louisflakes/IphoneFM/design/rev-b/front-panel-candidates.png

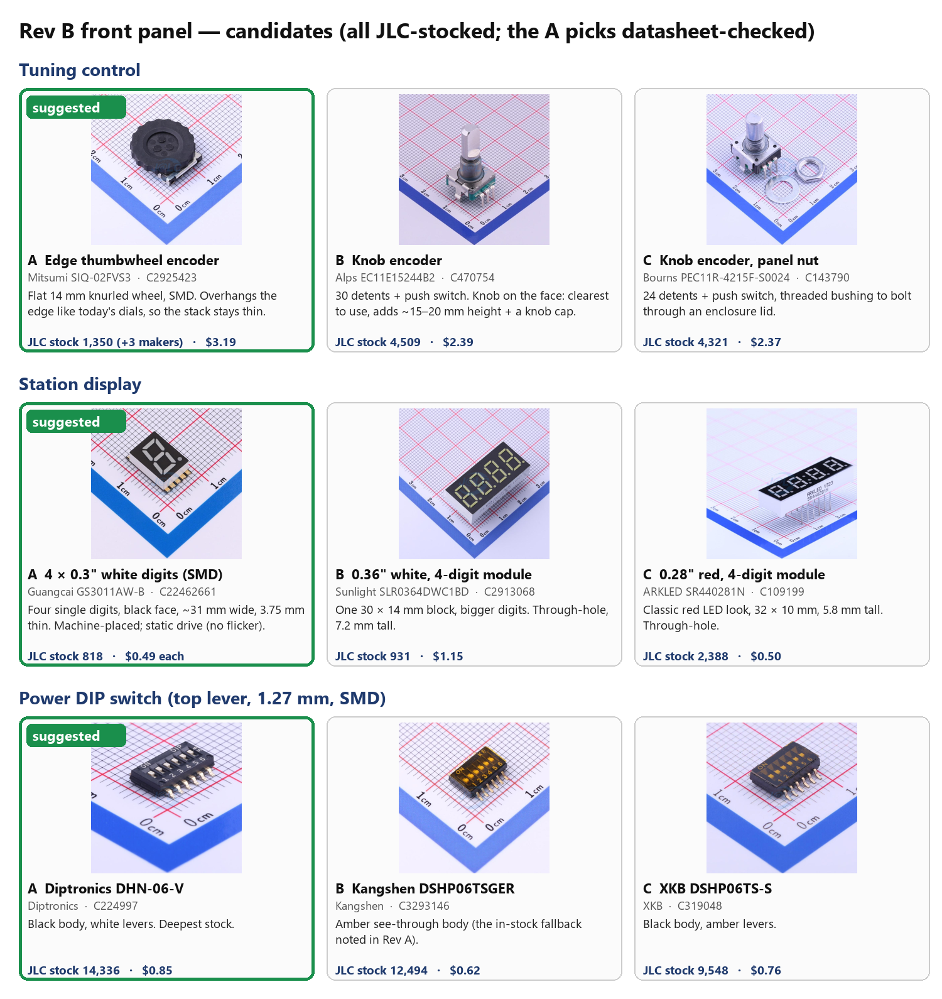
design/rev-b/front-panel-candidates.png
