louisflakes/IphoneFM/kicad/rev-b/README.md

KiCad project for IphoneFM Rev B: Rev A (tag rev-a-reviewed) with the new front panel. Built from ../../design/rev-b/build-procedure.md; checked with ../../tools/kicadcheck.py (IPHONEFM_REV=rev-b).
