louisflakes/IphoneFM/review/rev-a/README.md

# IphoneFM Rev A — design review

Start with **[IphoneFM-RevA-design-review.pdf](IphoneFM-RevA-design-review.pdf)** (4 pages). It cites datasheet pages;
the documents are linked below.

| File | What it is |
|---|---|
| [IphoneFM-RevA-design-review.pdf](IphoneFM-RevA-design-review.pdf) | Overview, key numbers, main parts, each signal chain on the schematic, what to check |
| [IphoneFM-RevA-schematic.pdf](IphoneFM-RevA-schematic.pdf) | The schematic, one A2 sheet |
| [IphoneFM-RevA-gerbers.zip](IphoneFM-RevA-gerbers.zip) | Gerbers and drill files of the JLC panel (one board in rails) |
| [IphoneFM-RevA-BOM.csv](IphoneFM-RevA-BOM.csv), [IphoneFM-RevA-CPL.csv](IphoneFM-RevA-CPL.csv) | Parts list and placement file in JLC's format |
| [IphoneFM-RevA-assembly.pdf](IphoneFM-RevA-assembly.pdf) | Assembly drawing, every reference, both sides |
| [IphoneFM-RevA-board-top.png](IphoneFM-RevA-board-top.png), [IphoneFM-RevA-board-bottom.png](IphoneFM-RevA-board-bottom.png) | The board as built, drawn from the Gerbers |
| [kicad/rev-a/](../../kicad/rev-a/) | KiCad 10 project (schematic, board, rules, footprints) |

## Datasheets cited

- [U6_USBLC6-2_ST_DS4260_Rev7.pdf](../../docs/datasheets/plan-c/U6_USBLC6-2_ST_DS4260_Rev7.pdf)
- [D3-D4_TPD1E05U06_TI.pdf](../../docs/datasheets/plan-c/D3-D4_TPD1E05U06_TI.pdf)
- [U3_AP2112_DS39724_Rev2-2.pdf](../../docs/datasheets/plan-c/U3_AP2112_DS39724_Rev2-2.pdf)
- [U1_STM32U535_DS14217_Rev5.pdf](../../docs/datasheets/plan-c/U1_STM32U535_DS14217_Rev5.pdf)
- [U1_ST_AN2606_bootloader_Rev61.pdf](../../docs/datasheets/plan-c/U1_ST_AN2606_bootloader_Rev61.pdf)
- [XO_YXC_OT322520MJBA4SL.pdf](../../docs/datasheets/analog-fm/XO_YXC_OT322520MJBA4SL.pdf)
- [PLL_TI_LMX2571_SNAS654A.pdf](../../docs/datasheets/analog-fm/PLL_TI_LMX2571_SNAS654A.pdf)
- [AN_TI_SNAA309_LMX2571_FSK.pdf](../../docs/datasheets/analog-fm/AN_TI_SNAA309_LMX2571_FSK.pdf)
- [ATT_pSemi_PE43711.pdf](../../docs/datasheets/analog-fm/ATT_pSemi_PE43711.pdf)
- [U5_PE42421_DOC-33214-1.03.pdf](../../docs/datasheets/plan-c/U5_PE42421_DOC-33214-1.03.pdf)
- [ESD_Semtech_RClamp0521PA_Rev4.pdf](../../docs/datasheets/analog-fm/ESD_Semtech_RClamp0521PA_Rev4.pdf)
- [U4_Si4704-05-D60_Rev1.2.pdf](../../docs/datasheets/plan-c/U4_Si4704-05-D60_Rev1.2.pdf)
- [U4_Skyworks_AN332_programming_guide.pdf](../../docs/datasheets/plan-c/U4_Skyworks_AN332_programming_guide.pdf)
- [U4_Skyworks_AN383_antenna_layout.pdf](../../docs/datasheets/plan-c/U4_Skyworks_AN383_antenna_layout.pdf)
- [D1_XINGLIGHT_XL-1615RGBC-RF.pdf](../../docs/datasheets/analog-fm/D1_XINGLIGHT_XL-1615RGBC-RF.pdf)
- [J1_HRO_TYPE-C-31-M-12.pdf](../../docs/datasheets/analog-fm/J1_HRO_TYPE-C-31-M-12.pdf)
- [J2_BAT_BWSMA-KWE-Z001.pdf](../../docs/datasheets/analog-fm/J2_BAT_BWSMA-KWE-Z001.pdf)
- [POT_Alps_RK10J.pdf](../../docs/datasheets/analog-fm/POT_Alps_RK10J.pdf)
- [SW1_ShouHan_MSK12C02.pdf](../../docs/datasheets/analog-fm/SW1_ShouHan_MSK12C02.pdf)
- [SW2-SW3_Panasonic_EVQP7_ANCTB21E.pdf](../../docs/datasheets/plan-c/SW2-SW3_Panasonic_EVQP7_ANCTB21E.pdf)
- [SW_CK_TDP_series.pdf](../../docs/datasheets/analog-fm/SW_CK_TDP_series.pdf)
- [L_Murata_LQW18AN_JELF243A-0024.pdf](../../docs/datasheets/analog-fm/L_Murata_LQW18AN_JELF243A-0024.pdf)
- [FB_Murata_BLM15AG_ENFA0018.pdf](../../docs/datasheets/analog-fm/FB_Murata_BLM15AG_ENFA0018.pdf)
- [USB_Type-C_R2.5_Mar2026.pdf](../../docs/datasheets/specs/USB_Type-C_R2.5_Mar2026.pdf)
- [Apple_Accessory_Design_Guidelines.pdf](../../docs/datasheets/specs/Apple_Accessory_Design_Guidelines.pdf)
- [C_FH_MLCC_catalog_0402CG101J500NT_0402CG330J500NT_0402B102K500NT_0402B223K500NT.pdf](../../docs/datasheets/analog-fm/basic/C_FH_MLCC_catalog_0402CG101J500NT_0402CG330J500NT_0402B102K500NT_0402B223K500NT.pdf)
- [C_Samsung_MLCC_catalog_CL10A105KB8NNNC_CL21A106KAYNNNE_CL21A475KAQNNNE.pdf](../../docs/datasheets/analog-fm/basic/C_Samsung_MLCC_catalog_CL10A105KB8NNNC_CL21A106KAYNNNE_CL21A475KAQNNNE.pdf)
- [R_UniRoyal_0402WGF_C25744.pdf](../../docs/datasheets/analog-fm/basic/R_UniRoyal_0402WGF_C25744.pdf)

Generated by `tools/review_doc.py --package`.
