louisflakes/IphoneFM/kicad/rev-b/fab-rules.md

# Rev A fab and assembly rules

The board-house numbers the Rev A layout is built against. Fab rules override every book figure in [docs/pcb-design-workflow.md](../../docs/pcb-design-workflow.md) [HHG p15, p63–65; BAC p4, p11]. Filled in by steps 0.3–0.6 of [kicad-build-procedure.md](../../design/rev-a/kicad-build-procedure.md).

## JLCPCB PCB capabilities, 2-layer FR-4 (step 0.3)

Source: [JLCPCB Rigid PCB Manufacturing Capabilities](https://jlcpcb.com/capabilities/pcb-capabilities), read 2026-10-21 (the page shows no revision date). Figures are for 1–2 layer boards, 1.6 mm, 1 oz outer copper, unless marked otherwise. The key rows were read twice and agree.

### Traces and copper

| Item | JLC minimum | Notes |
|---|---|---|
| Track width / spacing | 0.10 / 0.10 mm (4 / 4 mil) | Width tolerance ±20% |
| Pad to track | 0.10 mm | |
| SMD pad to pad (different nets) | 0.15 mm | |
| Smallest SMD pad | 0.25 × 0.25 mm | |

### Vias and plated holes

| Item | JLC minimum | Notes |
|---|---|---|
| Via hole / via pad | 0.15 / 0.25 mm | Preferred hole 0.2 mm or larger; pad 0.15 mm larger than the hole preferred |
| Drill range | 0.15–6.3 mm | |
| PTH annular ring | 0.18 mm absolute, 0.25 mm recommended | General table: ≥ 0.20 mm |
| Recommended PTH hole | ≥ 0.5 mm | Avoids mask or tin in the hole |
| Hole size tolerance | +0.13 / −0.08 mm | Position ±0.075 mm |
| Via hole to via hole | 0.2 mm | |
| Pad hole to pad hole | 0.45 mm | |
| Via hole to track | 0.2 mm | |
| PTH to track | 0.28 mm, 0.35 mm recommended | |
| NPTH to track | 0.2 mm | |

### Non-plated holes and slots

| Item | JLC minimum |
|---|---|
| NPTH | 0.50 mm |
| Plated slot width | 0.5 mm, length at least 2× width; tolerance +0.13 / −0.08 mm |
| Non-plated slot width | 1.0 mm; tolerance ±0.2 mm |

These matter for J1's shell slots (0.6 mm plated) and its two Ø0.6 mm locating holes, and for SW1's two Ø0.85 mm post holes.

### Solder mask

| Item | JLC figure |
|---|---|
| Mask opening | 1:1 with the pad; keep ≥ 0.09 mm from a neighbouring trace |
| Mask bridge, 1 oz | 0.10 mm (green and other colours), 0.13 mm (black, white) |

### Silkscreen

| Item | JLC minimum |
|---|---|
| Line width | 0.15 mm |
| Text height | 1.0 mm (40 mil), width:height about 1:6 |
| Pad to silkscreen | 0.15 mm |

The workflow's own rule is lines at least 0.25 mm [BAC p13; KHA p149], which is stricter.

### Outline and board

| Item | JLC figure |
|---|---|
| Copper to routed edge | ≥ 0.2 mm |
| Routed edge tolerance | ±0.2 mm (±0.1 mm high precision) |
| Thickness tolerance at 1.6 mm | ±10% (1.44–1.76 mm) |

The workflow's own floor is 0.5 mm from copper to edge [HHG p105, p113; conflict C3], which is stricter than JLC's 0.2 mm.

## JLCPCB assembly rules (step 0.4)

Sources, read 2026-10-21:
- [PCB Assembly Capabilities](https://jlcpcb.com/capabilities/pcb-assembly-capabilities) (no revision date on the page).
- [Terms and Conditions of JLCPCB Assembly Service](https://jlcpcb.com/help/article/Terms-and-Conditions-of-JLCPCB-Assembly-Service), updated 2026-09-09.
- [How to Add Edge Rails and Fiducials for PCB Assembly Orders](https://jlcpcb.com/help/article/how-to-add-edge-rails-fiducials-for-pcb-assembly-order), updated 2026-09-09.

### The two assembly services

| | Economic PCBA | Standard PCBA | Rev A |
|---|---|---|---|
| Board size | single 10 × 10 to 470 × 500 mm | single 70 × 70 to 460 × 500 mm | 46.45 × 71.40 mm: Economic as a single board; Standard needs a panel or rails |
| Thickness | 0.8–1.6 mm | any | 1.6 mm |
| Quantity | 2–50 | 2–80,000 | about 6 |
| Smallest package | 0402 | 01005 | 0402 |
| Finest IC pitch | 0.4 mm | 0.35 mm | 0.5 mm |
| Sides | one side only, SMT or through-hole | one or both | top only |
| Edge rails, fiducials | not necessary | necessary | |
| Reflow | 255 ± 5 °C | 240 ± 5 °C | |

Rev A fits Economic on every line. Whether Economic takes our two global-sourcing parts (U1, SW3) and the through-hole J2 is confirmed at the quote, step 8.5.

### Rules that apply to every assembly order

| Rule | JLC wording | Source |
|---|---|---|
| Part body to board edge | "must be equal or greater than 2.5mm" | Terms |
| Part to part | No overlaps or "very small gap"; about 0.3 mm between bodies | Terms; JLC blog |
| Footprints | IPC-7351B "medium density" or "low density"; "High density is not supported" | Terms |
| Through-hole parts | Placement checked in the 3D production file | Terms |
| Rails | At least 5 mm wide; their purpose is "to increase the distance between components and the board edge"; JLC picks a rail method itself for boards under 70 × 70 mm | Rails article; Terms |
| Fiducials | 1 mm bare copper pad, 2 mm mask opening, three or four along the edges, at least 3.35 mm from the edge | Rails article |

### What this means for Rev A

Rev A puts parts at all four edges on purpose:
- **Left:** RV1–RV3 rims 1.9 mm past the edge (2.9 until step 4.5); SW1's handle 0.9 mm past.
- **Right:** J2's barrel 7.45 mm past the edge.
- **Bottom:** J1 flush with the edge; SW2's knob 0.35 mm past.
- **Top:** SW3's levers 1.35 mm inside the edge.

So the 2.5 mm body-to-edge rule can't be met on the board itself; it has to come from rails.

**Decided 2026-10-23 (the user): rails on all four edges, in a panel we draw ourselves in Phase 8.** This replaces the earlier plan of rails on the top and bottom only, which assumed only the edges the machine grips need the 2.5 mm. JLC's pages state no such limit: the rule names no edge, and rails exist "to increase the distance between components and the board edge" (Terms; rails article, re-read 2026-10-23). Every edge has a part inside 2.5 mm: the wheels (1.9 mm past the left edge since step 4.5), D1 (about 2.35 mm from the right), J2's barrel (7.45 mm past the right), SW3 (1.35 mm from the top), J1 and SW2 at the bottom.
- **The gap between board and rail is wider than any overhang,** so no part hangs over a rail: about 2.5 mm on the left for the wheels (1.9 mm past the edge since step 4.5), about 8 mm near J2. The break-off tabs go where nothing overhangs, such as the 3 mm spaces between the wheels.
- **Fiducials on the rails,** to JLC's size and spacing.
- **Why we draw it:** if the order has no rails, JLC adds its own by its own method and "will not take the final responsibility" for special needs (Terms). A standard 1.6–2 mm gap would put the wheels on top of the rail.
- **Details wait for Phase 8** (steps 8.3, 8.5). Nothing changes on the board file or in placement.

Two more rules carry into later phases:
- **Phase 2 (footprints):** use IPC-7351B nominal (medium-density) footprints, which is what KiCad's library uses.
- **Phase 4 (placement):** keep at least 0.3 mm between part bodies; our own rule M11 already asks for 2 mm.

## Our design rules (step 0.5)

A step above JLC's minimums, never at them [HHG p15, p63–64]. These are what get entered in KiCad's Board Setup in phase 3, step 3.2.

| Rule | JLC minimum | Ours | Why |
|---|---|---|---|
| Clearance, copper to copper | 0.10 mm | **0.20 mm** | Twice the minimum; still fits the 0.5 mm-pitch QFN pads |
| Track width, signals | 0.10 mm | **0.20 mm** | Twice the minimum; fans out of 0.25 mm QFN pads |
| Track width, power (VBUS, 3V3, VDDA, RX_VDD) | | **0.40 mm** | Peak about 0.11 A; KHA gives 0.15 mm for 0.5 A at a 10 °C rise in 1 oz copper (p184), so 0.40 mm is ample and keeps the voltage drop small |
| Track width, RF (ANT, TX and RX paths) | | **0.92 mm, 0.20 mm gap (step 0.6)** | Grounded coplanar line [AN4169 p6, p11] |
| Via drill / pad | 0.15 / 0.25 mm (0.2 mm drill preferred) | **0.30 / 0.60 mm** | A 0.15 mm ring; also JLC's standard via, at no extra cost |
| PTH annular ring | 0.18 mm (0.25 recommended) | **0.25 mm** | JLC's recommended figure |
| Hole to hole | 0.20 mm (vias), 0.45 mm (pads) | **0.50 mm** | Above both |
| Hole to copper | 0.20–0.28 mm | **0.30 mm** | Above JLC's PTH-to-track figure |
| Copper to board edge | 0.20 mm | **0.50 mm** | The workflow's floor [HHG p105, p113; conflict C3]; the edge parts in layout.html were placed with 0.5 mm already |
| Solder mask | 1:1, bridge 0.10 mm | **1:1 (0 expansion), 0.10 mm minimum bridge** | JLC opens the mask 1:1; KiCad's mask expansion set to 0 so their figure isn't added twice |
| Silkscreen to pad | 0.15 mm | **0.20 mm** | |
| Silkscreen lines (outlines, marks) | 0.15 mm | **0.25 mm** | The workflow's rule [BAC p13; KHA p149] |
| Silkscreen text | 1.0 mm high, 0.15 mm stroke | **1.0 mm high, 0.15 mm stroke** | The board is small, so text stays at JLC's minimum height; a 0.25 mm stroke on 1 mm text would close up the letters |
| Part body to body | about 0.3 mm | **0.3 mm courtyard gap; 2 mm in our own placement rule M11** | |

### Net classes

| Class | Nets | Track | Clearance | Why |
|---|---|---|---|---|
| Default | everything else | 0.20 mm | 0.20 mm | |
| Power | VBUS, 3V3, VDDA, RX_VDD | 0.40 mm | 0.20 mm | |
| RF | ANT, LMX_RF, ATT_IN, TX_RF_ATT, TX_LPF_MID, TX_RF, RX_RF, FMI_MATCH, FMI | 0.92 mm | 0.20 mm | 50 Ω grounded coplanar (step 0.6) |
| Clock | FSK_CLK(_MCU), REF20(_MCU), RX_RCLK, RX_SCK(_MCU), LMX_CLK | 0.20 mm | **0.40 mm between tracks** (0.20 at pins) | Switching lines kept further from their neighbours [HHG p64; LMX2571 p55]. The 0.40 mm applies from a clock track to other nets' tracks and vias, in IphoneFM.kicad_dru; pins inside a part keep 0.20 mm, since the ICs' clock pins are 0.25 mm apart (step 4.3, the user's choice) |

GND gets no class of its own; it's poured on both layers in phase 6.

### Rev B exception: U8's fan-out (step B5.3, the user's approval 2026-11-06)

The rules above are a margin over JLC's minimums, sized for Rev A's finest part (a 0.5 mm-pitch QFN); none of them is
electrical. U8 (IS31FL3236A, QFN-44) has 0.4 mm pitch and its left side faces the board edge with 1.8 mm to the 0.5 mm
edge rule: at 0.20 mm tracks and gaps and 0.6/0.3 mm vias only about 26 of its 32 outputs can be routed. Inside rule
areas named "U8 fan-out" (around U8 on both layers, the bottom layer under DS1 where the bottom bus widens out, and the
top layer just below U8's bottom pins), in IphoneFM.kicad_dru:

| Rule | JLC minimum | Ours | In the U8 fan-out areas | What is left of the margin |
|---|---|---|---|---|
| Copper to copper | 0.10 mm | 0.20 mm | **0.127 mm** | 27% over JLC; at the worst etch tolerance (±20%) about 0.10 mm |
| Track width | 0.10 mm | 0.20 mm | **0.127 mm** | as above; the segment lines carry at most 7.6 mA (0.10 mm carries about 0.5 A) |
| Via pad / hole | 0.25 / 0.15 mm; a hole under 0.30 mm is priced as high-precision | 0.60 / 0.30 mm | **0.45 / 0.30 mm** (Rev C; Rev B had 0.40 / 0.20) | JLC's standard hole; 0.075 mm ring (JLC 0.05, preferred 0.075); the workflow's sizing method [HHG p65–67] gives about 0.45 mm |
| Hole to copper | 0.20 mm | 0.30 mm | **0.20 mm** | Rev C: no line passes between two vias; the closest holes are 0.20 mm from a line (via centre 0.4155 mm from the line's centre) |

The 0.50 mm copper-to-edge rule is kept (the outer vias are 0.64 mm from the edge), as is the 0.50 mm hole-to-hole rule.
Nothing wider fits: a line between two vias 0.8 mm apart leaves 0.4 mm between their pads, and a 0.127 mm line with
0.127 mm gaps needs 0.38 mm (0.15 mm needs 0.45; a 0.45 mm via pad leaves 0.35).

Rev C (2026-11-11, branch `rev-c`): JLC prices any via hole under 0.30 mm as high-precision (plugged vias and a 4-wire
test, about $51 more for 5 panels). A 0.30 mm hole needs 0.35 mm from its centre to other copper, which a line
threading between two vias 0.8 mm apart can't give (0.34 mm). So U8's left side was re-planned with no line between
two vias: odd pins out to vias at x 14.35, even pins in, past their heels, to vias at x 16.39 between the pin ring and
the exposed pad (0.127 mm from both); each column comes down the bottom in its own lanes. The fan-out vias are
0.45 / 0.30 mm.

## 50 Ω line for the antenna path (step 0.6)

Source: [JLCPCB Impedance Calculator](https://jlcpcb.com/pcb-impedance-calculator), run 2026-10-21. Settings: rigid, 2 layers, 1.6 mm, 1 oz outer copper; 50 Ω, coplanar single-ended (with solder mask), signal on L1 (top), reference L2 (bottom). JLC's stack-up for this is **JLC0216A**: 0.030 mm copper, 1.43 mm FR-4 core, 0.030 mm copper.

| Gap, trace to ground copper | Trace width for 50 Ω |
|---|---|
| **0.20 mm** | **0.918 mm** |
| 0.25 mm | 1.146 mm |
| 0.30 mm | 1.317 mm |
| 0.508 mm (calculator default) | 1.772 mm |

**Chosen: a 0.92 mm trace with a 0.20 mm gap to the top ground pour, over the solid bottom ground.**
- The 0.20 mm gap equals our general clearance rule (step 0.5), so the pour needs no special setting.
- It gives the narrowest line, which suits the small RF pads it joins: U2's 0.25 mm pin, U5's 0.4 mm pads, 0402 parts. The line necks down at each pad. At 100 MHz that costs nothing: a few millimetres against a wavelength of about 1.75 m in this board, by my estimate.

**Cross-check (my own, not JLC's):** a closed-form grounded-coplanar formula, using zero-thickness copper, no solder mask and εr 4.3–4.6, gives 54–56 Ω for 0.92 / 0.20 mm. Solder mask and copper thickness both pull it a few ohms lower, so the formula and JLC agree. The KiCad MCP server's simpler formula, which leaves out the bottom ground, gives 58 Ω; that one is a first-order estimate only.

**How much it matters:** JLC doesn't control impedance on 2-layer boards, and our RF runs are a few centimetres, well under λ/10 at 108 MHz (conflict C9 in the workflow). So 50 Ω is the design target that keeps reflections negligible, not a tolerance we need the fab to hold.

**How the line is built** [AN4169 p6, p11; ADI "Coplanar Waveguide"]:
- Top-layer ground pour on both sides, with a row of stitching vias to the bottom ground along each side.
- The bottom layer under the line is solid ground, with no other routing.

This fills in the RF net class from step 0.5: track 0.92 mm, clearance 0.20 mm.
