louisflakes/IphoneFM/kicad/rev-b/footprints.md

# Rev B footprints

Rev A's footprints (Phase 2), unchanged, except the front panel (Rev B Phase B3, 2026-11-06). The wheels RV1–RV3 and
their footprint are gone. SW3 is now the Diptronics DHN-06-V. U8, DS1–DS4 and SW4 are new. Each new part was looked for
in KiCad's library first; none has a KiCad footprint (KiCad has no 5 × 5 mm 0.4 mm-pitch QFN-44, no GS3011 and no SIQ
encoder), so U8, DS1–DS4 and SW4 are built from the maker's own land pattern by `tools/fp_rev_b.py`. SW3 keeps KiCad's
Omron A6H-6101 pads, which are Diptronics' layout exactly. Each was checked against its maker's drawing on a to-scale
overlay ([../../design/rev-b/footprint-overlays.png](../../design/rev-b/footprint-overlays.png)).

LCSC's own footprints (EasyEDA, read 2026-11-06) were read as a second opinion only; the makers' drawings decide:
- GS3011AW-B: matches Guangcai exactly.
- SIQ-02FVS3: matches Mitsumi except the two angled frame tabs, whose centres LCSC puts 4.0 mm from the knob centre.
  Mitsumi's "2–4" is to the tabs' inner ends: the PDF's own vectors put the centres 4.60 mm out.
- IS31FL3236A: narrower 0.20 × 0.90 mm pads, and no joins to the centre pad.
- DHN-06-V: rows 5.25 / 7.95 mm, not Diptronics' 4.90 / 7.40.

The Rev A text below is kept as it was; its SW3 and RV1–RV3 rows are replaced by the Rev B rows.

# Rev A footprints (Phase 2)

Each part's footprint source, chosen in the order step 2.1 sets: KiCad's own library, then the maker's own land pattern, then LCSC/EasyEDA. A KiCad footprint named for the exact part is preferred over a generic one. Nothing here is final until step 2.2 has compared its pads with the datasheet's land pattern; that column records the result.

**Silkscreen (step 2.4, 2026-10-23):** every footprint the board uses is a copy in `IphoneFM.pretty` whose silkscreen `tools/fp_silk_trim.py` has widened to 0.25 mm and cut back to stay 0.20 mm from copper and holes (fab-rules.md); the Footprint column below names each one's source. The trimming leaves no outline on the 0402 and 0603 parts, the test pads and D5 (all work either way round); every pin-1 mark is a round dot 0.55 mm across (the user's choice over KiCad's triangles), moved outward where needed, and D1 and Y2 get one beside pad 1 in place of their trimmed corner marks. Run fp_silk_trim.py after any of the fp_*.py builders.

**Followed up with the user at their 2.2 steps (asked 2026-10-22):** U4 and SW2; see their rows.

**Rule for checking (agreed 2026-10-22):** a KiCad *package* footprint (generic, computed to IPC-7351B nominal, our Phase 0 convention) is kept when what must match does: pin count, pitch, pin 1 and numbering, body size and any exposed pad's size; pad-shape differences from a maker's "footprint example" don't count against it. A footprint copied from one maker's drawing (like J1), or one we build, must match that maker's drawing exactly.

Sources: **KiCad (part)** is a KiCad library footprint named for this part; **KiCad (generic)** is a KiCad footprint for the package, used only if its pads match the maker's land pattern; **Maker** is drawn from the land pattern in the maker's datasheet. No part needs LCSC/EasyEDA.

| Parts | Part number | Package | Source | Footprint | Datasheet land pattern | 2.2 check |
|---|---|---|---|---|---|---|
| J1 | HRO TYPE-C-31-M-12 | USB-C receptacle | KiCad (part), pads updated to the maker's 2020 layout | IphoneFM:USB_C_Receptacle_HRO_TYPE-C-31-M-12_2020 | J1_HRO_TYPE-C-31-M-12 p1 (2020-12-08) | Done 2026-10-22. KiCad's footprint follows HRO's 2015 drawing (archived copy in J1_HRO_TYPE-C-31-M-12_2015_superseded.pdf); HRO's 2020 drawing shortens the signal pads to 1.14 mm (0.50–1.64 mm behind the peg holes), moves the wide pads to ±2.40/±3.20 mm, makes the peg holes Ø0.60, the rear shell slots 0.6 × 1.4 mm in 0.9 × 1.7 pads and the front slot pads 0.9 × 2.0. The project copy (tools/fp_j1_hro2020.py) takes those values; outline, courtyard and 3D model are KiCad's. Board edge: 5.79 mm in front of the peg holes. Approved by the user. Changed at step 3.2 (2026-10-23, the user's choice): HRO's shell pads leave a 0.15 mm copper ring, under JLC's 0.18 mm minimum, so each is 0.2 mm bigger both ways (1.1 × 2.2 front, 1.1 × 1.9 rear) for a 0.25 mm ring; slots and positions unchanged; 0.275 mm copper and 0.525 mm hole clearance to the nearest signal pad |
| U1 | ST STM32U535CEU6 | UFQFPN-48 7 × 7, EP | KiCad (generic) | Package_DFN_QFN:QFN-48-1EP_7x7mm_P0.5mm_EP5.6x5.6mm | DS14217 p268–269 (Table 140, Figure 74) | Pass 2026-10-22: 48 pads at 0.50 mm, pin 1 top-left, counter-clockwise, 7 × 7 mm body, 5.60 × 5.60 mm exposed pad numbered 49. ST's example uses 0.30 × 0.55 mm pads (KiCad's IPC pads are 0.25 × 0.875); kept KiCad's per the rule above |
| U2 | TI LMX2571NJKR | WQFN-36 6 × 6, DAP (NJK) | Maker (KiCad's 6 × 6 QFN-36s have 3.7, 3.9, 4.1 or 4.4 mm centre pads; TI's is 4.6) | IphoneFM:TI_NJK0036A_WQFN-36-1EP_6x6mm_P0.5mm_EP4.6x4.6mm | SNAS654A p61 (NJK0036A recommended land pattern) | Built 2026-10-22 (tools/fp_u2_ti_njk.py) to TI's drawing: 36 pads 0.25 × 0.6 mm at 0.50 mm, centres on a 5.8 mm span, 4.60 × 4.60 mm centre pad numbered 37 (the symbol's DAP), 0.3 mm gap; pin 1 at a corner, counter-clockwise. TI shows no stencil, so the centre pad's paste is KiCad's 4 × 4 pattern for a 4.6 mm pad. Outline, courtyard and 3D model from KiCad's QFN-36. Approved by the user |
| U3 | Diodes AP2112K-3.3TRG1 | SOT-25 | KiCad (generic) | Package_TO_SOT_SMD:SOT-23-5 | DS39724 p14 (SOT25 suggested pad layout); pins p2 | Pass 2026-10-22: 5 pads at 0.95 mm, pins 1–3 down one side and 4–5 back up the other (pin 4 is the unused one), 1.6 × 2.9 mm body within Diodes' 1.5–1.7 × 2.9–3.1. Diodes suggests 0.55 × 0.80 mm pads, rows 2.40 mm apart (centre to centre); KiCad's IPC pads are 0.60 × 1.33, rows 2.28 mm apart, and fully cover Diodes' pads. Kept KiCad's per the rule above. Approved by the user |
| U4 | Skyworks SI4705-D60-GM | QFN-20 3 × 3, 0.5 mm, EP | KiCad (generic) | Package_DFN_QFN:SiliconLabs_QFN-20-1EP_3x3mm_P0.5mm_EP1.8x1.8mm (drawn from Silicon Labs' EFM8BB1 drawing) | Si4704/05-D60 Rev 1.2 p29 (package), p31–32 (Figure 14, Table 16) | Pass 2026-10-22, the user's decision: 20 pads at 0.50 mm with the same corner pads (1, 6, 11, 16), 3 × 3 mm body, 1.80 mm centre pad numbered 21 (within Skyworks' 1.60–1.80). Skyworks' pattern differs in pad size (sides 0.28 × 0.61 vs KiCad's 0.30 × 0.90, corners 0.34 vs 0.30 square, rows 2.71 vs 3.10 mm apart) and centre-pad paste (one 1.45 mm square, about 73%, vs KiCad's four 0.54 mm squares, about 36%). Reviewed on a to-scale overlay; the user kept KiCad's. Changed at the Phase 2 review (step 2.8, 2026-10-23, the user's choice): `tools/fp_u4_si4705.py` narrows the 16 side pads to Skyworks' 0.28 mm and opens the solder mask 0.06 mm round every pad, as Skyworks asks (p32); the mask strip between neighbouring pins is then 0.10 mm, JLC's minimum, while the narrower strips beside the corner pads (0.09) and next to the centre pad (0.08) are left out by JLC, as they would be on Skyworks' own pattern. Approved by the user |
| U5 | pSemi PE42421SCAA-Z | SC-70-6 | KiCad (generic) | Package_TO_SOT_SMD:SOT-363_SC-70-6 | PE42421 DOC-33214-1.03 p9 (Figure 14, recommended land pattern); pins p8 | Pass 2026-10-22: 6 pads at 0.65 mm, pins 1–3 down one side and 4–6 back up the other, 1.25 × 2.0 mm body within pSemi's 1.25 × 2.0–2.2. pSemi gives minimum pads of 0.40 × 0.50 mm with rows 1.90 mm apart; KiCad's IPC pads are 0.35 × 1.03 with rows 1.68 apart, 0.05 mm narrower than pSemi's minimum but still wider than the leads (0.15–0.30). KiCad's pads also run about 0.30 mm under the body (IPC heel space; pSemi's start just outside it), as U3's do; the user asked about this and accepted it. Kept KiCad's per the rule above. Approved by the user |
| U6 | ST USBLC6-2SC6 | SOT-23-6 | KiCad (generic) | Package_TO_SOT_SMD:SOT-23-6 | USBLC6-2 DS4260 Rev 7 p12–13 (Table 3, Figure 19); pins p1 | Pass 2026-10-22: 6 pads at 0.95 mm, pins 1–3 down one side and 4–6 back up the other, matching ST's pin diagram and our pin names; 1.6 × 2.9 mm body within ST's 1.5–1.75 × 2.8–3.05. ST recommends 0.60 × 1.20 mm pads with rows 2.30 mm apart; KiCad's are 0.60 × 1.33 with rows 2.28 apart, nearly the same. Kept KiCad's per the rule above. (Checked against ST's current datasheet, which replaced a 2005 mirror copy.) Approved by the user |
| U7 | pSemi PE43711B-Z | QFN-24 4 × 4, EP | KiCad (generic) | Package_DFN_QFN:QFN-24-1EP_4x4mm_P0.5mm_EP2.75x2.75mm | PE43711 DOC-84940-8 p29 (Figure 36, recommended land pattern); pins p28 | Pass 2026-10-22: 24 pads at 0.50 mm, pin 1 at the top of the left side, counter-clockwise, 4 × 4 mm body, 2.75 × 2.75 mm centre pad numbered 25, the same as pSemi's land pattern (the chip's own pad is 2.70). pSemi's pads are 0.30 × 0.60 mm, 4.40 mm outer edge to edge; KiCad's IPC pads are 0.25 × 0.80, 4.35 mm. pSemi gives no stencil; KiCad's centre-pad paste is four 1.11 mm squares (about 65%). Kept KiCad's per the rule above. Approved by the user |
| Y2 | YXC OT322520MJBA4SL | 3225 4-pad XO | KiCad (part, another maker's 3.2 × 2.5) | Oscillator:Oscillator_SMD_SiT_PQFN-4Pin_3.2x2.5mm | XO_YXC_OT322520MJBA4SL p2 (pins), p3 (3.2 × 2.5 recommended soldering pattern) | Pass 2026-10-22: no KiCad footprint is drawn to YXC's pattern; of the four 3.2 × 2.5 mm 4-pad ones, SiTime's is closest. Same 4 pads, pin 1 bottom left and counter-clockwise (1 tri-state, 2 GND, 3 output, 4 VDD), same pad height (1.20), same gaps between pads (0.80 × 0.70) and same up/down spacing (1.90); SiTime's pads are 1.40 wide against YXC's 1.30, so they reach 0.10 mm further out on each side and fully cover YXC's. Abracon's pads are 0.1 mm shorter and 1.65 mm apart up/down; Epson's are 2.40 apart across; EuroQuartz's are turned 90°. Approved by the user |
| D1 | XINGLIGHT XL-1615RGBC-RF | 1615 RGB, 4-pad | Maker (KiCad has no 1.6 × 1.5 mm RGB LED) | IphoneFM:LED_RGB_XINGLIGHT_XL-1615RGBC_1.6x1.5mm | XL-1615RGBC-RF p8 (outline, pins, recommended soldering pattern) | Built 2026-10-22 (tools/fp_d1_xl1615.py) to Xinglight's pattern: four 0.45 × 0.65 mm pads, 0.80 mm apart across and 0.30 mm up/down (1.70 × 1.60 mm outer edges), covering the LED's 0.33 × 0.55 mm terminals. Numbered as the top view shows: 1 (red) top left, 2 (common anode) bottom left, 3 (green) top right, 4 (blue) bottom right, matching our pin names. Silkscreen 0.2 mm clear of the pads with a pin-1 corner mark; keep-out 2.4 × 2.3 mm. No 3D model (none in KiCad). Approved by the user |
| D3, D4 | TI TPD1E05U06DPYR | X2SON-2 (DPY) | KiCad (part) | Package_SON:Texas_DPY0002A_0.6x1mm_P0.65mm | TPD1E05U06 SLVSBO7O (Aug 2024) p34–36 (DPY0002A outline, example board layout, stencil) | Pass 2026-10-22: drawn from this TI package. Two 0.30 × 0.50 mm pads with centres 0.70 mm apart and paste the same size as the pads, as TI shows; pin 1 (IO, to CC) on the left at TI's index area, pin 2 GND; 1.0 × 0.6 mm body. Only difference: corner rounding 0.075 mm against TI's 0.05. Approved by the user |
| D5 | Semtech RCLAMP0521PATCT | SLP1006P2 | KiCad (generic) | Diode_SMD:D_SOD-882 (DFN1006-2); project copy with paste 1:1 (tools/fp_d5_sod882.py, step 2.5) | RClamp0521PA Rev 4.0 (8/29/2017) p4 (outline, land pattern) | Pass 2026-10-22: 2 pads, terminals 0.65 mm apart, 1.0 × 0.6 mm body within Semtech's 0.95–1.05 × 0.55–0.65; the diode is symmetrical, so either way round works (pin 1 to ANT, pin 2 to GND as on the schematic). Semtech's pads are 0.55 × 0.60 mm with centres 0.85 apart (1.40 edge to edge); KiCad's are 0.40 × 0.70 with centres 0.70 apart (1.10 edge to edge); both cover the diode's 0.25 × 0.50 mm terminals and leave the same 0.30 mm gap. Kept KiCad's per the rule above. (Checked against Semtech's own Rev 4.0, which replaced a 2010 LCSC copy.) Approved by the user |
| J2 | BAT Wireless BWSMA-KWE-Z001 | SMA, right angle, THT | KiCad (part) | Connector_Coaxial:SMA_BAT_Wireless_BWSMA-KWE-Z001 | J2_BAT_BWSMA-KWE-Z001 (July-2-2025-A01) p6 (mechanical drawing, PCB layout) | Pass 2026-10-22: drawn from this datasheet. Five 1.4 mm holes, the centre pin (pad 1, antenna) and four legs (pad 2, ground) 2.55 mm out on a 5.1 mm square, as BAT's PCB layout shows; the holes clear the 0.9 mm round centre pin and 0.9 mm square legs. BAT gives no copper ring size; KiCad's are a 2.3 mm square (centre) and 2.2 mm round (legs). 6 × 6 mm body, barrel toward the board edge. Approved by the user |
| SW1 | Shou Han MSK12C02 | SMD slide switch, 4 tabs | KiCad (part), tabs renumbered | IphoneFM:SW_SPDT_Shouhan_MSK12C02_Tabs4 (KiCad's Button_Switch_SMD:SW_SPDT_Shouhan_MSK12C02 with the four tab pads numbered 4; tools/fp_sw1_msk12c02.py, step 2.3) | SW1_ShouHan_MSK12C02 p1 (top view with pin numbers, mounting reference drawing) | Pass 2026-10-22: drawn from this drawing (turned 180°). Three 0.60 × 1.30 mm pin pads 3.0 then 1.5 mm apart, four 1.05 × 0.70 mm tab pads 8.4 mm across and 2.2 mm apart (centres), two 0.85 mm peg holes 3.0 mm apart; pin 1 (TX, 3V3) is the pad 3.0 mm from pin 2, as Shou Han numbers it. KiCad names the four tab pads "SH" while the symbol's tab pin is 4, so step 2.3 found them unconnected; at the user's choice the project copy numbers them 4, as Shou Han's drawing does. Approved by the user |
| SW2 | Panasonic EVQ-P7J01P | side-push SMD tactile | KiCad (part, EVQ-P7 series) | Button_Switch_SMD:SW_SPST_EVQP7A | SW2-SW3_Panasonic_EVQP7_ANCTB21E (2025-07) p2 (EVQP7A/EVQP7J drawing, circuit, land pattern), p3 (EVQP7C/P7L, with boss) | Pass 2026-10-22: Panasonic draws the P7J on the same page as the P7A (straight terminals, no locating boss); the P7C is the version with a boss, whose KiCad footprint adds two 0.7 mm peg holes. KiCad's EVQP7A matches Panasonic's land pattern: four 1.40 × 1.05 mm pads, 5.0 mm across with a 2.2 mm gap, 2.49 mm up/down with a 0.39 mm gap (Panasonic 2.5 / 0.4); terminals 1 and 1′ on the side away from the knob, 2 and 2′ on the knob side. KiCad numbers both top pads 1 and both bottom pads 2; the symbol (Switch:SW_Push) has pins 1 and 2, so each pin takes both of its pads, which Panasonic's circuit joins inside the switch (checked in step 2.3). Approved by the user |
| SW3 | Diptronics DHN-06-V | SMD DIP, 6 positions, 1.27 mm, top actuated | KiCad (part, another maker's pads) | IphoneFM:SW_DIP_SPSTx06_Slide_Diptronics_DHN-06_W6.15mm_P1.27mm | DIP_Diptronics_DHN-06-V p41 (DHN outline, P.C.B. layout) | Rev B, 2026-11-06: pass. KiCad's SW_DIP_SPSTx06_Slide_Omron_A6H-6101_W6.15mm_P1.27mm has Diptronics' layout exactly: twelve 1.25 × 0.76 mm pads at 1.27 mm pitch, rows 4.90 mm apart inside and 7.40 outside. The pads are copied unchanged (tools/fp_rev_b.py). The fab layer draws Diptronics' 8.85 × 4.50 mm body (Omron's is 8.89 × 4.50), with "ON" on the side of pins 7–12. Diptronics doesn't number the terminals, so the standard DIP numbering is used, as in Rev A: pins 1–6 down the row under the switch numbers, 7–12 back up the other, switch n joining pins n and 13 − n (netlist.json). Silkscreen: body ends and a pin-1 dot; keep-out 7.9 × 9.52 mm |
| U8 | Lumissil IS31FL3236A-QFLS2-TR | QFN-44 5 × 5 mm, 0.4 mm, EP | Maker (KiCad has no 5 × 5 mm 0.4 mm-pitch QFN-44) | IphoneFM:Lumissil_QFN-44-1EP_5x5mm_P0.4mm_EP2.45x2.45mm | DRV_Lumissil_IS31FL3236A_DS (Rev. I, 10/14/2024) p14 (package), p16 (recommended land pattern) | Rev B, built 2026-11-06 (tools/fp_rev_b.py) to Lumissil's pattern. 44 pads 0.25 × 1.00 mm at 0.40 mm, 2.0 to 3.0 mm out (rows 4.0 mm apart inside, 6.0 outside). The eight corner pads are 0.80 mm long (2.2 to 3.0 mm out). The 2.45 × 2.45 mm centre pad (45) is joined, as Lumissil draws it, to the middle pads of the top and bottom rows (pins 39 and 17, both GND). Pin 1 is top left, counter-clockwise, which matches p2 and the evaluation board. Lumissil rounds the facing corners of the corner pads (R0.125) and the two joins (R0.1). KiCad can't round a single pad corner, so those corners are chamfered 0.125 mm instead, which leaves 0.21 mm between corner pads (Lumissil 0.20), and the joins are square. Paste is 1:1 on the pins. Lumissil gives no stencil, so the centre pad gets KiCad's four 0.99 mm windows for a 2.45 mm pad (65%). Mask 1:1 leaves 0.15 mm webs between pins, over JLC's 0.10. Copper between pins is 0.15 mm, under our 0.20 mm board rule; this needs a U8 rule at board setup (JLC's minimum is 0.10). Silkscreen: pin-1 dot only (the body corners fall within the pads' clearance). Keep-out 6.5 × 6.5 mm |
| DS1–DS4 | Guangcai GS3011AW-B | 0.3 in SMD 7-segment, 7.3 × 12.0 mm, 10 castellated terminals | Maker (KiCad has no GS3011) | IphoneFM:LED_7Segment_Guangcai_GS3011_7.3x12mm_P1.5mm | DISP_Guangcai_GS3011AW-B (GS3011A/CX-X 2020-09-20 Rev. A) p2 (outline), p3 (pin positions), p5 (soldering pad size) | Rev B, built 2026-11-06 (tools/fp_rev_b.py) to Guangcai's soldering pads: ten 1.00 × 3.00 mm pads at 1.50 mm pitch, rows 9.50 mm apart inside, 12.50 centre to centre and 15.50 outside. Numbered as the top view (p3) shows: 1–5 along the bottom (the decimal-point side) left to right, 6–10 along the top right to left. This matches the symbol (KiCad's KCSA02-105 pinout, anodes 3 and 8). The pads reach 1.75 mm past each end of the 12.0 mm body, so each digit takes 15.5 mm, not 12 (for placement). Paste 1:1 (no stencil given). The fab layer draws the leaning 8 and the decimal point. Silkscreen: the body's long sides and a pin-1 dot. Keep-out 8.0 × 16.0 mm. Step B5.1: pads 3 and 8 (the common anode) are one node inside the part (p3, "3,8"), declared as a jumper pad group so KiCad treats them as joined; the board feeds VBUS to pin 8 only |
| SW4 | Mitsumi SIQ-02FVS3 | push-wheel encoder, reflow, 4 terminals and 6 frame tabs | Maker (KiCad has no SIQ encoder) | IphoneFM:RotaryEncoder_Switch_Mitsumi_SIQ-02FVS3 | ENC_Mitsumi_SIQ-02FVS3 (SIQ series) p3 (SIQ-02FVS3 dimensions, land dimensions, circuit) | Rev B, built 2026-11-06 (tools/fp_rev_b.py), origin at the knob centre, terminals toward +y. Terminals 1–4 (A, S, C, B left to right, as Mitsumi's views show them) are 1.3 × 1.2 mm at x −4, −1.475, 1.475, 4 (2.95 and 8 mm apart), y 7.1–8.3. Frame tabs 5–8 are 1.2 × 1.3 mm, 9.6 mm apart inside, at y 1.3 and 5.4. Frame tabs 9 and 10 are 0.85 × 1.2 mm on the 45° lines toward the knob, from 4.0 to 5.2 mm from the centre. Mitsumi dimensions "2–4" to their inner ends; read from the PDF's vectors, their centres are 4.60 mm out. LCSC's footprint puts the centres at 4.0, 0.6 mm in. Two unplated Ø1.6 mm holes (+0.05/0), 6 mm apart and 4.5 mm below the centre, take the frame's Ø1.55 mm bosses. All frame tabs are GND. Paste 1:1, as Mitsumi's stencil (150 µm, 100% apertures). Silkscreen: the wheel's Ø14.7 mm outline, broken at the pads, and a dot by terminal 1. Keep-out 15.0 × 16.25 mm. The knob overhangs everything inside its circle, so parts there must clear its underside (height from Mitsumi's side view, at placement) |
| TP1–TP8 | — | test pad, top side | KiCad (generic) | TestPoint:TestPoint_Pad_D1.5mm | — (our own size) | Pass 2026-10-22: one 1.5 mm round copper pad with a solder-mask opening and no paste, so it stays bare for a probe; silkscreen ring 1.9 mm, keep-out 2.5 mm. KiCad marks it out of the BOM and pick-and-place files, so nothing is placed. Size suits a scope probe tip or a spring pin; no maker drawing applies. Approved by the user |
| R (×27) | Yageo RC0402 / Panasonic ERJ-2R | 0402 | KiCad (generic, IPC) | Resistor_SMD:R_0402_1005Metric | R_Yageo_mounting_V10 Table 1; R_Panasonic_land_pattern p1 | Pass 2026-10-22: KiCad gap 0.48, outer 1.56, width 0.64; Yageo RC0402 gap 0.5, outer 1.5, width 0.6; Panasonic 1005 gap 0.5–0.6, outer 1.4–1.6, width 0.4–0.6. Pads are 2, body the same size; KiCad's IPC pads cover the maker's. Kept KiCad's per the rule above. Approved by the user |
| C (×33 in 0402) | Samsung, Murata, Yageo | 0402 | KiCad (generic, IPC) | Capacitor_SMD:C_0402_1005Metric | MLCC_Murata_C02E Table 2 p278 (GRM15; Samsung's catalog excerpt has no land table) | Pass 2026-10-22: KiCad gap 0.40, outer 1.52, width 0.62; Murata gap 0.3–0.5, land length 0.35–0.45, width 0.4–0.6 (outer about 1.2). Pads are 2, body the same size; KiCad's IPC pads cover the maker's. Kept KiCad's per the rule above. Approved by the user |
| C1, C2, C8, C23, C27 | Samsung CL10 | 0603 | KiCad (generic, IPC) | Capacitor_SMD:C_0603_1608Metric | MLCC_Murata_C02E Table 2 p278 (GRM18, as the MLCC reference) | Pass 2026-10-22: KiCad gap 0.65, outer 2.45, width 0.95; Murata gap 0.6–0.8, land length 0.6–0.7, width 0.6–0.8 (outer about 2.0). Pads are 2, body the same size; KiCad's IPC pads cover the maker's. Kept KiCad's per the rule above. Approved by the user |
| C3, C9, C12 | Samsung CL21, Murata GRM21 | 0805 | KiCad (generic, IPC) | Capacitor_SMD:C_0805_2012Metric | MLCC_Murata_C02E Table 2 p278 (GRM21) | Pass 2026-10-22: KiCad gap 0.90, outer 2.90, width 1.45; Murata gap 1.0–1.4, land length 0.6–0.8, width 1.2–1.4 (outer about 2.4). Pads are 2, body the same size; KiCad's IPC pads cover the maker's. Kept KiCad's per the rule above. Approved by the user |
| L1–L3 | Murata LQW18AN | 0603 | KiCad (generic, IPC) | Inductor_SMD:L_0603_1608Metric | L_Murata_LQW18AN_JELF243A-0024 §12.1 | Pass 2026-10-22: KiCad gap 0.70, outer 2.45, width 0.95; Murata gap 0.6–0.8, outer 1.9–2.0, width 0.7–1.0. Pads are 2, body the same size; KiCad's IPC pads cover the maker's. Kept KiCad's per the rule above. Approved by the user |
| FB1–FB3 | Murata BLM15 | 0402 | KiCad (generic, IPC) | Inductor_SMD:L_0402_1005Metric | FB_Murata_BLM15AG_ENFA0018 §12.1 | Pass 2026-10-22: KiCad gap 0.38, outer 1.56, width 0.64; Murata gap 0.4, outer 1.2, width 0.5. Pads are 2, body the same size; KiCad's IPC pads cover the maker's. Kept KiCad's per the rule above. Approved by the user |
