louisflakes/IphoneFM/design/rev-b/layout.html

# IphoneFM Rev A board sketch

The phone (outline, camera plateau, MagSafe ring), the unchanged board envelope, and a tray of the analog-FM parts at true size (bodies and recommended land patterns, top view). The Rev A placement is the agreed layout (first pitched as layout 1, revised with the user's notes); the antenna placement is kept from Plan C. Looking at the back of the phone with the camera at top left; x runs from the camera-side long edge, y down from the top edge. Dashed green lines in the tray mark where each edge part meets the board edge.

Top side Bottom side (phone side, mirrored) Grid Parts tray Rev A placement No antenna Antenna collapsed Antenna extended x —, y — mm
