louisflakes/IphoneFM/design/archive/plan-c/layout.html

# iPhone FM board sketch — Plan C

The phone (outline, camera plateau, MagSafe ring), the board envelope, and a tray of the major parts at true size (bodies and recommended land patterns, top view). Parts are not placed yet. Looking at the back of the phone with the camera at top left; x runs from the camera-side long edge, y down from the top edge.

Top side Bottom side (phone side, mirrored) Grid Layout A Layout C Envelope only No antenna Antenna collapsed Antenna extended x —, y — mm
