louisflakes/IphoneFM/design/rev-b/footprint-overlays.png

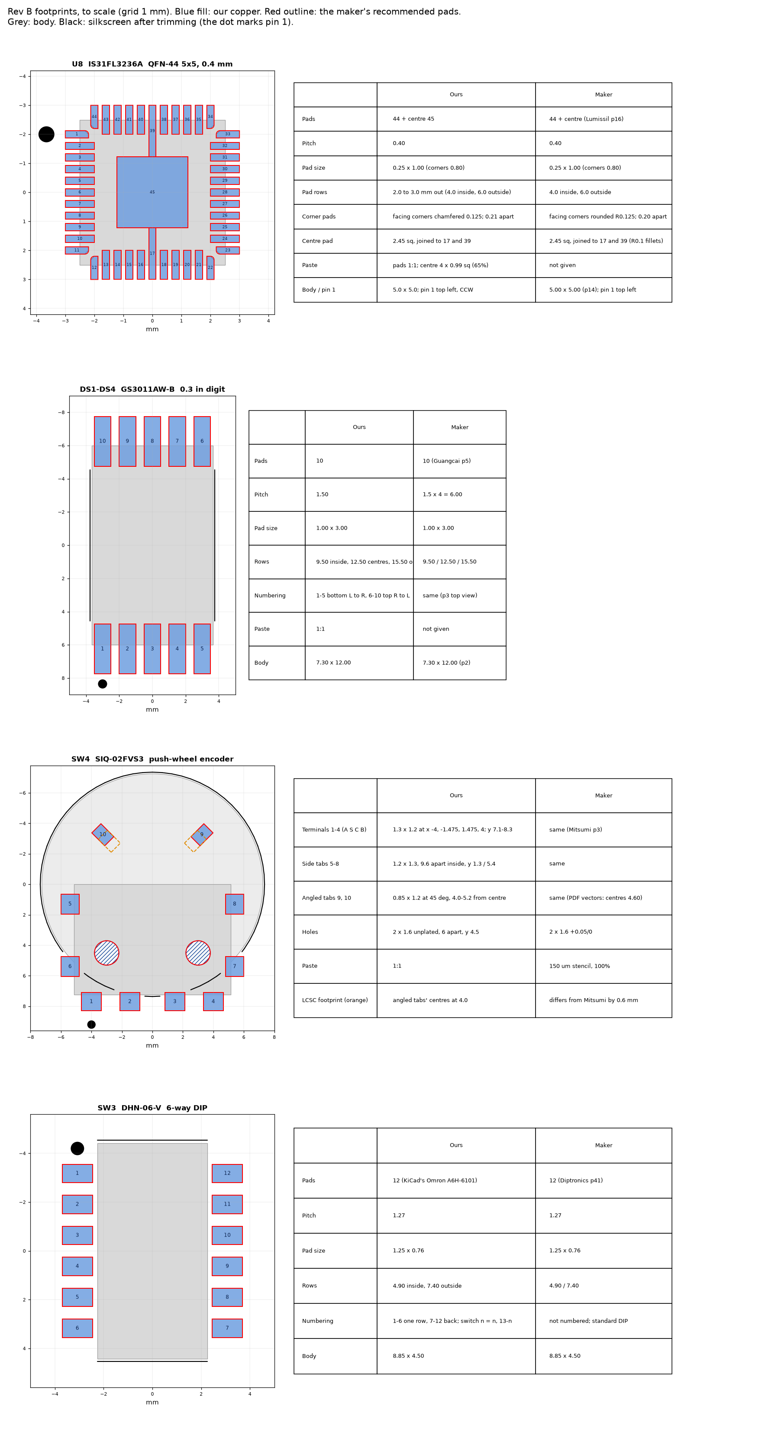
design/rev-b/footprint-overlays.png
