louisflakes/IphoneFM/design/rev-b/front-face-sketch.png

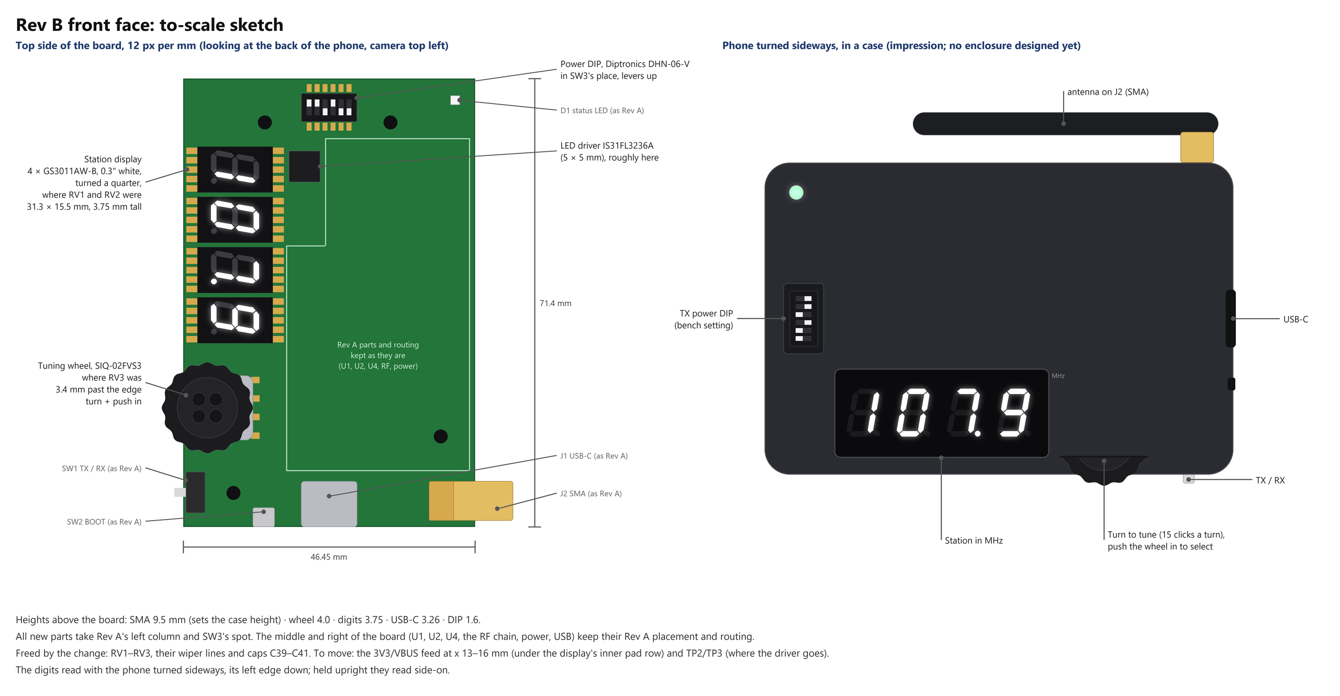
design/rev-b/front-face-sketch.png
