louisflakes/IphoneFM/design/rev-b/gerber-b8-bottom.png

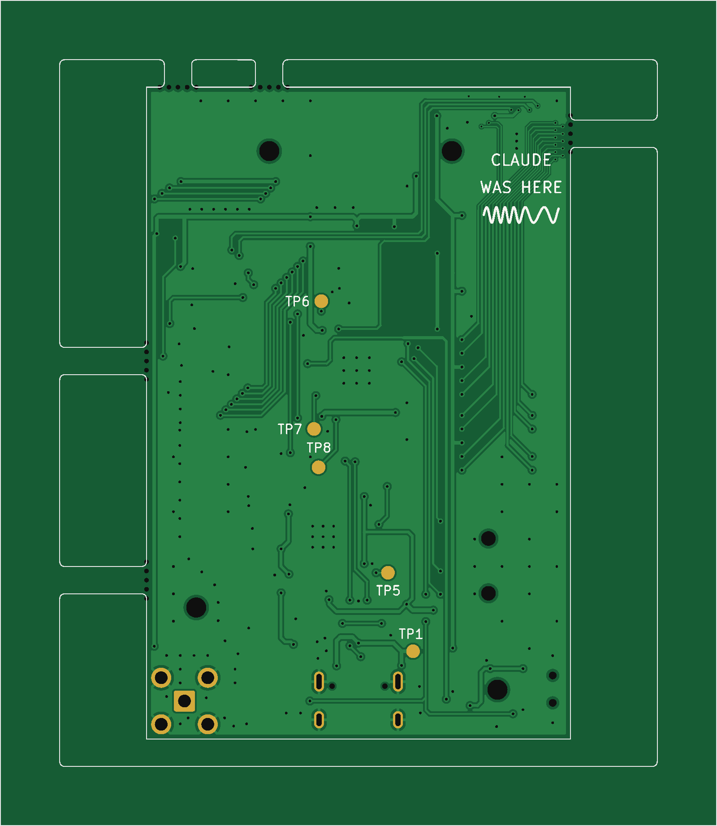
design/rev-b/gerber-b8-bottom.png
