louisflakes/IphoneFM/design/rev-b/gerber-b8-top.png

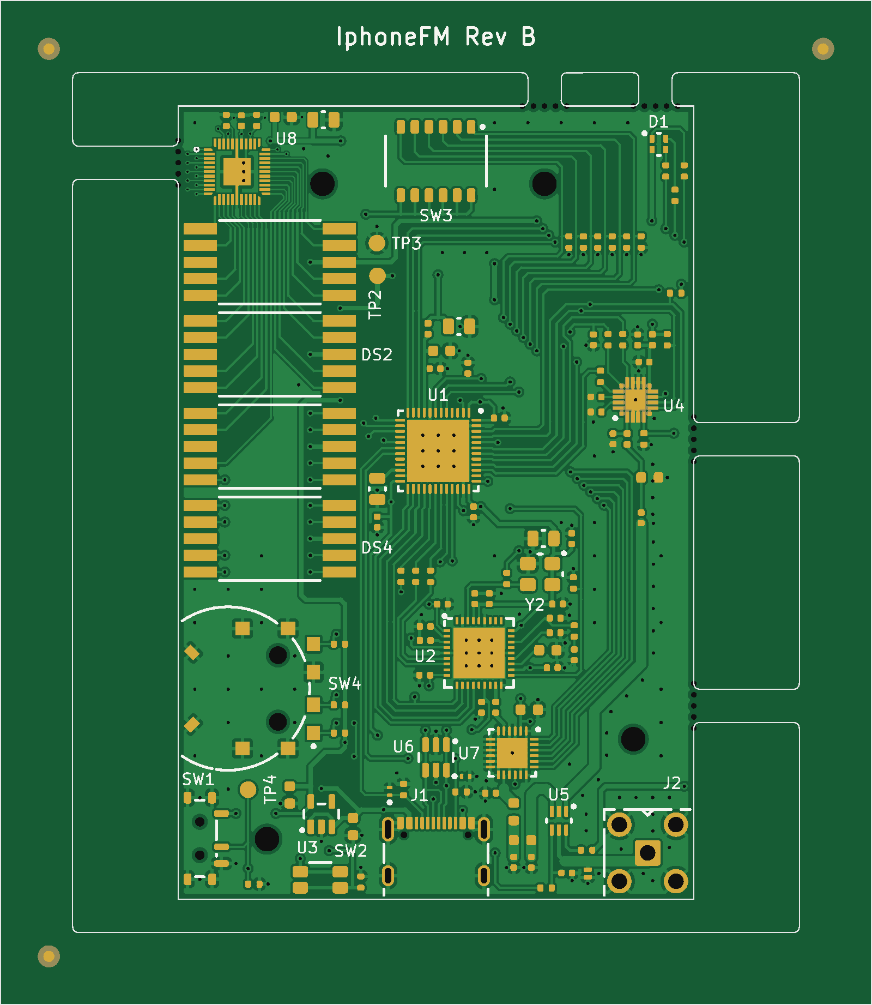
design/rev-b/gerber-b8-top.png
