louisflakes/IphoneFM/design/rev-b/placement-b4.png

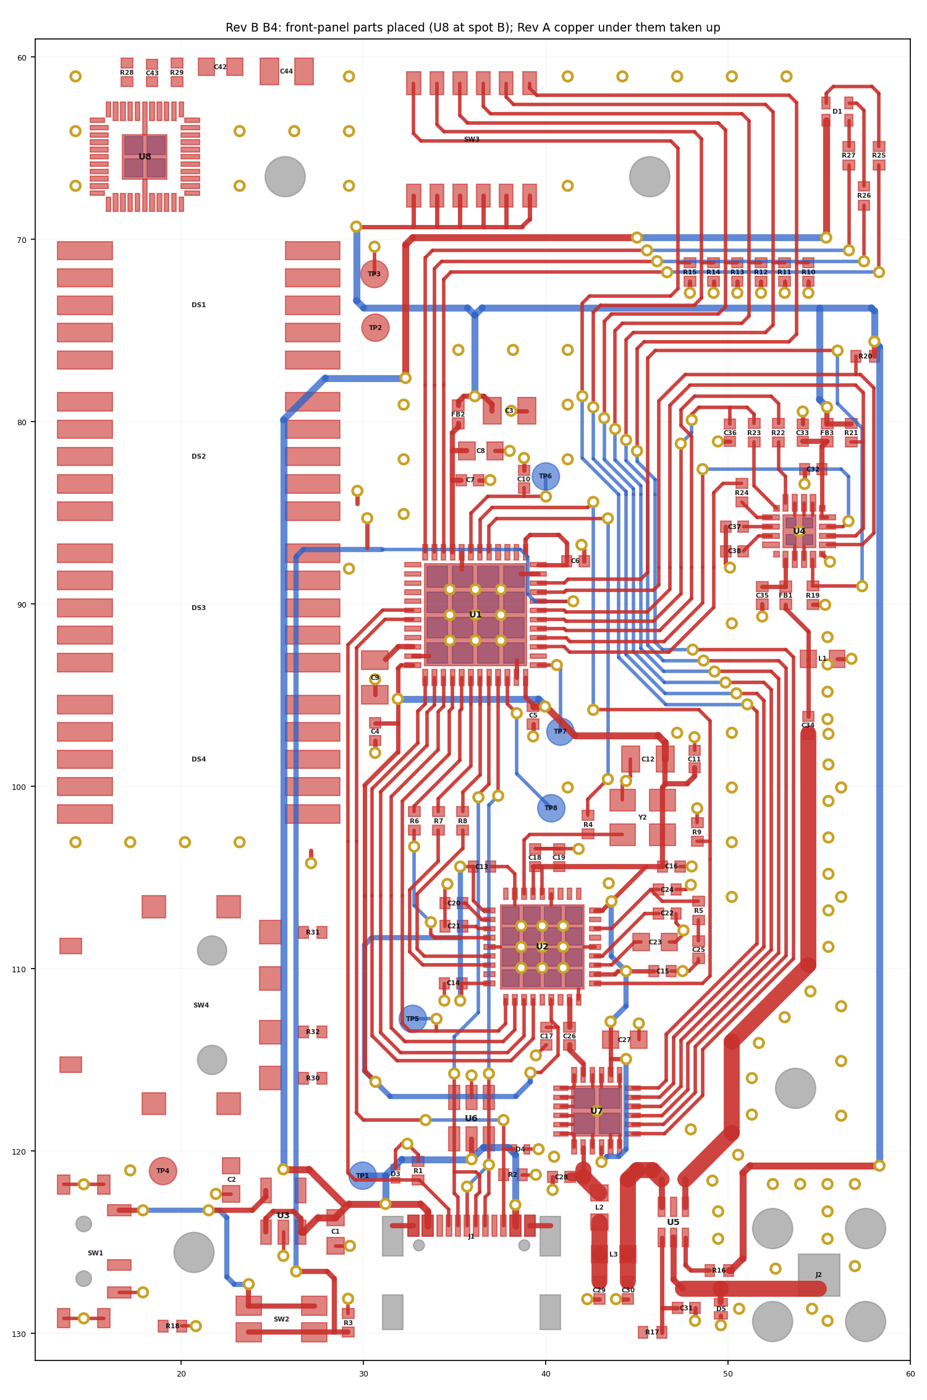
design/rev-b/placement-b4.png
