louisflakes/IphoneFM/design/rev-b/routing-b5-board.png

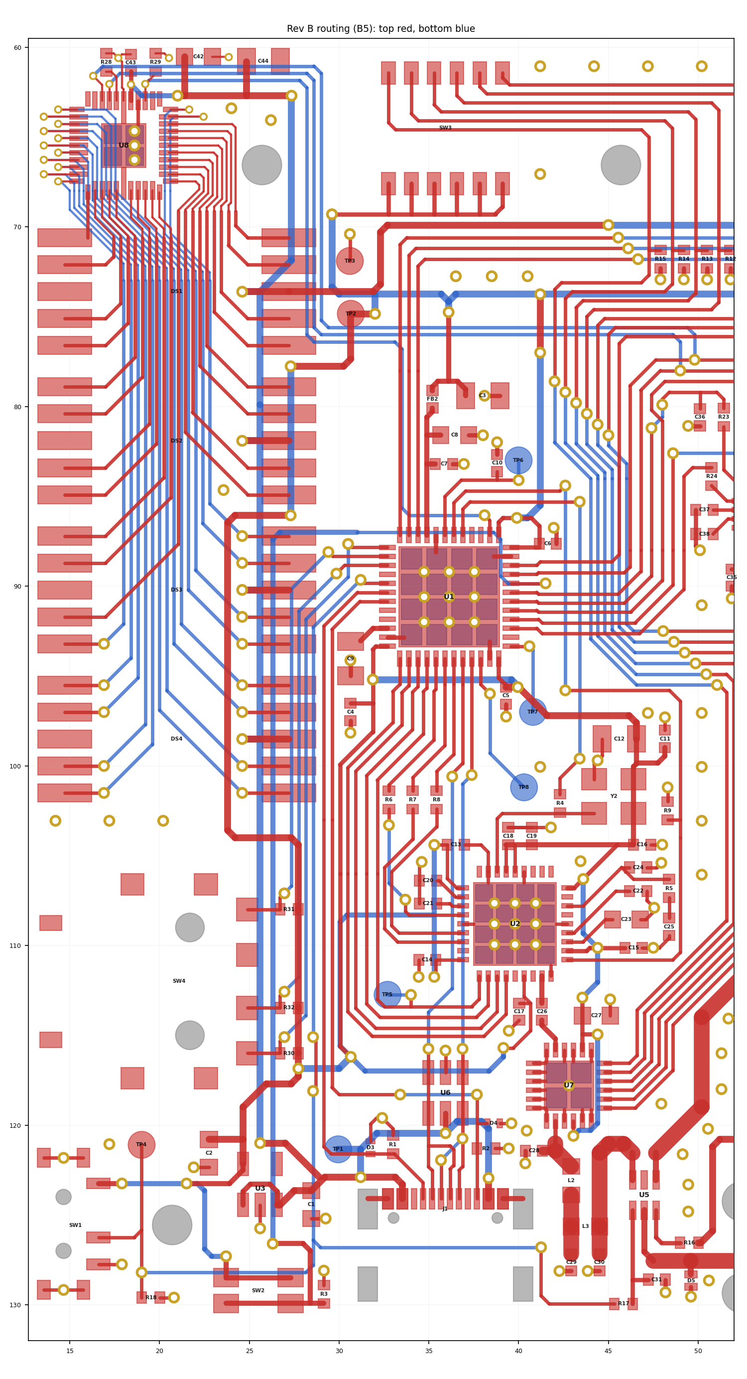
design/rev-b/routing-b5-board.png
