louisflakes/IphoneFM/design/rev-b/routing-b5-u8.png

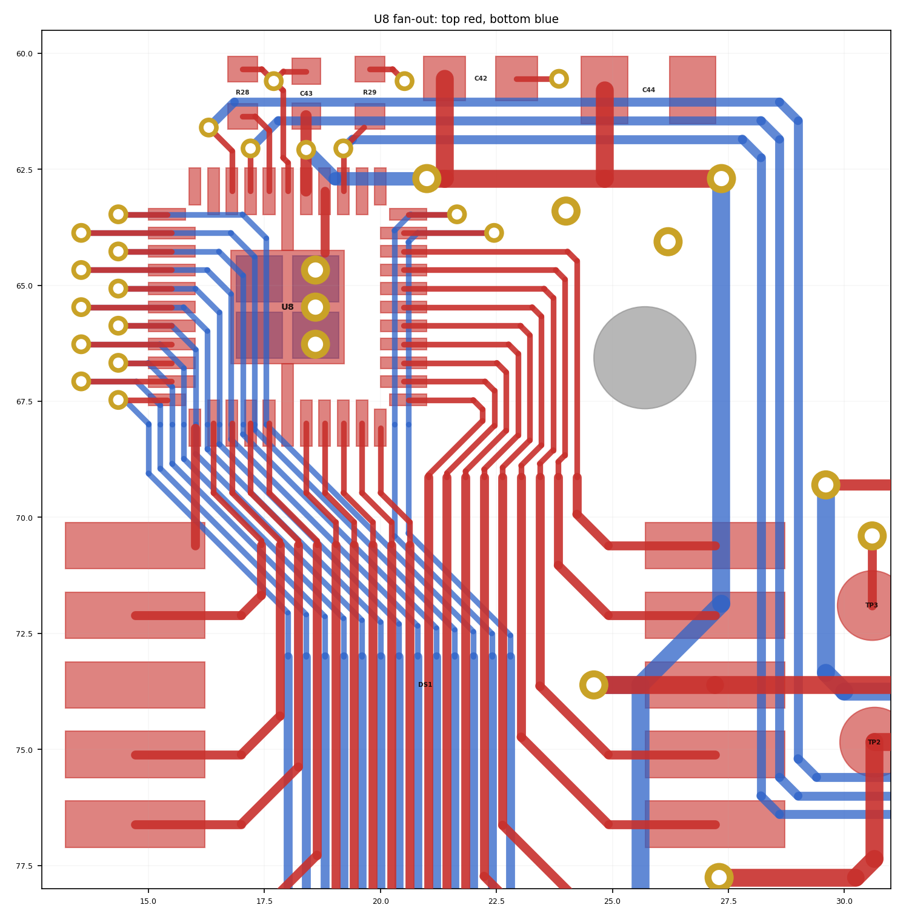
design/rev-b/routing-b5-u8.png
