louisflakes/IphoneFM/design/rev-b/routing-c-u8.png

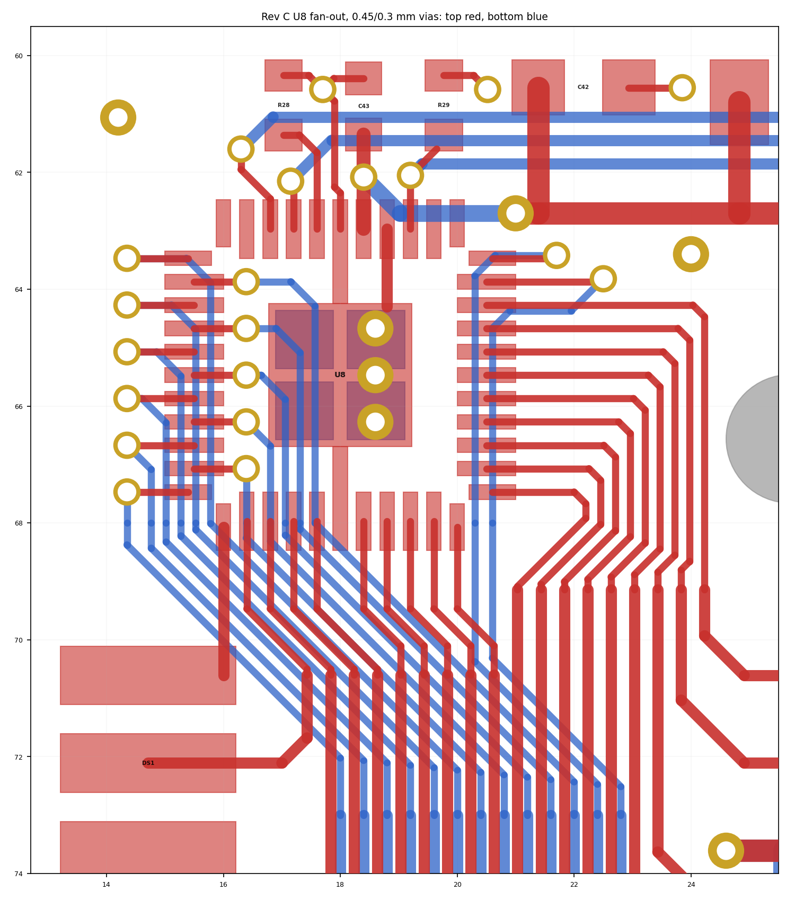
design/rev-b/routing-c-u8.png
