louisflakes/IphoneFM/design/rev-b/schematic-display.png

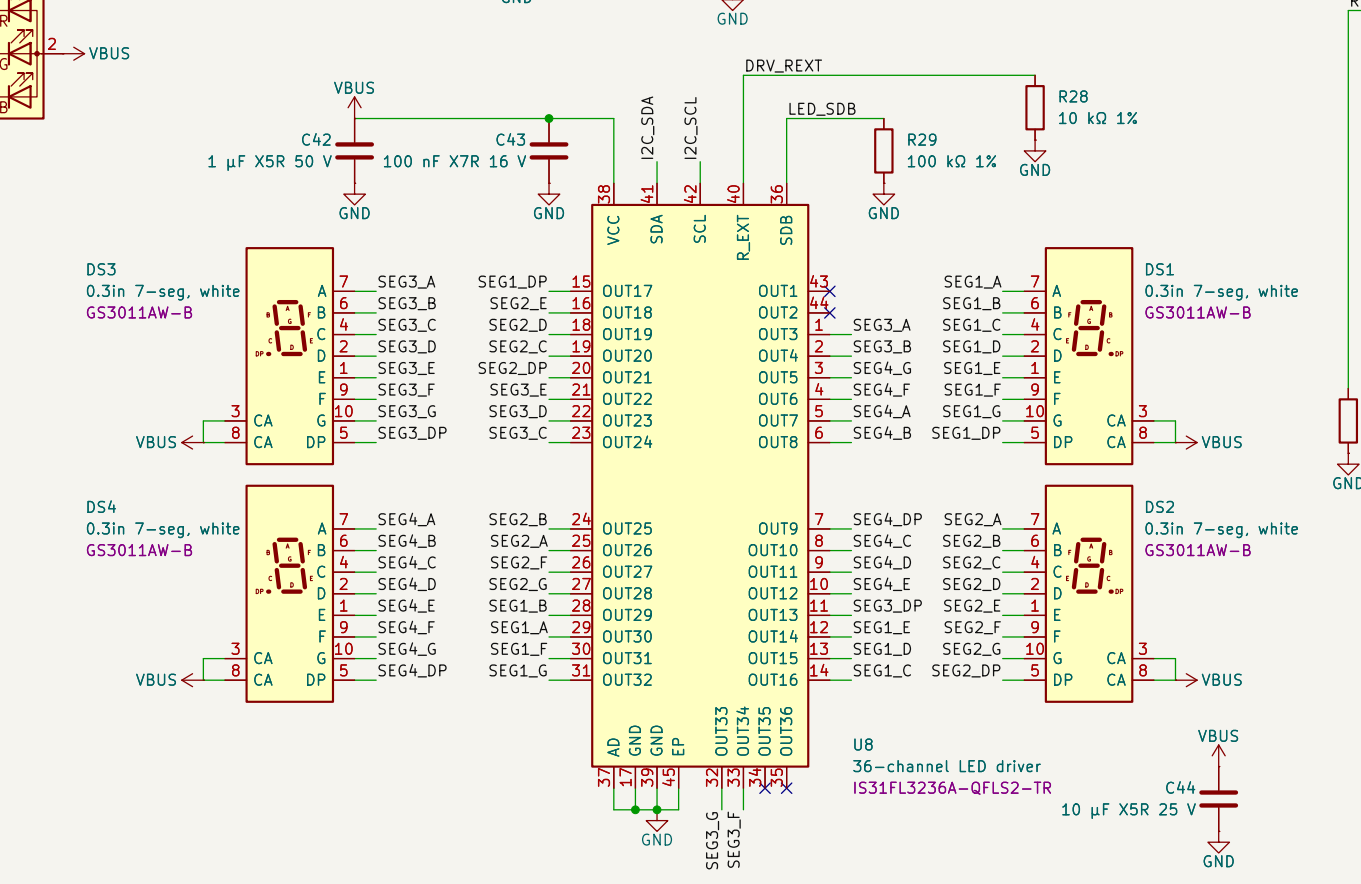
design/rev-b/schematic-display.png
