louisflakes/IphoneFM/design/rev-b/schematic-encoder.png

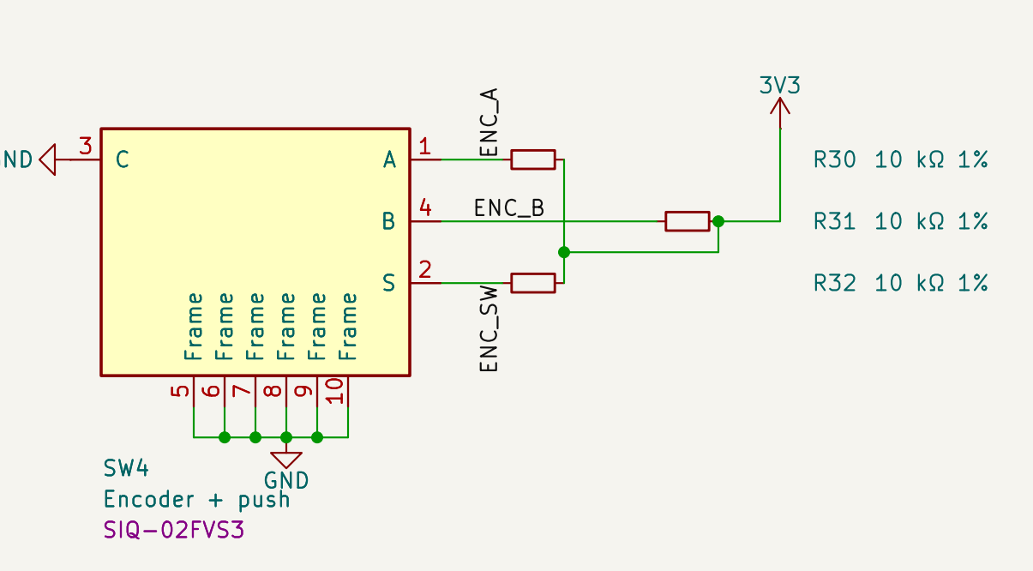
design/rev-b/schematic-encoder.png
