louisflakes/IphoneFM/design/rev-b/silk-b6-top.png

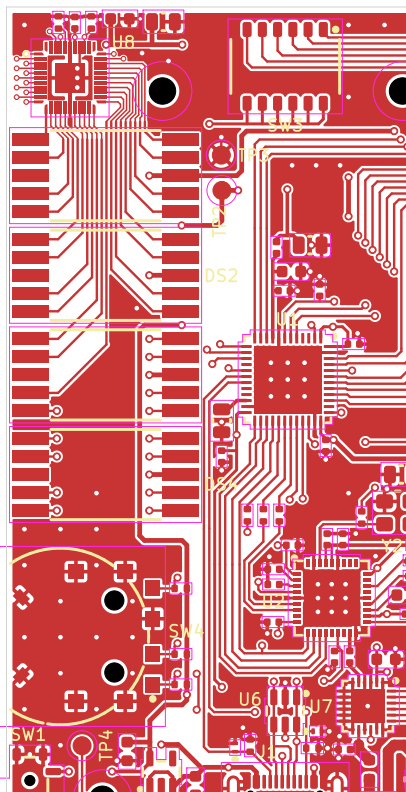
design/rev-b/silk-b6-top.png
