louisflakes/IphoneFM/review/rev-a/IphoneFM-RevA-BOM.csv

Comment | Designator | Footprint | LCSC Part # | Qty
1 uF X5R 50 V | C1,C2,C8,C27 | IphoneFM:C_0603_1608Metric | C15849 | 4
10 uF X5R 25 V | C3,C12 | IphoneFM:C_0805_2012Metric | C15850 | 2
100 nF X7R 16 V | C4,C5,C6,C7,C10,C11,C13,C14,C15,C16,C17,C18,C19,C20,C21,C22,C33,C39,C40,C41 | IphoneFM:C_0402_1005Metric | C1525 | 20
4.7 uF X5R 25 V | C9 | IphoneFM:C_0805_2012Metric | C1779 | 1
2.2 uF X5R 16 V | C23 | IphoneFM:C_0603_1608Metric | C23630 | 1
100 pF C0G | C24,C26 | IphoneFM:C_0402_1005Metric | C1546 | 2
1.5 nF C0G | C25 | IphoneFM:C_0402_1005Metric | C668348 | 1
33 pF C0G | C28,C30,C37,C38 | IphoneFM:C_0402_1005Metric | C1562 | 4
56 pF C0G | C29 | IphoneFM:C_0402_1005Metric | C107007 | 1
1 nF X7R 50 V | C31,C34 | IphoneFM:C_0402_1005Metric | C1523 | 2
22 nF X7R 50 V | C32 | IphoneFM:C_0402_1005Metric | C1532 | 1
6 pF C0G | C35 | IphoneFM:C_0402_1005Metric | C161330 | 1
3.3 pF C0G | C36 | IphoneFM:C_0402_1005Metric | C76968 | 1
RGB LED, common anode | D1 | IphoneFM:LED_RGB_XINGLIGHT_XL-1615RGBC_1.6x1.5mm | C965840 | 1
ESD 5.5 V | D3,D4 | IphoneFM:Texas_DPY0002A_0.6x1mm_P0.65mm | C436349 | 2
ESD 5 V, 0.5 pF | D5 | IphoneFM:D_SOD-882 | C117554 | 1
75 Ohm at 100 MHz | FB1 | IphoneFM:L_0402_1005Metric | C113009 | 1
600 Ohm at 100 MHz | FB2,FB3 | IphoneFM:L_0402_1005Metric | C76884 | 2
USB 2.0 Type-C | J1 | IphoneFM:USB_C_Receptacle_HRO_TYPE-C-31-M-12_2020 | C165948 | 1
SMA jack | J2 | IphoneFM:SMA_BAT_Wireless_BWSMA-KWE-Z001 | C496551 | 1
150 nH 2% | L1 | IphoneFM:L_0603_1608Metric | C113131 | 1
100 nH 2% | L2,L3 | IphoneFM:L_0603_1608Metric | C98088 | 2
5.1 kOhm 1% | R1,R2 | IphoneFM:R_0402_1005Metric | C25905 | 2
10 kOhm 1% | R3,R9,R10,R11,R12,R13,R14,R15,R19 | IphoneFM:R_0402_1005Metric | C25744 | 9
33 Ohm 1% | R4,R6,R7,R8 | IphoneFM:R_0402_1005Metric | C25105 | 4
1.1 kOhm 1% | R5 | IphoneFM:R_0402_1005Metric | C409028 | 1
1 kOhm 1% | R16,R17 | IphoneFM:R_0402_1005Metric | C11702 | 2
100 kOhm 1% | R18 | IphoneFM:R_0402_1005Metric | C25741 | 1
6.8 kOhm 1% | R20,R21 | IphoneFM:R_0402_1005Metric | C93940 | 2
604 Ohm 1% | R22 | IphoneFM:R_0402_1005Metric | C273693 | 1
2 kOhm 1% | R23,R24 | IphoneFM:R_0402_1005Metric | C4109 | 2
510 Ohm 1% | R25 | IphoneFM:R_0402_1005Metric | C25123 | 1
390 Ohm 1% | R26,R27 | IphoneFM:R_0402_1005Metric | C137997 | 2
10 kOhm 3B | RV1,RV2,RV3 | IphoneFM:Potentiometer_Alps_RK10J_Reflow_Thumbwheel_14mm | C470766 | 3
SPDT | SW1 | IphoneFM:SW_SPDT_Shouhan_MSK12C02_Tabs4 | C431540 | 1
SPST | SW2 | IphoneFM:SW_SPST_EVQP7A | C2828254 | 1
6 x SPST | SW3 | IphoneFM:SW_DIP_SPSTx06_Side_CK_TDP06H1SBD1_W7.62mm_P1.27mm | C221994 | 1
MCU | U1 | IphoneFM:QFN-48-1EP_7x7mm_P0.5mm_EP5.6x5.6mm | C22454224 | 1
Synthesizer | U2 | IphoneFM:TI_NJK0036A_WQFN-36-1EP_6x6mm_P0.5mm_EP4.6x4.6mm | C440388 | 1
3.3 V 600 mA LDO | U3 | IphoneFM:SOT-23-5 | C51118 | 1
FM receiver | U4 | IphoneFM:SiliconLabs_QFN-20-1EP_3x3mm_P0.5mm_EP1.8x1.8mm | C1526114 | 1
SPDT RF switch | U5 | IphoneFM:SOT-363_SC-70-6 | C470893 | 1
USB ESD array | U6 | IphoneFM:SOT-23-6 | C7519 | 1
Digital step attenuator | U7 | IphoneFM:QFN-24-1EP_4x4mm_P0.5mm_EP2.75x2.75mm | C470929 | 1
20 MHz CMOS XO | Y2 | IphoneFM:Oscillator_SMD_SiT_PQFN-4Pin_3.2x2.5mm | C725987 | 1
