louisflakes/IphoneFM/design/archive/plan-c/bom.md

# Plan C bill of materials

Built one chain at a time, each checked against its datasheet. Stock is DigiKey, checked 2026-10-19.
Chains not listed yet still show values only on the [wiring diagram](wiring.html).
Passive body sizes and land patterns are in [packages.md](packages.md).

## Chain 1: U1 low-speed crystal (also clocks U4 RCLK)

| Ref | Part | Value / spec | Stock | Source |
|---|---|---|---|---|
| Y1 | Abracon ABS07-32.768KHZ-7-T | 32.768 kHz, CL 7 pF, ESR ≤ 70 kΩ, C0 ≤ 2.0 pF, ±20 ppm | 398,912 | ABS07 p1 |
| C (×2) | Murata GRM1555C1H5R6CA01D | 5.6 pF ±0.25 pF C0G 0402, PC14 and PC15 to GND | 98,873 | DS14217 p188–189 |

- Load caps: C = 2 × (CL − 3 pF pin parasitics − ~1.5 pF board) ≈ 5 pF → 5.6 pF. The board figure is an estimate.
- Start-up: crystal gmcrit ≈ 4 · 70 kΩ · (2π · 32.768 kHz)² · (2.0 + 7 pF)² ≈ 0.96 µA/V. Set LSEDRV to medium-high (limit 1.7 µA/V) or higher.
- Accuracy for U4 (needs ±100 ppm): ±20 initial, −0.040 ppm/°C² from a 20–30 °C turnover, ±3 aging → about −92 ppm worst case at 60 °C.

## Chain 2: U2 LV2285VB transmitter

Values from the 88–108 MHz, 75 µs application circuit (ENA1494 p4) unless noted.

| Ref / pin | Part | Value | Stock | Note |
|---|---|---|---|---|
| U2 | LV2285VB-TLM-E-SA | FM transmitter | 2,000 | Legacy part; onsemi-branded LV2285VB-TLM-E is obsolete with 18,000 left |
| Pins 1, 24 series | TDK C1608X7R1C105K080AC | 1 µF X7R 16 V 0603 | 1,062,271 | AC coupling |
| Pins 1, 24 pre-emphasis | Yageo RC0402FR-0751KL ∥ Murata GRM1555C1H152JA01D | 51 kΩ ∥ 1.5 nF C0G | 393,412 / 80,420 | 75 µs |
| Pin 4 | KEMET T491A106K010AT | 10 µF tantalum 10 V | 518,295 | Drawn polarized on p4 |
| Pin 6 | Murata GRM155R71C104KA88J | 100 nF X7R 0402 | 7,438,959 | From the AC test circuit, p11 |
| Pin 7 | Murata GRM1555C1H221JA01D | 220 pF C0G | 736,993 | Also drives D2 anode (modulation) |
| Pin 8 loop filter | Yageo RC0402FR-07510RL + KEMET T491A156K006AT | 510 Ω + 15 µF tantalum 6.3 V to GND | 367,619 / 5,919 | |
| Pin 8 loop filter | Murata GRM155R71C104KA88J | 100 nF to GND | 7,438,959 | |
| Pin 8 → D2 | Yageo RC0402FR-0710KL | 10 kΩ | 10,493,057 | |
| #3 (pin 10) | Murata GRM1555C1H271JA01D | 270 pF C0G | 480,738 | |
| #4 | Murata GRM1555C1H820JA01D | 82 pF C0G | 142,871 | |
| #5 | Coilcraft 0805CS-101XJRC | 100 nH ±5%, SRF 1.25 GHz | 9,836 | Replaces TOKO LL2012-FHL |
| #6 (pins 11–12) | Coilcraft 0805CS-331XJRC | 330 nH ±5%, SRF 650 MHz | 8,882 | Replaces TOKO LL2012-FHL |
| Pin 11 | Murata GRM155R71C104KA88J | 100 nF | 7,438,959 | |
| Pin 12 → U5 | Murata GRM1555C1H102JA01D | 1 nF C0G DC block | 4,655,333 | U5 RF pins must be at 0 V DC |
| Pin 14 | Murata GRM155R71C104KA88J | 100 nF | 7,438,959 | |
| D2 | onsemi SVC710-TL-E | Varactor, 18.5–21.5 pF @ 1 V, 3.5–4.8 pF @ 4 V | 80,615 | Obsolete; same part as p4 |
| Y2 (pin 16) | Epson TSX-3225 16.0000MF09Z-AC0 | 16 MHz, CL 9 pF, ±10 ppm | 98,801 | Datasheet gives no CL; same family as p4 |
| Pin 16 series | Murata GRM1555C1H120JA01J | 12 pF C0G | 43,887 | |
| Pin 20 | Murata GRM188R71A225KE15D | 2.2 µF X7R 10 V 0603 | 416,961 | Auto-sleep ≈ 70 s (45–300 s, p2) |
| Pin 22 drive | Yageo RC0402FR-072K2L, RC0402FR-071KL, Murata GRM155R71H103KA88D | 2.2 kΩ series, 1 kΩ to GND, 10 nF series | 123,395 / 3,538,473 / 4,003,430 | From U1 PB8 TIM16, replaces the obsolete 76 kHz crystal |
| Pins 2, 21, 23 | — | Not connected | | 2/23 unused in I²C mode (p7); 21 is the oscillator output |

## Chain 3: U4 Si4704 receiver

Values from the SSOP application schematic and BOM (Si4704/05-D60 Rev 1.2 p17–18) unless noted.

| Ref / pin | Part | Value | Stock | Note |
|---|---|---|---|---|
| U4 | Skyworks SI4704-D60-GUR | FM receiver, SSOP-24 | 2,500 | |
| C1 (pin 22 ↔ 21) | Murata GRM155R71H223KA12D | 22 nF X7R 0402 | 244,384 | Between DBYP and VA, close to VA (not to GND) |
| C4 (pin 20) | Murata GRM155R71C104KA88J | 100 nF X7R 0402 | 7,438,959 | VD to GND |
| C2 (pin 8) | Murata GRM1555C1H102JA01D | 1 nF C0G | 4,655,333 | FMI coupling; also keeps U5 RF1 free of DC (PE42421 p8) |
| L1 (C2–FB1 node to GND) | Coilcraft 0805CS-151XJRC | 150 nH ±5%, 0805 (Doc100 p1) | 29,684 | FMI matching inductor (AN383 p37 Figure 23; Appendix A p50–53): resonates the total FMI capacitance (antenna, trace, C14, LNA 4–6 pF) at mid-band. Best guess, centred for the ANT500 collapsed (its usual state): about 15–21 pF total (antenna ≈ 3–4 pF by the short-monopole estimate, C14 6, LNA 4–6, trace ≈ 2.5, ESD and switch ≈ 1) resonates at 98 MHz with 124–170 nH. The bench RSSI sweep (AN383 p52–53) may move it; 0805CS-121 and -181 are stocked. The Si4704's auto-tuning varactor is only on LPI (AN383 p34–35), so FMI needs this fixed L. No DC reaches it (C2 blocks); FMI sits at 0 V DC through FB1 and L1, as in AN383's circuit |
| FB1 (C2 → FMI) | Murata BLM15GA750SN1D | Ferrite bead, 75 Ω ±25% at 100 MHz, 200 mA, ≤ 1.3 Ω DC, 0402 | 340,990 | VCO emissions filter (AN383 p7, p9). No DC through it (C2 blocks). BLM15G spec p1 (ratings), p2 (body 1.0 × 0.5 × 0.5), p6 (land a 0.4, b 1.2, c 0.5) |
| C14 (pin 8 to GND) | Murata GJM1555C1H6R0CB01D | 6 pF ±0.25 pF C0G 0402 | 91,801 | VCO emissions filter (AN383 p7). GRM1555C1H6R0 is "Not For New Designs"; GJM is active, same 1.0 × 0.5 × 0.5 body |
| C15 (pin 5 GPO1), C18 (pin 4 GPO2) | Murata GRM1555C1H330JA01D | 33 pF C0G 0402 to GND | 882,503 | VCO emissions filter at the GPO pins (AN383 p8, Table 4 option 1). R19/R20 not needed: the pins have no other connection |
| R1 (pin 1 DOUT) | Yageo RC0402FR-07604RL | 604 Ω 1% | 58,904 | Datasheet 600 Ω, not a standard value |
| R2 (pin 2 DFS) | Panasonic ERJ-2RKF2001X | 2 kΩ 1% | 3,482,510 | |
| R3 (pin 3 DCLK) | Panasonic ERJ-2RKF2001X | 2 kΩ 1% | 3,482,510 | DCLK ≥ 26 ns period (p10); ours ≈ 325 ns |
| C9 (DFS, U1 side of R2) | Murata GRM1555C1H3R3CA01D | 3.3 pF C0G | 279,629 | Datasheet 2–5 pF, noise mitigation |
| RX_RST pull-down | Yageo RC0402FR-0710KL | 10 kΩ | 10,493,057 | Holds U4 in reset until firmware runs |
| I²C pull-ups (×2) | Yageo RC0402FR-076K8L | 6.8 kΩ | 228,152 | Was 3.3 kΩ. U4 VOL is specified at ≤ 500 µA (p5); 6.8 kΩ = 0.49 mA. Rise ≈ 288 ns at 50 pF, inside U4's 300 ns (p7) and U2's 1000 ns (ENA1494 p9) |
| Pins 9, 10, 11 (LPI), 12 | — | GND | | p17, p27; LPI unused, so routed to GND/RFGND (AN383 p8, p17) |
| Pins 4 (GPO2), 5 (GPO1) | — | Floating except C18/C15 | | On-chip pulls select 2-wire mode at RST rise (p24, Table 13). Firmware holds RST low ≥ 1 ms: 100 µs minimum when floating (p6 note 4), and 33 pF on 1 MΩ gives τ ≈ 33 µs |
| Pins 6, 7, 23, 24 | — | Not connected | | 6/7 per p27; analog outputs unused |

- TX leakage with L1 (estimate): U5 isolates RF2 to RF1 by about 85 dB typ at 100 MHz (PE42421 p3). Up to about 1.4 Vpk at RF2 (≈ 120 dBµV) gives about 80 µV at RF1; even with a 10× resonant voltage gain at FMI that is under 1 mV against the 0.4 Vpk limit. The datasheet gives no isolation minimum at 100 MHz, so check FMI in TX mode on the bench.
- FMI filter loss (estimate): FB1 and C14 cost about 2 dB of signal at FMI from a 50 Ω antenna. Populated as listed.
- AN383's option 1 leaves its C5 pad empty (p7); this board has no C5 pad, since every passive is populated (user, 2026-10-20).

## Chain 4: U1 STM32U535 support parts

From DS14217 Rev 5: Figure 23 power scheme (p127), Figure 37 NRST (p212), I/O characteristics (p203).

| Ref / pin | Part | Value | Stock | Note |
|---|---|---|---|---|
| U1 | ST STM32U535CEU6 | MCU, UFQFPN48 | 1,394 | |
| VDD 24, 36, 48 (×3) | Murata GRM155R71C104KA88J | 100 nF X7R 0402 | 7,438,959 | One per pin |
| VDD bulk | Yageo CC0805KRX5R7BB106 | 10 µF X5R 16 V 0805 | 512,367 | One for all VDD pins |
| VDDA 9 | Murata GRM155R71C104KA88J + TDK C1608X7R1C105K080AC | 100 nF + 1 µF X7R | 7,438,959 / 1,062,271 | VREF+ bonded to VDDA on this package |
| VCAP 22 | Murata GRM21BR71C475KE51L | 4.7 µF ±10% X7R 16 V 0805 | 166,059 | Meets ≥ 10 V and ±20% (p127; Murata product sheet). ESR < 20 mΩ at 3 MHz accepted for an X7R MLCC without the curve: the limit rules out tantalum/electrolytic |
| NRST 7 | Murata GRM155R71C104KA88J | 100 nF | 7,438,959 | Close to the pin; internal 40 kΩ pull-up (p211) |
| BOOT0 44 pull-down | Yageo RC0402FR-0710KL | 10 kΩ | 10,493,057 | No internal pull-down at reset; ≤ 500 nA leakage → ~5 mV (p203) |
| VBAT 1 | — | Tied to 3V3 | | Figure 23 shows no VBAT cap; UM3062 p24 ties VBAT to VDD |
| SWD pads | — | SWCLK, SWDIO, NRST, 3V3, GND | | Backup programming only |
| PC13 (tune down) | — | Internal pull-down, 30–50 kΩ | | p203 |

## Chain 5: U3 AP2112K-3.3 regulator

From AP2112 DS39724 Rev 2-2: typical application circuit and pin table (p2), features (p1), 3.3 V electrical characteristics.

| Ref / pin | Part | Value | Stock | Note |
|---|---|---|---|---|
| U3 | Diodes AP2112K-3.3TRG1 | 3.3 V 600 mA LDO, SOT-25 | 428,301 | VIN 1, GND 2, EN 3, NC 4, VOUT 5 |
| CIN (VIN 1) | TDK C1608X7R1C105K080AC | 1 µF X7R 16 V 0603 | 1,062,271 | p2; X7R/X5R recommended (Note 4). Only capacitance on VBUS |
| COUT (VOUT 5) | TDK C1608X7R1C105K080AC | 1 µF X7R 16 V 0603 | 1,062,271 | p2; stable with ≥ 1 µF, no maximum given (p1) |
| EN 3 | — | Tied to VIN | | Internal 3 MΩ pull-down (p2 block diagram) |

- 3V3 rail total ≈ 12.6 µF (COUT + U1 11.4 µF + U2/U4 bypass).
- Start-up: foldback short-circuit limit 50 mA at VOUT = 0 V (p1, p4) charges 12.6 µF to 3.3 V in ≈ 0.9 ms. All loads are in reset or standby then (U2 standby 40–60 µA, ENA1494 p2; U4 held in reset).
- Apple ADG has no VBUS capacitance or inrush rule; the bus sees only CIN.

## Chain 6: J1 USB-C receptacle

From the GCT USB4105 drawing (pin table) and USB Type-C R2.5 (March 2026).

| Ref / pin | Part | Value | Stock | Note |
|---|---|---|---|---|
| J1 | GCT USB4105-GF-A | USB 2.0 Type-C receptacle | 96,715 | VBUS pins 5 A total; 0.25 A per signal pin |
| Rd on CC1 (A5) | Yageo RC0402FR-075K1L | 5.1 kΩ 1% to GND | 711,656 | Spec: 5.1 kΩ ±10% total incl. pin (Table 4-28 p246, Note 2) |
| Rd on CC2 (B5) | Yageo RC0402FR-075K1L | 5.1 kΩ 1% to GND | 711,656 | Fitted (standard practice) |
| A6–B6, A7–B7 | — | Shorted, stub ≤ 3.5 mm | | p76 |
| A8, B8 (SBU) | — | Not connected | | No USB4/Alt Mode → open (p150) |
| Shell | — | GND | | GCT pin table |

- **Phone cable:** a very short, flexible standard USB-C cable (chosen 2026-10-20 in place of the Adafruit 6367 bridge, for slack in the fit). A standard USB 2.0 C-to-C cable carries one CC wire, A5↔A5; B5 is VCONN for e-marked cables only and is not wired through (Table 3-11, p84). So the source sees exactly one Rd, which it needs to attach (p186). Only a straight-through adapter wiring B5↔B5 would need CC2's Rd removed.
- **CC sensing (firmware):** ADC1 8-bit with ≥ 546 ns sampling suits a ~5 kΩ source (DS14217 Table 104, p215). Bands: default 0.277–0.612 V, 1.5 A 0.746–1.164 V, 3.0 A 1.369–2.042 V; thresholds 0.613/0.745 V and 1.165/1.368 V (Table 4-36, p255).

## Chain 7: U5 PE42421 RF switch and mode line

From the PE42421 datasheet (DOC-33214-1.03): recommended operating conditions (p2), truth table (p4), evaluation board schematic (p7, Figure 12), pin descriptions (p8).

| Ref / pin | Part | Value | Stock | Note |
|---|---|---|---|---|
| U5 | pSemi PE42421SCAA-Z | SPDT RF switch, SC-70-6 | 134,343 | |
| VDD 6 series | Yageo RC0402FR-071KL | 1 kΩ from 3V3 | 3,538,297 | As on the eval board; no bypass cap there. IDD 9–20 µA → 9–20 mV drop |
| CTRL 4 series | Yageo RC0402FR-071KL | 1 kΩ from the RF_MODE node | 3,538,297 | As on the eval board |
| RF_MODE pull-down | Yageo RC0402FR-07100KL | 100 kΩ to GND | 6,066,869 | Holds RX (CTRL low) while the slider is between contacts |
| RFC 5 | — | Direct to J2 centre pin | | Must be 0 V DC (p8); a passive antenna is |
| RF1 1, RF2 3 | — | Through the 1 nF caps already listed (chains 2 and 3) | | DC blocks |
| GND 2 | — | Short trace to the ground plane | | p8 |

- Supply: our 3V3 is 3.3 V ±1.5% (AP2112 p1), so VDD at the pin is 3.23–3.34 V. That can be up to 40 mV over the 3.3 V recommended maximum, but far below the 4.0 V absolute maximum (p2). Accepted.
- CTRL levels: high ≥ 0.7 × VDD, low ≤ 0.3 × VDD (p2). The slider gives 3.3 V or 0 V; U1 PB0 leakage ≤ 500 nA adds ≤ 50 mV across 100 kΩ (DS14217 p202).
- J2: TE Linx CONSMA002-G, SMA jack (female socket), right angle, through hole, 50 Ω, gold, 12.4 GHz ($5.34, 641 in stock). Replaces the RP-SMA CONREVSMA002-G (2026-10-20) so the antenna fits without an adapter. Its drawing (C-CONSMA002-G rev A) gives the same footprint and body as the CONREVSMA002-G: 4 × Ø1.5 legs on a 5.1 square, Ø1.4 centre, 7.0 square base, 15.20 long, 13.90 tall incl. 3.90 legs. Max torque 0.57 N·m (5 in·lb), −40 to +85 °C.
- Antenna (off board, prototype): Great Scott Gadgets ANT500 (Adafruit 3584, $34.95), SMA male, 75 MHz–1 GHz, 20–88 cm, rotating shaft and elbow. Screws straight onto J2.
- Not on this board: the eval board's 0.25 pF shunt on RFC. It tunes 1–2 GHz loss (p3 note 2); at 100 MHz it is ≈ 6.4 kΩ and does nothing.

## Chain 8: SW1 TX/RX slider

From the Same Sky SLW-158562-5A-RA-N-D datasheet (09/12/2024): specifications (p1), drawing and schematic (p2).

| Ref / pin | Part | Value | Stock | Note |
|---|---|---|---|---|
| SW1 | Same Sky SLW-158562-5A-RA-N-D | DPDT, non-shorting, right angle | 3,009 | Pins unnumbered on the drawing; middle row = COM |
| Pole A COM | — | RF_MODE node | | 100 kΩ pull-down + 1 kΩ to U5 CTRL + U1 PB0 (chain 7) |
| Pole A throws | — | 3V3 (TX), GND (RX) | | Which slide direction is TX: check on a real part |
| Pole B | — | Not connected | | Spare |
| Frame tabs (×2) | — | GND | | ESD path for the exposed steel frame (engineering choice) |

- Electrical: 33 µA at 3.3 V vs a 300 mA / 50 V DC rating; contact resistance ≤ 100 mΩ, specified at ≤ 100 mA (p1).
- Non-shorting (p2), so 3V3 and GND never connect during travel.
- Operating −20 to 70 °C, the narrowest range on the board. Life 10,000 cycles.
- Mechanical: the drawing assumes a 1.6 mm PCB (p2); actuator centre 3.7 mm above the board, 5 mm past the edge, 4 mm travel.

## Chain 9: SW2, SW3 buttons

Side-push (right-angle) SMD buttons, chosen 2026-10-20 so SW1, SW2 and SW3 can all exit the same board edge. From the Panasonic catalog ANCTB21E (2025-07): specifications (p1), EVQP7J dimensions, circuit and land pattern (p2).

| Ref / pin | Part | Value | Stock | Note |
|---|---|---|---|---|
| SW2 (tune up / bootloader) | Panasonic EVQ-P7J01P | Side-operated tactile, 1.6 N (163 gf), 3.5 × 2.9 × 1.35 mm, SMD | 67,315 | Pins 1·1′ to 3V3, pins 2·2′ to U1 PH3-BOOT0 (10 kΩ pull-down, chain 4) |
| SW3 (tune down) | Panasonic EVQ-P7J01P | Same | 67,315 | Pins 1·1′ to 3V3, pins 2·2′ to U1 PC13 (internal pull-down) |

- Rated 10 µA at 2 V DC to 50 mA at 12 V DC, resistive (p1). SW2 carries 0.33 mA at 3.3 V; SW3 66–110 µA (PC13 pull-down 30–50 kΩ, DS14217 p203). Both inside the rating, including its 10 µA minimum.
- Circuit (p2): 1–1′ and 2–2′ are joined pairs; the switch closes 1 to 2.
- Land pattern (p2): 4 pads 1.4 × 1.05 mm, 5.0 outer by 2.5 overall, 2.2 and 0.4 gaps. The knob is 1.7 mm wide and stands 0.65 mm proud of the body.
- Push strength 30 N for 1 minute, 100,000-cycle life, operating −20 to +70 °C, the same range as SW1 (p1).
- Replaces the Same Sky TS02-66-110-BK-160-LCR-D (top-actuated, through hole). Its leads would have met the MagSafe ring (placement rule M7).

## Chain 10: D1 RGB LED

From the Broadcom ASCB-WTF0 datasheet (ASCB-WTF0-DS101): pinout (p2), ratings (p3), derating (p7, Figure 10).

| Ref / pin | Part | Value | Stock | Note |
|---|---|---|---|---|
| D1 | Broadcom ASCB-WTF0-0A30A | RGB, PLCC-6, independent chips | 25,847 | Anodes 1/3/5 to VBUS; cathodes 2/4/6 via resistors to U1 |
| Red series | Yageo RC0402FR-07510RL | 510 Ω | 367,569 | To PB4; ≤ 7.0 mA, ≤ 25 mW in the resistor |
| Green series | Panasonic ERJ-2RKF3900X | 390 Ω, 0.1 W | 191,245 | To PB5; ≤ 7.3 mA, ≤ 21 mW |
| Blue series | Panasonic ERJ-2RKF3900X | 390 Ω, 0.1 W | 191,245 | To PB1; ≤ 7.3 mA, ≤ 21 mW |

- Currents ≤ 7.3 mA vs abs max 25/25/20 mA (R/G/B, p3). With all three on, Figure 10 derates to ≈ 17/13/11 mA at 70 °C ambient, the board's upper limit (SW1). Above that, blue would need less current.
- LED power ≤ 23 mW per chip vs 60/80/64 mW abs max (p3).
- U1 pins must be open-drain with pulls off. A pin driving high could reverse-bias the LED as VBUS collapses at unplug; the datasheet does not allow reverse bias (p3).
- U1 side: ≤ 7.3 mA per pin keeps VOL ≤ 0.4 V (spec'd to 8 mA, DS14217 p205); all pins are 5 V tolerant (FT); total sink ≪ 120 mA (p130).

## Chain 11: ESD protection

| Ref | Part | Protects | Stock | Checked against |
|---|---|---|---|---|
| U6 | ST USBLC6-2SC6 (SOT-23-6) | D+ (I/O1, pins 1/6), D− (I/O2, pins 3/4), VBUS (pin 5); GND pin 2 | 100,644 | ST datasheet (REV 2 mirror) p1–2: 2.5–3.5 pF per line, fine for 12 Mbit/s full-speed USB. VBUS: 5 V stand-off, ≥ 6 V breakdown; VBUS is ≤ 5.5 V so it never conducts (leakage may exceed the 1 µA spec near 5.5 V, harmless). IEC 61000-4-2 level 4 |
| D3, D4 | TI TPD1E05U06DPYR | CC1, CC2 at J1 | 588,786 | TI datasheet: unidirectional (CC is never negative), 5.5 V stand-off vs ≤ 2.04 V on CC, 0.42–0.5 pF, ≤ 10 nA leakage (adds µV across Rd, so the ±10% Rd budget is untouched), ±12 kV contact |
| D5 | TI TPD1E0B04DPLR (0201) | ANT, at J2 | 172,096 | TI datasheet: bidirectional (RF swings both ways; a one-way diode would clip it), ±3.6 V stand-off vs ≤ 1.5 V peak TX (LV2285 max ≈ 120 dBµV), 0.13–0.15 pF (≈ 10 kΩ at 100 MHz), ≤ 10 nA, ±8 kV contact. U5 behind it is only 2 kV HBM (PE42421 p2) |

## Chain 12: FL1 transmit low-pass filter

Between the 1 nF DC block after U2 pin 12 and U5 RF2. 5th-order Chebyshev, 0.1 dB ripple, 115 MHz cutoff, designed for 50 Ω.

| Position | Part | Value | Stock |
|---|---|---|---|
| C (shunt, input) | Murata GRM1555C1H330JA01D | 33 pF C0G | 879,573 |
| L (series) | Coilcraft 0805CS-101XJRC | 100 nH, SRF 1.25 GHz | 9,836 |
| C (shunt, middle) | Murata GRM1555C1H560JA01D | 56 pF C0G | 755,897 |
| L (series) | Coilcraft 0805CS-101XJRC | 100 nH | 9,836 |
| C (shunt, output) | Murata GRM1555C1H330JA01D | 33 pF C0G | 879,573 |

- Computed with these standard values: ≤ 0.1 dB loss at 88–108 MHz with ideal parts, ≈ 0.7 dB assuming inductor Q = 40 (Coilcraft specifies Q only at 500 MHz); 23–34 dB down at 176–216 MHz (2nd harmonic); ≥ 43 dB from 264 MHz.
- Why: FCC §15.239(c) requires emissions outside the 200 kHz channel to meet §15.209, and the LV2285 datasheet gives no harmonic spec.
- Both sides: DC is already blocked upstream, and U5 RF2 must be at 0 V DC (PE42421 p8), so the shunt caps see no DC. Power ≤ ~23 mW → ~21 mA rms in the inductors vs 400 mA rating.
- The LV2285 output is not 50 Ω, so the real response will shift. Populated as listed; the bench may tune the values.

## Chain 13: Test pads

Planned before layout (HHG p48; [PCB design workflow](../../../docs/pcb-design-workflow.md) §4). None on RF nets.

| Ref | Net | Use |
|---|---|---|
| TP1 | VBUS | Supply from the phone |
| TP2 | 3V3 | Regulator output |
| TP3 | GND | Probe ground |
| TP4 | OSC76, at U2 pin 22 | Check that the LV2285 runs from U1's 76 kHz drive |
| TP5 | RF_MODE | Check which slide direction is TX |
