louisflakes/IphoneFM/design/rev-b/build-procedure.md

# Rev B build procedure

Rev B changes only the front panel ([front-panel.md](front-panel.md), [front-face-sketch.png](front-face-sketch.png)):
the three tuning wheels become one push-wheel encoder, a four-digit station display and its driver are added, and the
side-lever DIP becomes a top-lever one. Everything else is Rev A as built and reviewed (tag `rev-a-reviewed`).

The order and the rules are Rev A's ([../rev-a/kicad-build-procedure.md](../rev-a/kicad-build-procedure.md)): a design
change goes into netlist.json first, then the pages that explain it, then the schematic, then footprints, placement and
routing. Each new symbol and footprint is checked against its datasheet as in Rev A. Only the steps Rev B touches are
listed; the rest of Rev A carries over unchanged.

Work is done in batches from a rollback point (a commit before each batch), with a report and a picture at the end of
each batch; a choice that is the user's stops the batch at once.

## Phase B0: Set up

- [x] B0.1 Copy the Rev A design files and KiCad project to `design/rev-b/` and `kicad/rev-b/`, so Rev A stays as
  ordered. Title blocks to Rev B.
  - Done 2026-11-06 (tag `rev-b-b0`): design files and the KiCad sources (no outputs or panel) copied; title blocks Rev B, 2026-11-06. `tools/netcheck.py` and `tools/kicadcheck.py` take `IPHONEFM_REV=rev-b`; Rev A still passes all 19 netcheck checks.

## Phase B1: Design changes (netlist.json and the pages, before KiCad)

- [x] B1.1 Remove RV1–RV3, their reservoir caps C39–C41 and the nets WHEEL1–WHEEL3; free U1 pins 13–15.
  - Done 2026-11-06: RV1–RV3, C39–C41 and WHEEL1–3 removed; U1 pins 13–15 now carry the encoder.
- [x] B1.2 SW3 becomes Diptronics DHN-06-V (C224997); check its pin numbering against p1. Same nets as Rev A.
  - Done 2026-11-06: same pin map as Rev A (switch n between pins n and 13−n); the numbering is confirmed on the footprint in Phase B3.
- [x] B1.3 Add the encoder (Mitsumi SIQ-02FVS3, C2925423): A, B and the push switch to U1 pins, common to GND, with
  pull-ups. Check the chosen U1 pins against DS14217 (a timer's encoder inputs if one is free) and AN2606 (bootloader).
  - Done 2026-11-06: SW4 A → PA3, B → PA4, S → PA5, C and 6 frame tabs → GND, R30–R32 10 kΩ pull-ups (0.33 mA, under the contacts' 0.5 mA). No timer has both encoder inputs on free pins, so firmware decodes it (EXTI3–5). PA4/PA5 are the bootloader's SPI1 NSS/SCK inputs; both contacts are open at every detent, so they idle high (SIQ p3, AN2606 p387).
- [x] B1.4 Add the display: 4 × GS3011AW-B (C22462661), anodes 3 and 8 to VBUS, 32 segments to the driver.
  - Done 2026-11-06: DS1–DS4 pins from GS3011A/CX-X p3; nets SEG1_A … SEG4_DP; C44 10 µF at the anodes.
- [x] B1.5 Add the driver IS31FL3236A (C246443): every pin from its datasheet, VCC from VBUS with decoupling, REXT for
  the segment current, SDB held low until firmware runs, an I²C address clear of U4, on U1's I²C bus. Re-check the bus
  pull-ups for two devices.
  - Done 2026-11-06: U8 pins from p2 (45 with the pad); OUT1–32 to the digits in reading order, OUT33–36 open; AD → GND (0x3C; U4 is 0x11); R28 10 kΩ (7.6 mA per segment maximum, p10); C42 1 µF + C43 100 nF (p1); SDB from U1 PC13 with R29 100 kΩ pull-down (PC13 is analog at reset; DS14217 Table 26 note 2 allows this light load). R20/R21 6.8 kΩ stay right for two devices.
- [x] B1.6 Update the current budget (display from VBUS, off before USB set-up).
  - Done 2026-11-06 (bom.md chain 10): display ≤ 252 mA from VBUS, about 169 mA showing a station at full brightness; board total ≤ 363 mA after USB set-up, unchanged before it (U8 shut down).
- [x] B1.7 Update bom.md (chain 9), sourcing.md, part-provenance.md and the wiring page.
  - Done 2026-11-06: bom.md chain 9, chain 6 SW3 row, U1 pin map; sourcing.md Rev B section; part-provenance.md; wiring.html (hosted: https://claude.ai/artifact/DUR85HqCDaUoV6nrXSEaHV).
- [x] B1.8 Run `tools/netcheck.py`.
  - Done 2026-11-06: 19 of 19 pass (102 placed parts, 47 part numbers).
- [x] B1.9 **Review checkpoint:** the user reviews the netlist changes.
  - Approved by the user 2026-11-06 ("looks ok"), with the instruction to work the schematic rigorously from the makers' own documents.

## Phase B2: Schematic (Rev A Phase 1, for the changed parts)

- [x] B2.1 Delete RV1–RV3 and C39–C41 from the sheet.
  - Done 2026-11-06 (`tools/sch_rev_b.py`): RV1–RV3, C39–C41 and their library symbol removed, with chain 3's wires from U1 PA3–PA5 to those caps and their ground bar (by uuid; chain 3 itself isn't rerouted, since every later chain's wires now cross its area).
- [x] B2.2 Place the encoder, the four digits, the driver and the new SW3, each checked pin by pin against its datasheet
  (Rev A steps 1.4–1.16), with their passives at the pins they serve (1.17) and their fields from netlist.json (1.18).
  - Done 2026-11-06. Makers' documents first: U8 from Lumissil's own Rev. I datasheet (10/14/2024, lumissil.com) and its evaluation-board guide (Rev. G, 02/14/2025), both saved in docs/datasheets/rev-b; the board's schematic confirms OUT1→43, OUT2→44, OUT3–18→1–16, OUT19–36→18–35, AD to GND, 100 kΩ on SDB, 1 µF on VCC. Guangcai's site only offers its PDF as a download; the saved copy is Guangcai's own spec (Rev A, 2020). Mitsumi's and Diptronics' saved copies are their own catalogue pages.
  - Symbols, pin by pin: U8 `IphoneFM:IS31FL3236A` built from the QFN-44 table (45 pins with the pad; OUTx open collector, VCC/GND/EP power in); DS1–DS4 `IphoneFM:GS3011AW-B`, KiCad's KCSA02-105 drawing, whose ten pins match GS3011A/CX-X p3 one for one, with the LED pins made passive; SW4 `IphoneFM:SIQ-02FVS3`, terminals 1 A, 2 S, 3 C, 4 B and frame tabs 5–10 (not M1–M6: the tools read Mn as pad 4–7); SW3 keeps `Switch:SW_DIP_x06`.
  - Placed per kicad/rev-b/sheet-plan.md (new Display zone under U1); passives at their pins; fields from netlist.json (`sch_fields`).
- [x] B2.3 Wire the new chain, label the nets, flags and no-connects (1.19–1.32), net classes and layout notes
  (1.33–1.34).
  - Done 2026-11-06 with the Rev A tools in their order (`sch_layout`, `sch_fields`, `sch_power`, `sch_wire 9`, `sch_flags`, `sch_labels`, `sch_noconnect`, `sch_notes`, `sch_pinids`): 48 chain-9 nets wired, every signal net labelled (the two labels Rev A placed by hand are now in `sch_labels.HAND`), NC flags on U8 OUT33–36 and none left on U1 PC13. New nets stay in the Default class (7.6 mA segments, far from the RF and the loop filter). Layout note 4 added for U8.
- [x] B2.4 ERC to zero errors; `kicadcheck.py --net` and `--bom` pass (1.35–1.37).
  - Done 2026-11-06: ERC 0 errors, 0 open warnings (Rev A's two reviewed U4 LOUT/ROUT exclusions remain); `kicadcheck.py --net --bom` 17 of 17; Rev A's sheet unchanged and still 11 of 11.
- [x] B2.5 **Review checkpoint:** the user reviews the sheet and the check results.
  - Approved by the user 2026-11-06 ("lets continue to footprints"). Found at B3.4: B2.1 had left the wheels' unused library symbol in the sheet (the removal looked for entries two tabs in; the sheet keeps them one tab in). Fixed in `sch_rev_b.drop_lib_symbol` and removed; nothing placed used it.

## Phase B3: Footprints (Rev A Phase 2, for the new parts)

- [x] B3.1 Choose each new part's footprint source in Rev A's order (KiCad's library, then the maker's, then LCSC) and record it in kicad/rev-b/footprints.md.
  - Done 2026-11-06. KiCad has no 5 × 5 mm 0.4 mm-pitch QFN-44, no GS3011 and no SIQ encoder, so U8, DS1–DS4 and SW4 are built from the makers' drawings. SW3 keeps KiCad's Omron A6H-6101 pads, which are Diptronics' layout exactly. The RV1–RV3 and C&K TDP06 footprints leave the Rev B library.
- [x] B3.2 Compare each footprint's pads with its maker's land pattern on a to-scale overlay, one table per part (Rev A 2.2).
  - Done 2026-11-06 (`tools/fp_rev_b.py`, overlay [footprint-overlays.png](footprint-overlays.png) by `tools/fp_overlay_rev_b.py`). Every pad matches the maker's drawing. The departures:
    - U8: KiCad can't round a single pad corner, so the corner pads' R0.125 corners are chamfered 0.125 instead (0.21 mm apart against Lumissil's 0.20), and the joins from pins 17 and 39 to the centre pad are square, not R0.1.
    - SW4: the angled frame tabs follow Mitsumi, which LCSC's footprint does not. Mitsumi's "2–4" is to the tabs' inner ends; the PDF's vectors put their centres 4.60 mm from the knob centre, where LCSC has 4.0.
  - LCSC's footprints were read as a second opinion only (footprints.md).
- [x] B3.3 Pin-to-pad, silkscreen and paste checks (Rev A 2.3–2.5).
  - Done 2026-11-06: `pinpad_check` 114 of 114, 0 mismatches. `fp_silk_trim` then `silk_check` pass (0.25 mm lines, ink at least 0.20 mm from copper); a second trim changes nothing. The encoder's wheel is drawn as chords, because the trim drops a circle whole. `paste_check`: 0 problems; pads 1:1, U8's centre pad four windows (65%).
- [x] B3.4 Assign the footprints, re-run ERC, re-export the netlist and run `kicadcheck.py --net --bom` (Rev A 2.6–2.7).
  - Done 2026-11-06 (`sch_footprints`). 15 symbols changed. KiCad's netlist has 114 parts, all on IphoneFM footprints that exist. ERC: 0 errors, 0 warnings (the two U4 items still excluded). kicadcheck 17 of 17. Rev A untouched (pin-to-pad still 106 of 106).
  - Carried to the board (Phase B4):
    - U8's pins are 0.15 mm apart in copper, under our 0.20 mm rule, so U8 needs its own clearance rule (JLC's minimum is 0.10).
    - Each digit's pads span 15.5 mm, not the body's 12.
    - SW4's knob (Ø14.5) overhangs everything inside its circle.
    - SW4's origin is the knob centre (placement-file offsets at Rev A step 8.3).
- [x] B3.5 **Review checkpoint:** the user reviews the footprints and their sources.
  - Approved by the user 2026-11-06 ("so we're good to continue?", after the overlay and the B3 report). Found at B4.2: `sch_power` had numbered one of its ground symbols #PWR103, which a ground symbol placed by hand in Rev A already uses (Rev B has more power symbols, so its count reached it); KiCad reported an annotation error on netlist export, ERC did not. `sch_power` now skips numbers held by symbols it didn't draw; rerun with `sch_pinids`, nothing else changed (every wire, symbol and position identical); ERC 0.

## Phase B4: Placement (Rev A Phase 4, for the new parts)

The board starts as Rev A's, placed and routed. The new parts go into the left column per the sketch
(`front-face-sketch.png`); the middle and right keep their Rev A placement and routing. Board edits are file edits with
KiCad's own Python (`tools/pcb_rev_b.py`), since the Rev B board is not open in KiCad. Copper the new parts land on is
taken up here and listed for Phase B5 (routing).

- [x] B4.1 Board setup for the new parts: U8's own clearance rule (its pins are 0.15 mm apart; JLC's minimum is 0.10).
  - Done 2026-11-06 (`pcb_rev_b.py rules`): inside U8's courtyard, copper keeps 0.15 mm (pads and the tracks leaving them); 0.20 mm everywhere else. Checked once U8 is on the board (B4.9).
- [x] B4.2 Bring the schematic across (Rev A 4.1): remove RV1–RV3 and C39–C41 and the copper only they used; swap SW3's
  footprint; add SW4, DS1–DS4, U8, R28–R32 and C42–C44 beside the board; every pad's net from KiCad's netlist.
  - Done 2026-11-06 (`pcb_rev_b.py update`), from KiCad's own netlist of the sheet: RV1–RV3 and C39–C41 removed with the 19 tracks on WHEEL1–3; SW3 swapped in place; 14 parts added beside the board; 127 pad nets set (the new parts', U1 PA3–PA5 and PC13); H1–H4 given the sheet's empty MPN/LCSC/Manufacturer fields. KiCad's DRC with schematic parity: 0 differences, so the board matches the sheet as Update PCB from Schematic would leave it.
- [x] B4.3 Place and lock SW3 at Rev A's SW3 position, levers up (Rev A 4.6), and join its tracks to the new pads.
  - Done 2026-11-06 (`pcb_rev_b.py fixed`): SW3 at Rev A's (35.925, 64.51), −90°, locked: pins 1–6 (ATT_C16 … C0_5) along the top row with pin 1 at the right, 7–12 (3V3) along the bottom, so "ON" (the 7–12 side) faces into the board. The pitch is Rev A's 1.27 mm, so the 12 Rev A track ends were moved straight onto the new rows (4.90/7.40 mm apart, Rev A 7.62).
- [x] B4.4 Place and lock SW4 where RV3 was, wheel out of the left edge, copper 0.5 mm from the edge (Rev A 4.5).
  - Done 2026-11-06: knob centre (17.19, 112.0), 90° (terminals into the board), locked. The sketch had the frame's end on the edge (centre 16.55), but the two 45° frame tabs then reach 0.13 mm past the edge; the knob moved 0.64 mm in so their copper is 0.51 mm from it (our 0.50 rule). The wheel stands 2.76 mm past the edge (sketch 3.4, Rev A's wheels 1.9), so the panel's left rail gap must clear 2.76 mm (Phase 8). TP4 moved 0.1 mm down, clear of SW4's courtyard.
- [x] B4.5 Place and lock DS1–DS4 where RV1 and RV2 were, turned to read with the phone's left edge down, DS1 at the top.
  - Done 2026-11-06: DS1–DS4 at x 20.96, y 73.61 / 81.91 / 90.21 / 98.51, −90° (each digit's top toward the board's right edge, so they read 1-0-7-9 left to right with the phone's left edge down), locked; outer pads 0.51 mm from the left edge. Pitch 8.3 mm, not the sketch's 8.0: at 8.0 the B3 courtyards (body + 0.35 mm) touch, against our 0.3 mm courtyard gap; the display keeps the sketch's centre. Digits 1.0 mm apart instead of 0.7.
- [x] B4.6 Place U8 by the display with R28, R29, C42 and C43 at its pins (Rev A 4.11, 4.13).
  - Stopped for the user's choice (2026-11-06): the sketch's spot right of DS1 ("roughly here") is not free: U8's 6.5 mm courtyard there overlaps DS1's courtyard, TP2, TP3, the 3V3 feed from TP2 and three of U1's LED lines to D1, all Rev A routing. The space above the display (left of H1, x 13–23, y 60–69) holds only ground stitching vias. Picture: placement-b4.png (A, B).
  - The user chose B, above the display (2026-11-06). Done (`pcb_rev_b.py u8`): U8 at (18.0, 65.47), 0°, locked: control pins (SDB, VCC, R_EXT, SDA, SCL) toward the top edge, OUT1–OUT32 on the other three sides toward the digits. R28, C43 and R29 straight out from pins 40, 38 and 36, spread as Rev A 4.13 (pcb_local.py), 1.6–1.7 mm from their pins; U8 as high as that row's copper allows (0.51 mm from the top edge), leaving 0.80 mm between U8's and DS1's courtyards. C42 (0603) is too deep for the row and lies along the top edge right of it, 3.9 mm from pin 38. U8 pin 37 (AD, ground) is a starved thermal in the top pour (0.4 mm pitch): B5 joins it to the exposed pad.
- [x] B4.7 Place R30–R32 at SW4's terminals and C44 at the anodes (Rev A 4.13).
  - R30–R32 done 2026-11-06 (`pcb_rev_b.py pullups`): each straight out from its terminal (A, B, S), its signal pad toward it, 0.3 mm courtyard gap to SW4. C44 waits for B4.6: DS2 pin 3 (its local_to) is in the outer pad row by the edge, with no room beside it, so it goes on the display's VBUS feed by U8. C44 done 2026-11-06 (`pcb_rev_b.py u8`): along the top edge right of C42, above H1, VBUS pad toward U8.
- [x] B4.8 Move TP2 and TP3 and clear the left column: Rev A copper under the new parts is taken up and listed for B5.
  - Copper taken up 2026-11-06 (`pcb_rev_b.py clear`): every Rev A track and via a new part's pad, hole or courtyard lands on, then what that left dangling, then Rev A copper that had taken a new pad's net (a ground stub under R31). Against the B4 start: 149 items: 19 wheel tracks, 69 ground stitching vias and 14 ground stubs in the left column, 27 on 3V3 (the top-layer feed up the column) and 20 on RF_MODE (U1 to SW1, TP4, R18 and R17). Bottom-layer tracks under the digits stay (VBUS at x 25.6). For B5: 3V3 and RF_MODE to re-route, plus the new nets. TP2 and TP3 wait for B4.6.
  - TP2 done 2026-11-06 (`pcb_rev_b.py tp2`, then `clear` again): TP2 (3V3) from under DS1 to (30.65, 74.84), right of DS1 and below TP3, 0.3 mm courtyard gaps; the Rev A 3V3 run to SW3 started at TP2's pad and crossed the via down to the feed, so its end was pulled back to that via (29.6, 69.3) and the run stays whole. B5 joins TP2 to 3V3. TP3 stays: with U8 at B it is in nobody's way. The second clear took up 8 ground stitching vias under U8's group. Ground stitching vias left beside U8 (x 14.2 and 23.2) are B5's to move if the outputs need the room.
- [x] B4.9 Check courtyards, mechanical fit and DRC; `kicadcheck.py --pcb`; schematic parity (Rev A 4.16–4.17).
  - Done 2026-11-06: DRC with schematic parity: 0 differences; no clearance, courtyard, edge or mask errors; one error, U8 pin 37's starved thermal (B4.6, for B5); silkscreen warnings left for the silkscreen step, as Rev A. `IPHONEFM_REV=rev-b kicadcheck.py --pcb --layout none`: all pass. Local parts to their pins: R28, R29, C43 1.6–1.7 mm, C42 3.9 mm, R30–R32 1.8 mm; C44 by U8 (B4.7). U8's own clearance rule (B4.1) applies only inside its courtyard. Unconnected, for B5: the new nets, 3V3 (TP2 and the islands B4.8 left), RF_MODE and VBUS.
- [x] B4.10 **Review checkpoint:** the user reviews the placement.
  - Approved 2026-11-06.

## Phase B5: Routing (Rev A Phase 5, for the new parts and the copper B4 took up)

Rollback point: tag `rev-b-b5-start`. One plan, `tools/pcb_route_rev_b.py lay`, laid as a file edit with KiCad's own
Python; Rev A copper in its way is taken up by exact position. Lines leave pins straight, bend only by 45° and keep one
pitch per bus (routing-quality standard), checked by `tools/pcb_quality.py --pcb` alongside DRC.

- [x] B5.1 The digits' two anode pins (3 and 8) are one node inside the part (GS3011A/CX-X p3, "3,8"): declare them a
  jumper pad group in the footprint, so VBUS reaches each digit at pin 8 only.
  - Done 2026-11-06: `jumper_pad_groups ("3" "8")` in `tools/fp_rev_b.py`, the library footprint and the four board
    footprints. Each digit's anode then carries up to 61 mA (8 × 7.6 mA) through one pin.
- [x] B5.2 Map U8's outputs to the segments in the order their lines leave U8 on the board (netlist.json's note allows
  it; firmware maps it), so no two lines cross.
  - Done 2026-11-06. Top-layer bus: pins 12–16, 18–22 (bottom side) to DS1 E, D, C, DP, DS2 E, D, C, DP, DS3 E, D;
    pins 23–31 (right side) to DS3 C, DS2 B, A, F, G, DS1 B, A, F, G. Bottom-layer bus: pins 11–1 (left side) to DS3 DP,
    DS4 E, D, C, DP, B, A, F, G, DS3 B, A; pins 33, 32 to DS3 F, G. OUT1, OUT2 (pins 43, 44) and OUT35, OUT36 are open.
  - The sheet: the 32 segment lines became net labels at both ends (the board order crosses on the sheet;
    `sch_wire.py` skips them for Rev B), with DS1/DS2 7.6 mm further right and DS3/DS4 10.2 mm further left so the
    labels face each other (`sch_layout.py`); sheet tools rerun in their order. ERC 0 errors (the two reviewed U4
    exclusions), `kicadcheck.py --net --bom` 17 of 17; board pad nets updated (`pcb_rev_b.py update`, 34 pads).
- [x] B5.3 Fan out U8's 32 outputs to DS1–DS4 under the finer rules near U8 (the user's approval 2026-11-06,
  fab-rules.md "Rev B exception").
  - Done 2026-11-06. Rule areas "U8 fan-out" and four rules in IphoneFM.kicad_dru: 0.127 mm tracks and gaps, 0.4/0.2 mm
    vias, 0.2 mm holes to copper.
    - Top: the bottom side's ten lines leave 1 mm straight and step right together (0.127 mm until on their lanes, so
      pin 13 clears DS1's E pad); pin 12 runs straight into DS1 E. The right side's nine turn down at 0.254 mm pitch
      past H1, then step onto the bus. 19 lanes at 0.4 mm between the pad columns; each line peels off in pad order.
    - Bottom: the left side's 11 pins to two via columns (odd x 14.35, even x 13.55, the even lines between the odd
      vias), east under U8 and turned down at 0.254 mm; pins 32–33 to vias right of U8 and back under it. The 13 step
      onto a 0.4 mm bus (x 18.0–22.8) and come up through vias beside DS3's and DS4's pads (x 16.9 and 24.6).
- [x] B5.4 VBUS to the digits, U8, C42–C44.
  - Done 2026-11-06. The bottom spine (x 25.6) up to DS1, a via and stub to each digit's pin 8. DS1's pin 8 carries
    the north band's VBUS east to the x 32.3 riser (Rev A's bottom link at y 77.6 taken up). U8's feed: a bottom riser at
    x 27.35, clear of H1, the top line under C44 and C42, a via down and a 0.4 mm via between C43 and U8's VCC pin.
- [x] B5.5 U8's control lines.
  - Done 2026-11-06. SCL and SDA straight up to 0.4 mm vias (R28 sits over them), SDB to a via and R29, R_EXT into R28,
    AD into the exposed pad. On the bottom the three run east under the top-edge parts, down x 28.2–29.0 beside DS1,
    then east between the 3V3 feed and DS2: SDB down to a via at U1 PC13, SCL and SDA to vias on U1–U4's I2C lines at
    (49.8, 77.4) and (49.0, 78.0).
- [x] B5.6 3V3 re-joined (B4.8 took up its feed up the left column).
  - Done 2026-11-06. TP2 to the bottom feed; from TP2 under DS1/DS2's inner pads on the bottom, across between DS2 and
    DS3 on the top and down the middle of the digits to R31, R32, R30 and on to U3 (and C2); U3 to U2's island through
    Rev A's link; FB2/C3 up over the I2C lines to the feed; U1's north pins (U1.1, U1.48, C6) by x 41.2.
- [x] B5.7 The encoder lines and RF_MODE.
  - Done 2026-11-06. Vias off U1's west pins, a bottom bus at x 27.35–28.55 (more than 1 mm from BOOT0), up beside R31,
    R32 and R30 to their pull-ups and SW4's terminals. RF_MODE hops the 3V3 link on the top (at CC1/CC2's 0.45 mm
    pitch) and goes Rev A's way to R17, TP4, SW1 and R18.
- [x] B5.8 Ground.
  - Done 2026-11-06. Three vias in U8's exposed pad. The bottom lines close in the pour under U8, so U8's ground leaves
    by pin 39 (joined to the pad) to a via at the top edge, into the bottom pour between the edge and the SCL line, with
    R28, C43, R29 and C42's ground pads. The north band's ground (SW3's resistors, TP3, U8) reached the rest through
    Rev A's stitching in the left column, which the digits now fill: 6 vias where one layer's pour is the north band's
    and the other's the rest's (by H1, under the LED lines at y 72.75, beside DS2's B pad). 19 Rev A stitching vias and
    3 dangling ground stubs in the new lines' way taken up.
- [x] B5.9 Checks.
  - Done 2026-11-06 (pours refilled): DRC with schematic parity: 0 differences, 0 unconnected, no clearance, track,
    via or hole errors (silkscreen warnings left for the silkscreen step, as Rev A). `pcb_quality.py --pcb`: 1154
    segments, 0 findings. One ground network (no isolated pour). `IPHONEFM_REV=rev-b kicadcheck.py --pcb --layout
    none`: 13 of 13. 410 tracks and 70 vias laid; 31 Rev A items taken up.
  - Lengths against each net's pad span: no accidental detours. Highest: SEG1_D 1.57× (its step clear of DS1's E pad),
    I2C SDA/SCL 1.5× (round the north band, whole net), LED_SDB 1.38×.
  - Pictures: `routing-b5-u8.png`, `routing-b5-board.png`.
- [x] B5.10 **Review checkpoint:** the user reviews the routing.
  - Approved 2026-11-06, including VBUS to pin 8 only, the segment remap with labels on the sheet, and the fan-out
    areas reaching below U8.

## Phase B6: Ground pours (Rev A Phase 6)

Rollback point: tag `rev-b-b6-start`. Rev A's tools for Phases 6–8 work through KiCad's live API; the Rev B board is
not open in KiCad, so their Rev B steps are file edits with KiCad's own Python: `tools/pcb_finish_rev_b.py` (pours) and
`tools/pcb_silk_rev_b.py` (silkscreen), same rules and numbers as Rev A's.

- [x] B6.1 Pours on both layers, 0.5 mm back from the edge (Rev A 6.1).
  - Rev A's "GND top" and "GND bottom" carry over unchanged and are refilled after every board edit.
- [x] B6.2 Stitch the pours (Rev A 6.2).
  - Done 2026-11-06 (`pcb_finish_rev_b.py stitch`): Rev A's grid (3 mm, 1.5 mm in the RF zones, the same origin and
    rules), plus one rule for Rev B: no via in a ground SMD pad. 14 vias, where the left column has room again: one by
    U8's top-left corner, the rest round and under SW4 (Mitsumi's land drawing, p3, marks no keep-out under the body;
    the frame is ground). With B5.8's six joining vias, 280 vias in all.
- [x] B6.3 Solid connections (Rev A 6.3).
  - Rev A's solid pads carry over; DRC finds no pad starved of spokes (B5 joined U8 pin 37 to the exposed pad).
- [x] B6.4 No dead copper (Rev A 6.4).
  - One ground network (every fill, pad, track and via joined, by geometry); DRC: no isolated fill, no dangling items.
- [x] B6.5 Copper balance (Rev A 6.5).
  - 63% of the top and 79% of the bottom (Rev A 71% and 87%): the display's fine lines take pour on both sides.
    Roughly balanced for a two-layer 1.6 mm board.
- [ ] B6.6 **Review checkpoint:** the user reviews the pours, with Phase B7.

## Phase B7: DRC, the netlist comparison and the silkscreen (Rev A Phase 7)

- [x] B7.1 Silkscreen (Rev A 7.1 and its review).
  - Done 2026-11-07 (`pcb_silk_rev_b.py`):
    - `edge`: every silkscreen line cut back 0.2 mm inside the edge. SW4's wheel outline is cut where it overhangs (2
      lines cut back, 22 removed). The digits' pin-1 dots sat past the edge (x 12.61, edge 12.70) and are removed, as
      Rev A's SW3 dot was; each digit's decimal point shows its turn.
    - `refs`: Rev A's labelling (major parts only, 1.0 mm text, clear of copper, courtyards and ink). U8, SW3, SW4, DS2
      and DS4 placed beside their parts; DS1 (TP2/TP3 beside it) and DS3 (U1's corner) have no clear spot and stay on the
      fab layer only, as Rev A's eight. R28–R32 and C42–C44 off the silkscreen (passives). B4.2 had left the new parts'
      MPN/LCSC/maker fields visible on the silkscreen: hidden on the fab layer, as Rev A's (and `pcb_rev_b.set_fields`
      fixed). SW1 keeps its Rev A label: two strokes of SW4's wheel outline shortened 0.15 and 0.21 mm to clear it.
    - `tag`: Rev A's tag ("CLAUDE / WAS HERE" over an FM wave) sat where U8 now is. No clear spot on the top fits it
      (the one open stretch, under SW3, carries B5.8's joining vias), so it moved to the bottom, mirrored to read from
      underneath, the nearest clear spot to its old place (x 13.7–22.6, y 66.8–74.5).
    - `dot`: SW4's terminal-1 dot sat between terminal A and R30, clipped by R30's mask opening; moved to the outer end
      of the terminal row, 1.2 mm past terminal A.
  - Pictures: `silk-b6-top.png`, `gerber-b8-top.png`, `gerber-b8-bottom.png`.
- [x] B7.2 DRC against the JLC rules, with schematic parity (Rev A 7.1–7.2).
  - 2026-11-07 (all severities): 0 errors, 0 unconnected, 0 parity differences; no silkscreen findings. The only
    warnings are footprints that differ from the library: the trimmed edge parts, as Rev A. `pcb_quality.py --pcb`:
    1154 segments, 0 findings.
- [x] B7.3 `netcheck.py` and `kicadcheck.py --net --bom --pcb` (Rev A 7.3).
  - 2026-11-07: netcheck 19 of 19; ERC 0; kicadcheck `--net --bom` 17 of 17, `--pcb --layout none` 13 of 13.
- [x] B7.4 Holes, rings and widths (Rev A 7.4).
  - Vias 260 × 0.6/0.3 mm and 20 × 0.4/0.2 mm (U8's fan-out areas only, fab-rules.md "Rev B exception"); tracks 0.127 mm
    only in those areas, 0.2 mm and up elsewhere. Unplated holes: SW4's two Ø1.6 bosses join Rev A's 0.6, 0.85 and 2.2;
    the wheels' 1.1 mm slots are gone. No courtyard overlaps.
- [x] B7.5 Part heights (placement rule M9).
  - J2 9.5 mm stays tallest; SW4 4.0 (Mitsumi p3 side view), DS1–DS4 3.75, J1 3.26, SW3 now 1.6. M9 updated.
- [ ] B7.6 **Review checkpoint:** the user reviews the pours, the silkscreen and every check result.

## Phase B8: Outputs (Rev A Phase 8)

`tools/pcb_panel.sh`, `tools/pcb_export.sh`, `tools/jlc_outputs.py` and `tools/kikit_tabs.py` take `IPHONEFM_REV=rev-b`
(Rev A's outputs unchanged). `tools/pcb_assembly.py --pcb` reads the board file through KiCad's Python.

- [x] B8.1 Gerbers and drill files with JLC's settings (Rev A 8.1).
  - 2026-11-07 from the panel: `kicad/rev-b/output/jlc/IphoneFM-RevB-gerbers.zip`.
- [x] B8.1a Assembly drawing.
  - `kicad/rev-b/output/assembly/IphoneFM-RevB-assembly.pdf`, two A3 pages as Rev A's.
- [x] B8.2 BOM in JLC's format.
  - `IphoneFM-RevB-BOM.csv`: 47 lines. Stock 2026-11-07: every line covers 6 boards (pre-order-checks.md); U1 global
    sourcing as Rev A.
- [ ] B8.3 Panel and pick-and-place; every part's rotation checked in JLC's preview.
  - Panel 2026-11-07 (`IPHONEFM_REV=rev-b sh tools/pcb_panel.sh`): Rev A's frame, rails and gaps (SW4's wheel, 2.76 mm
    past the left edge, is inside the 9.5 mm gap). Tabs where no courtyard is within 2 mm of the edge: C42, C44 and R28
    now sit by the top edge, so both top tabs move into the top's one clear stretch (33.0 and 43.0 mm from the left);
    the left tab stays at 5.1 mm (signal vias of U8's fan-out 0.65 mm in from the edge, 0.4 mm from the mouse-bite
    holes against the 0.25 mm rule; no other clear stretch on that edge); the right tabs as Rev A. Panel DRC: 0
    errors, 0 unconnected.
  - `IphoneFM-RevB-CPL.csv`: 102 parts, matching the BOM. The new parts' EasyEDA footprints (what JLC's viewer draws)
    fitted to ours pin by pin, 2026-11-07: U8 and SW3 a 270° turn, SW4 a 2.44 mm origin shift, the digits and
    passives none (pre-order-checks.md); added to JLC_FIX and the CPL rebuilt. JLC's 3D preview at the upload is the
    last look.
- [x] B8.4 Read the Gerbers back (Rev A 8.4, `tools/gerber_view.py`).
  - 2026-11-07: all nine layers and both drill files found. Drill: 260 × 0.3 and 20 × 0.2 mm vias, five 1.4 mm (J2),
    four 0.6 mm plated slots (J1); unplated 25 × 0.5 mouse bites, 2 × 0.6 (J1), 2 × 0.85 (SW1), 2 × 1.6 (SW4),
    4 × 2.2 (mounting). Bottom paste empty. Top and bottom drawn as built: `gerber-b8-top.png`, `gerber-b8-bottom.png`.
- [x] B8.5 Upload to JLC for a quote, DFM and the rotation check only; the user places the order.
  - Done for Rev C 2026-11-11 (pre-order-checks.md, "JLC upload"): preview matches the pin fits; $175.33 for 2
    assembled without U1 and U7 (both global sourcing) and shipping. Nothing put in the cart.
- [ ] B8.6 **Final review:** commit the project and tag it `rev-b`.

## Rev C: U8's fan-out on JLC's standard vias (branch `rev-c`, 2026-11-11)

The user's request: try a re-route so the board avoids JLC's high-precision via pricing. At the B8.5 quote, Rev B's
0.4/0.2 mm fan-out vias brought plugged vias and a 4-wire test, about $51 more for 5 panels; 0.25 mm holes cost the
same, so only 0.30 mm saves. Everything else is Rev B as reviewed.

- [x] C.1 Re-plan U8's left side for 0.45/0.30 mm vias (`tools/pcb_route_rev_b.py`, laid from the B5 start).
  - A 0.30 mm hole needs 0.35 mm from its centre to other copper; a line threading between two vias 0.8 mm apart gets
    0.34. Now no line passes between two vias: odd pins go out to vias at x 14.35, even pins in, past their heels, to
    vias at x 16.39 between the pin ring and the exposed pad (0.127 mm from both). On the bottom, each column comes
    down in its own lanes (the higher the via, the further east), then the 13 lines join the bus as before.
  - The lanes now run 11 9 7 5 3 1 10 8 6 4 2 west to east, so pins 1–10 drive different segments (the digits' pads
    keep their lanes): netlist.json's U8 pinmap and net notes updated, the sheet's labels moved by the schematic tools,
    the firmware table in pre-order-checks.md regenerated.
  - SCL bends left at its toe over the unused pins 43–44, so SDA's via sits up-left of its pin; the pins 32/33 vias and
    two ground vias by R28/R29 move 0.02–0.05 mm. All 20 fan-out vias are 0.45/0.30 mm; the fan-out rule in
    IphoneFM.kicad_dru follows.
  - Quality rule: the even pins leave inwards. `pcb_quality.py` now allows an inward exit only straight along the
    pad's axis, in one segment of at most 1.0 mm, onto the pin's own via inside the part's courtyard (to review).
- [x] C.2 Checks, with B6–B7 redone on the new copper (stitching, silkscreen, tag, SW4 dot).
  - DRC with schematic parity: 0 errors, 0 unconnected, 0 parity; `pcb_quality.py --pcb`: 1144 segments, 0 findings;
    ERC 0; netcheck 19 of 19; kicadcheck `--net --bom` 17 of 17, `--pcb` 13 of 13; one ground network; copper 63% /
    79% as before. Drill file: every plated via 0.30 mm (280).
  - JLC quote with the new Gerbers (2026-11-11): read as a standard board, $7.50 for 5 bare panels (Rev B's vias:
    $58.53), surface finish aside.
  - Picture: `routing-c-u8.png`.
- [x] C.3 **Review checkpoint:** the user reviews the new fan-out, the inward-exit allowance and the segment remap.
  - Approved 2026-11-11, with the inward escapes. The user's choices: HASL (with lead, as Rev A; ENIG not needed for a
    prototype, Economic assembly available), and the board renamed Rev C (title blocks Rev C, 2026-11-11; panel rail
    text and output files IphoneFM-RevC-*; the files stay in the rev-b folders).
