louisflakes/IphoneFM/design/rev-b/wiring.html

# IphoneFM Rev B wiring

Rev B: Rev A (analog FM, option D2) with a new front panel. A push-wheel encoder (SW4) tunes, four white digits (DS1–DS4) on an IS31FL3236A driver (U8) show the station, and SW3 is a top-lever DIP. Plan C is archived (design/archive/plan-c/ in the repo). The LMX2571’s internal VCO makes the carrier and U1 streams the FM deviation to it over I²S, so there is no analog modulator. The power level comes from a DIP switch on a step attenuator, and receive is the Si4705 as before. U1’s pins were checked against DS14217 Tables 26–28 and the ROM bootloader’s pins (AN2606 Table 165). Lines are nets; short stubs are parts local to one chip; “▲ 3V3” means wired to U3’s 3.3 V output. Tap a pin for its datasheet source.

Tap a pin.

## Netlist

Net | From | To | In between | Source

Sources: STM32U535 DS14217 Rev 5 (https://mm.digikey.com/Volume0/opasdata/d220001/medias/docus/8915/STM32U535CEU6QTR.pdf) · ST AN2606 Rev 61 (bootloader) · TI LMX2571 SNAS654A (https://www.ti.com/lit/ds/symlink/lmx2571.pdf) · TI SNAA309 (FSK I²S) · pSemi PE43711 (https://www.psemi.com/pdf/datasheets/pe43711ds.pdf) · pSemi PE42421 (https://www.psemi.com/pdf/datasheets/pe42421ds.pdf) · Si4704/05-D60 Rev 1.2 (https://www.skyworksinc.com/-/media/Skyworks/SL/documents/public/data-sheets/Si4704-05-D60.pdf) · AN332 · AN383 · YXC OT322520MJBA4SL (YSO110TR) · AP2112 (https://www.diodes.com/assets/Datasheets/AP2112.pdf) · HRO TYPE-C-31-M-12 · Diptronics DHN series · Mitsumi SIQ series · Guangcai GS3011A/CX-X · ISSI IS31FL3236A · Shou Han MSK12C02 · XINGLIGHT XL-1615RGBC-RF · Panasonic EVQ-P7 · Semtech RClamp0521P · BAT Wireless BWSMA-KWE-Z001 · USB Type-C R2.5. Every part and value is in design/rev-b/bom.md (chains 1–10); designators come from design/rev-b/netlist.json, checked by tools/netcheck.py; local copies of the datasheets in docs/datasheets/. Net routes are drawn by hand; the netlist table is the source of truth.
