louisflakes/IphoneFM/design/archive/plan-b/wiring.html

# iPhone FM wiring — Plan B

Alternative to Plan A, not a replacement. Swaps the STM32F072 for a Microchip ATSAMD51G18A (U1) and adds a Si4704 FM receiver (U4) for scanning and listening. J1, U3 and U2 are unchanged. Lines are nets; short stubs are parts local to one chip; “▲ 3V3 rail” means wired to U3’s 3.3 V output. Tap a pin for its datasheet source.

Tap a pin.

## Netlist

Net | From | To | In between | Source

Sources: SAMD5x DS60001507 (https://ww1.microchip.com/downloads/aemDocuments/documents/MCU32/ProductDocuments/DataSheets/SAM-D5x-E5x-Family-Data-Sheet-DS60001507.pdf) · Si4704/05-D60 Rev 1.2 (https://www.skyworksinc.com/-/media/Skyworks/SL/documents/public/data-sheets/Si4704-05-D60.pdf) · AN332 (https://www.skyworksinc.com/-/media/Skyworks/SL/documents/public/application-notes/AN332.pdf) · LV2285VB ENA1494 (https://datasheet.lcsc.com/datasheet/pdf/aaf9ba5a5acc70222fbd7624956da41a.pdf) · AP2112 (https://www.diodes.com/assets/Datasheets/AP2112.pdf) · GCT USB4105 (https://gct.co/files/drawings/usb4105.pdf) · USB Type-C R2.5. Net routes are drawn by hand; the netlist table is the source of truth.
