louisflakes/IphoneFM/kicad/rev-b/IphoneFM.kicad_pcb

## KiCad design kicad/rev-b/IphoneFM.kicad_pcb (2026-11-11)

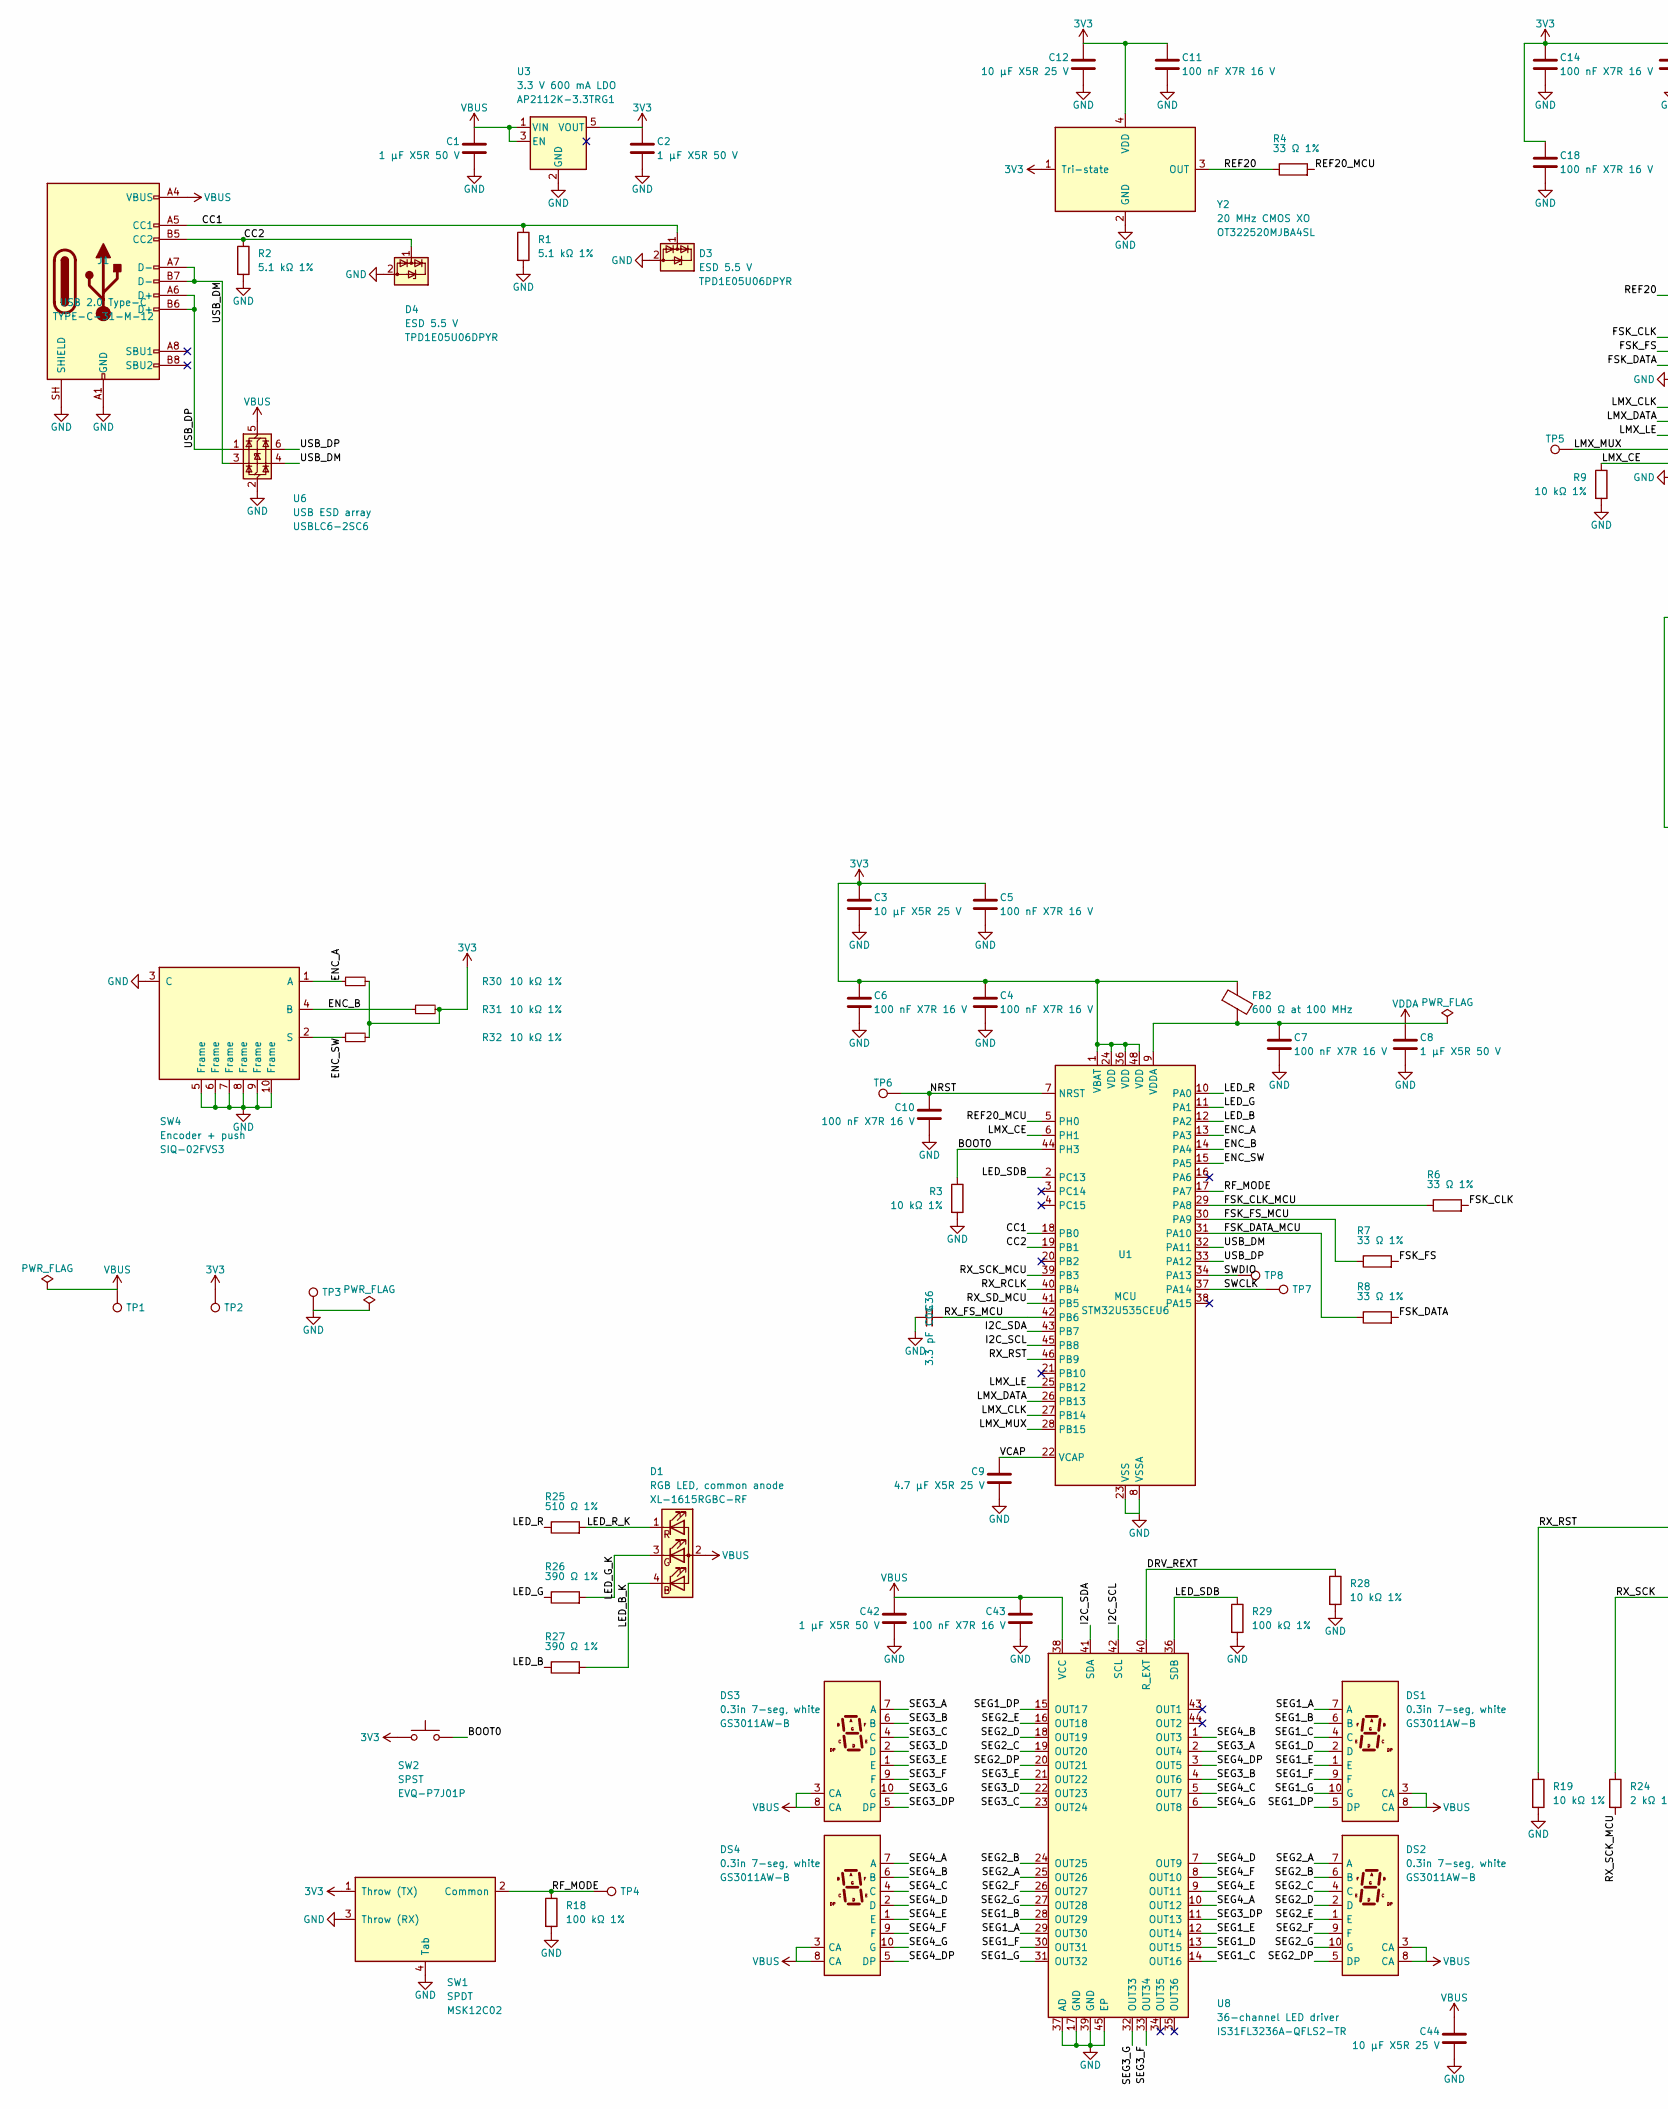
[picture p13: schematic IphoneFM.kicad_sch, part in row 1, column 1]

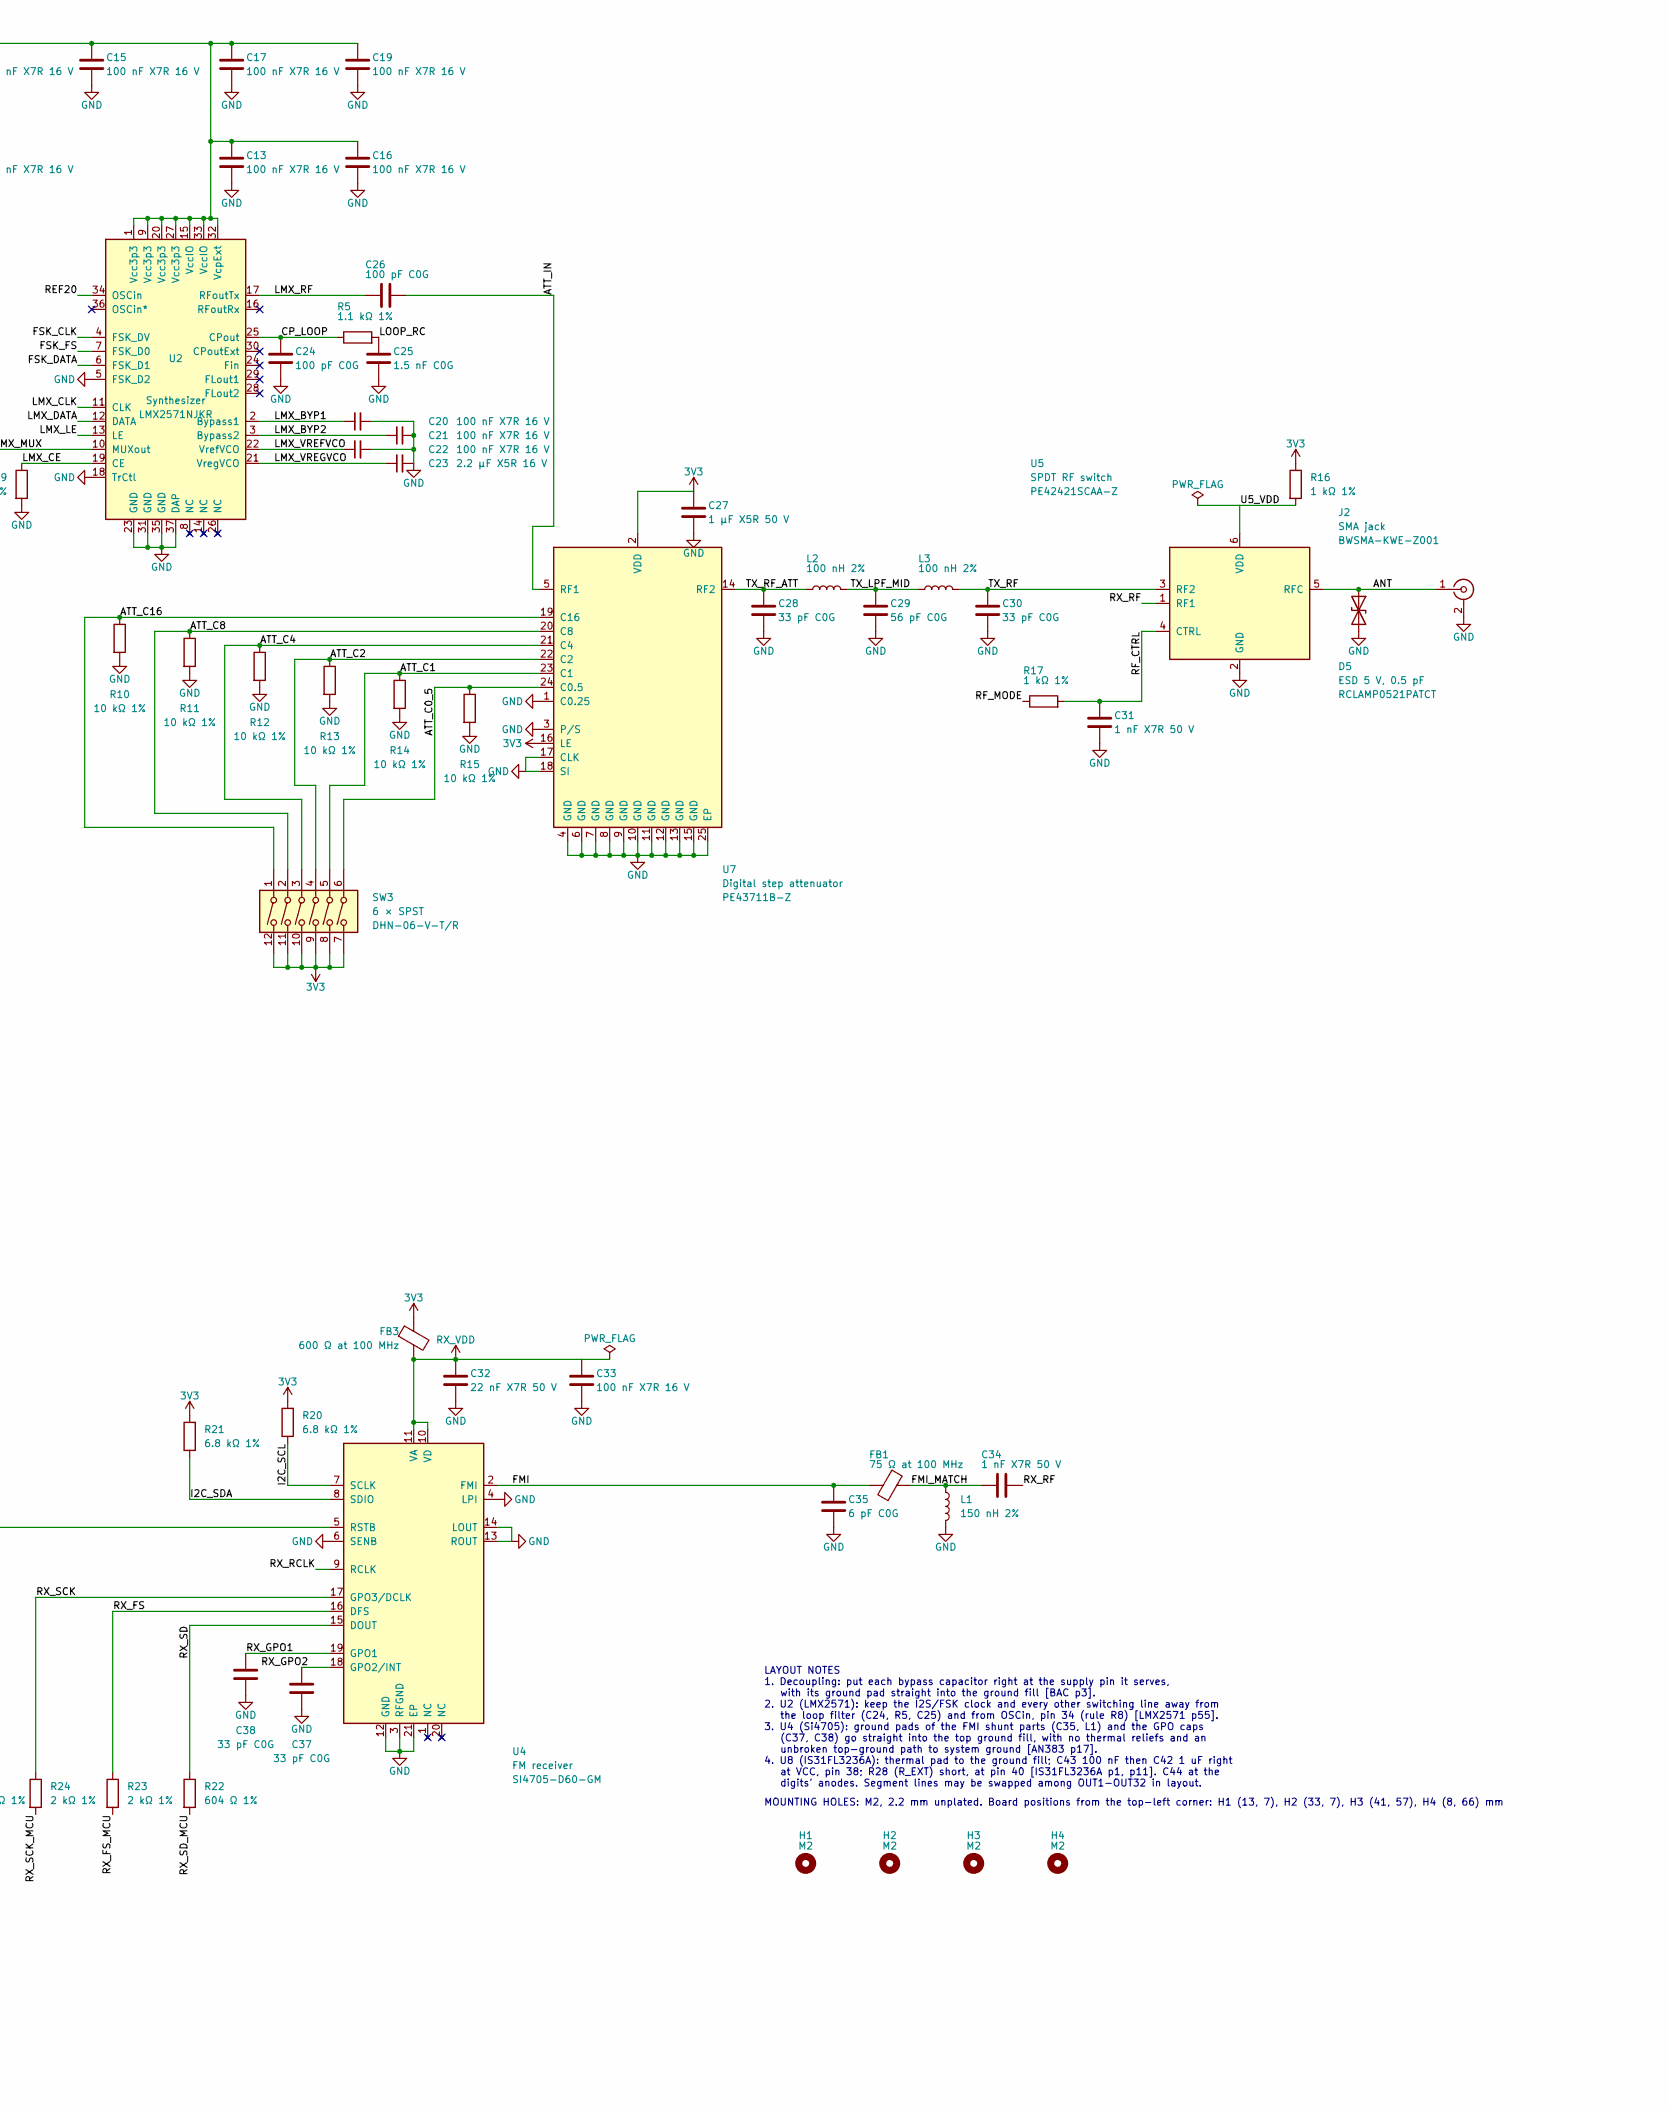
[picture p14: schematic IphoneFM.kicad_sch, part in row 1, column 2]

Parts:
C1, C2, C8, C27, C42: 1 µF X5R 50 V; C_0603_1608Metric; MPN CL10A105KB8NNNC; LCSC C15849
C3, C12, C44: 10 µF X5R 25 V; C_0805_2012Metric; MPN CL21A106KAYNNNE; LCSC C15850
C4, C5, C6, C7, C10, C11, C13, C14, C15, C16, C17, C18, C19, C20, C21, C22, C33, C43: 100 nF X7R 16 V; C_0402_1005Metric; MPN CL05B104KO5NNNC; LCSC C1525
C9: 4.7 µF X5R 25 V; C_0805_2012Metric; MPN CL21A475KAQNNNE; LCSC C1779
C23: 2.2 µF X5R 16 V; C_0603_1608Metric; MPN CL10A225KO8NNNC; LCSC C23630
C24, C26: 100 pF C0G; C_0402_1005Metric; MPN 0402CG101J500NT; LCSC C1546
C25: 1.5 nF C0G; C_0402_1005Metric; MPN GRM1555C1H152JA01D; LCSC C668348
C28, C30, C37, C38: 33 pF C0G; C_0402_1005Metric; MPN 0402CG330J500NT; LCSC C1562
C29: 56 pF C0G; C_0402_1005Metric; MPN CC0402JRNPO9BN560; LCSC C107007
C31, C34: 1 nF X7R 50 V; C_0402_1005Metric; MPN 0402B102K500NT; LCSC C1523
C32: 22 nF X7R 50 V; C_0402_1005Metric; MPN 0402B223K500NT; LCSC C1532
C35: 6 pF C0G; C_0402_1005Metric; MPN GJM1555C1H6R0CB01D; LCSC C161330
C36: 3.3 pF C0G; C_0402_1005Metric; MPN GRM1555C1H3R3CA01D; LCSC C76968
D1: RGB LED, common anode; LED_RGB_XINGLIGHT_XL-1615RGBC_1.6x1.5mm; MPN XL-1615RGBC-RF; LCSC C965840
D3, D4: ESD 5.5 V; Texas_DPY0002A_0.6x1mm_P0.65mm; MPN TPD1E05U06DPYR; LCSC C436349
D5: ESD 5 V, 0.5 pF; D_SOD-882; MPN RCLAMP0521PATCT; LCSC C117554
DS1, DS2, DS3, DS4: 0.3in 7-seg, white; LED_7Segment_Guangcai_GS3011_7.3x12mm_P1.5mm; MPN GS3011AW-B; LCSC C22462661
FB1: 75 Ω at 100 MHz; L_0402_1005Metric; MPN BLM15GA750SN1D; LCSC C113009
FB2, FB3: 600 Ω at 100 MHz; L_0402_1005Metric; MPN BLM15AG601SN1D; LCSC C76884
H1, H2, H3, H4: M2; MountingHole_2.2mm_M2
J1: USB 2.0 Type-C; USB_C_Receptacle_HRO_TYPE-C-31-M-12_2020; MPN TYPE-C-31-M-12; LCSC C165948
J2: SMA jack; SMA_BAT_Wireless_BWSMA-KWE-Z001; MPN BWSMA-KWE-Z001; LCSC C496551
L1: 150 nH 2%; L_0603_1608Metric; MPN LQW18ANR15G00D; LCSC C113131
L2, L3: 100 nH 2%; L_0603_1608Metric; MPN LQW18ANR10G00D; LCSC C98088
R1, R2: 5.1 kΩ 1%; R_0402_1005Metric; MPN 0402WGF5101TCE; LCSC C25905
R3, R9, R10, R11, R12, R13, R14, R15, R19, R28, R30, R31, R32: 10 kΩ 1%; R_0402_1005Metric; MPN 0402WGF1002TCE; LCSC C25744
R4, R6, R7, R8: 33 Ω 1%; R_0402_1005Metric; MPN 0402WGF330JTCE; LCSC C25105
R5: 1.1 kΩ 1%; R_0402_1005Metric; MPN ERJ-2RKF1101X; LCSC C409028
R16, R17: 1 kΩ 1%; R_0402_1005Metric; MPN 0402WGF1001TCE; LCSC C11702
R18, R29: 100 kΩ 1%; R_0402_1005Metric; MPN 0402WGF1003TCE; LCSC C25741
R20, R21: 6.8 kΩ 1%; R_0402_1005Metric; MPN RC0402FR-076K8L; LCSC C93940
R22: 604 Ω 1%; R_0402_1005Metric; MPN RC0402FR-07604RL; LCSC C273693
R23, R24: 2 kΩ 1%; R_0402_1005Metric; MPN 0402WGF2001TCE; LCSC C4109
R25: 510 Ω 1%; R_0402_1005Metric; MPN 0402WGF5100TCE; LCSC C25123
R26, R27: 390 Ω 1%; R_0402_1005Metric; MPN RC0402FR-07390RL; LCSC C137997
SW1: SPDT; SW_SPDT_Shouhan_MSK12C02_Tabs4; MPN MSK12C02; LCSC C431540
SW2: SPST; SW_SPST_EVQP7A; MPN EVQ-P7J01P; LCSC C2828254
SW3: 6 × SPST; SW_DIP_SPSTx06_Slide_Diptronics_DHN-06_W6.15mm_P1.27mm; MPN DHN-06-V-T/R; LCSC C224997
SW4: Encoder + push; RotaryEncoder_Switch_Mitsumi_SIQ-02FVS3; MPN SIQ-02FVS3; LCSC C2925423
TP1: VBUS; TestPoint_Pad_D1.5mm
TP2: 3V3; TestPoint_Pad_D1.5mm
TP3: GND; TestPoint_Pad_D1.5mm
TP4: RF_MODE; TestPoint_Pad_D1.5mm
TP5: LMX_MUX; TestPoint_Pad_D1.5mm
TP6: NRST; TestPoint_Pad_D1.5mm
TP7: SWCLK; TestPoint_Pad_D1.5mm
TP8: SWDIO; TestPoint_Pad_D1.5mm
U1: MCU; QFN-48-1EP_7x7mm_P0.5mm_EP5.6x5.6mm; MPN STM32U535CEU6; LCSC C22454224
U2: Synthesizer; TI_NJK0036A_WQFN-36-1EP_6x6mm_P0.5mm_EP4.6x4.6mm; MPN LMX2571NJKR; LCSC C440388
U3: 3.3 V 600 mA LDO; SOT-23-5; MPN AP2112K-3.3TRG1; LCSC C51118
U4: FM receiver; SiliconLabs_QFN-20-1EP_3x3mm_P0.5mm_EP1.8x1.8mm; MPN SI4705-D60-GM; LCSC C1526114
U5: SPDT RF switch; SOT-363_SC-70-6; MPN PE42421SCAA-Z; LCSC C470893
U6: USB ESD array; SOT-23-6; MPN USBLC6-2SC6; LCSC C7519
U7: Digital step attenuator; QFN-24-1EP_4x4mm_P0.5mm_EP2.75x2.75mm; MPN PE43711B-Z; LCSC C470929
U8: 36-channel LED driver; Lumissil_QFN-44-1EP_5x5mm_P0.4mm_EP2.45x2.45mm; MPN IS31FL3236A-QFLS2-TR; LCSC C246443
Y2: 20 MHz CMOS XO; Oscillator_SMD_SiT_PQFN-4Pin_3.2x2.5mm; MPN OT322520MJBA4SL; LCSC C725987

Connections:
3V3: C2.1, C3.1, C4.1, C5.1, C6.1, C11.1, C12.1, C13.1, C14.1, C15.1, C16.1, C17.1, C18.1, C19.1, C27.1, FB2.1, FB3.1, R16.1, R20.2, R21.2, R30.2, R31.2, R32.2, SW1.1 (Throw_(TX)), SW2.1, SW3.7, SW3.8, SW3.9, SW3.10, SW3.11, SW3.12, TP2.1 (1_1), U1.1 (VBAT), U1.24 (VDD), U1.36 (VDD), U1.48 (VDD), U2.1 (Vcc3p3), U2.9 (Vcc3p3), U2.15 (VccIO), U2.20 (Vcc3p3), U2.27 (Vcc3p3), U2.32 (VcpExt), U2.33 (VccIO), U3.5 (VOUT), U7.2 (VDD), U7.16 (LE), Y2.1 (Tri-state), Y2.4 (VDD)
/ANT: D5.1 (A1), J2.1 (In), U5.5 (RFC)
/ATT_C0_5: R15.1, SW3.6, U7.24 (C0.5)
/ATT_C1: R14.1, SW3.5, U7.23 (C1)
/ATT_C2: R13.1, SW3.4, U7.22 (C2)
/ATT_C4: R12.1, SW3.3, U7.21 (C4)
/ATT_C8: R11.1, SW3.2, U7.20 (C8)
/ATT_C16: R10.1, SW3.1, U7.19 (C16)
/ATT_IN: C26.2, U7.5 (RF1)
/BOOT0: R3.1, SW2.2, U1.44 (PH3)
/CC1: D3.1 (I/O), J1.A5 (CC1), R1.1, U1.18 (PB0)
/CC2: D4.1 (I/O), J1.B5 (CC2), R2.1, U1.19 (PB1)
/CP_LOOP: C24.1, R5.1, U2.25 (CPout)
/DRV_REXT: R28.1, U8.40 (R_EXT)
/ENC_A: R30.1, SW4.1 (A), U1.13 (PA3)
/ENC_B: R31.1, SW4.4 (B), U1.14 (PA4)
/ENC_SW: R32.1, SW4.2 (S), U1.15 (PA5)
/FMI: C35.1, FB1.2, U4.2 (FMI)
/FMI_MATCH: C34.2, FB1.1, L1.1
/FSK_CLK: R6.2, U2.4 (FSK_DV)
/FSK_CLK_MCU: R6.1, U1.29 (PA8)
/FSK_DATA: R8.2, U2.6 (FSK_D1)
/FSK_DATA_MCU: R8.1, U1.31 (PA10)
/FSK_FS: R7.2, U2.7 (FSK_D0)
/FSK_FS_MCU: R7.1, U1.30 (PA9)
/I2C_SCL: R20.1, U1.45 (PB8), U4.7 (SCLK), U8.42 (SCL)
/I2C_SDA: R21.1, U1.43 (PB7), U4.8 (SDIO), U8.41 (SDA)
/LED_B: R27.1, U1.12 (PA2)
/LED_B_K: D1.4 (BK), R27.2
/LED_G: R26.1, U1.11 (PA1)
/LED_G_K: D1.3 (GK), R26.2
/LED_R: R25.1, U1.10 (PA0)
/LED_R_K: D1.1 (RK), R25.2
/LED_SDB: R29.1, U1.2 (PC13), U8.36 (SDB)
/LMX_BYP1: C20.1, U2.2 (Bypass1)
/LMX_BYP2: C21.1, U2.3 (Bypass2)
/LMX_CE: R9.1, U1.6 (PH1), U2.19 (CE)
/LMX_CLK: U1.27 (PB14), U2.11 (CLK)
/LMX_DATA: U1.26 (PB13), U2.12 (DATA)
/LMX_LE: U1.25 (PB12), U2.13 (LE)
/LMX_MUX: TP5.1 (1_1), U1.28 (PB15), U2.10 (MUXout)
/LMX_RF: C26.1, U2.17 (RFoutTx)
/LMX_VREFVCO: C22.1, U2.22 (VrefVCO)
/LMX_VREGVCO: C23.1, U2.21 (VregVCO)
/LOOP_RC: C25.1, R5.2
/NRST: C10.1, TP6.1 (1_1), U1.7 (NRST)
/REF20: R4.1, U2.34 (OSCin), Y2.3 (OUT)
/REF20_MCU: R4.2, U1.5 (PH0)
/RF_CTRL: C31.1, R17.2, U5.4 (CTRL)
/RF_MODE: R17.1, R18.1, SW1.2 (Common), TP4.1 (1_1), U1.17 (PA7)
/RX_FS: R23.1, U4.16 (DFS)
/RX_FS_MCU: C36.1, R23.2, U1.42 (PB6)
/RX_GPO1: C38.1, U4.19 (GPO1)
/RX_GPO2: C37.1, U4.18 (GPO2/INT)
/RX_RCLK: U1.40 (PB4), U4.9 (RCLK)
/RX_RF: C34.1, U5.1 (RF1)
/RX_RST: R19.1, U1.46 (PB9), U4.5 (RSTB)
/RX_SCK: R24.1, U4.17 (GPO3/DCLK)
/RX_SCK_MCU: R24.2, U1.39 (PB3)
/RX_SD: R22.1, U4.15 (DOUT)
/RX_SD_MCU: R22.2, U1.41 (PB5)
/SEG1_A: DS1.7 (A), U8.29 (OUT30)
/SEG1_B: DS1.6 (B), U8.28 (OUT29)
/SEG1_C: DS1.4 (C), U8.14 (OUT16)
/SEG1_D: DS1.2 (D), U8.13 (OUT15)
/SEG1_DP: DS1.5 (DP), U8.15 (OUT17)
/SEG1_E: DS1.1 (E), U8.12 (OUT14)
/SEG1_F: DS1.9 (F), U8.30 (OUT31)
/SEG1_G: DS1.10 (G), U8.31 (OUT32)
/SEG2_A: DS2.7 (A), U8.25 (OUT26)
/SEG2_B: DS2.6 (B), U8.24 (OUT25)
/SEG2_C: DS2.4 (C), U8.19 (OUT20)
/SEG2_D: DS2.2 (D), U8.18 (OUT19)
/SEG2_DP: DS2.5 (DP), U8.20 (OUT21)
/SEG2_E: DS2.1 (E), U8.16 (OUT18)
/SEG2_F: DS2.9 (F), U8.26 (OUT27)
/SEG2_G: DS2.10 (G), U8.27 (OUT28)
/SEG3_A: DS3.7 (A), U8.2 (OUT4)
/SEG3_B: DS3.6 (B), U8.4 (OUT6)
/SEG3_C: DS3.4 (C), U8.23 (OUT24)
/SEG3_D: DS3.2 (D), U8.22 (OUT23)
/SEG3_DP: DS3.5 (DP), U8.11 (OUT13)
/SEG3_E: DS3.1 (E), U8.21 (OUT22)
/SEG3_F: DS3.9 (F), U8.33 (OUT34)
/SEG3_G: DS3.10 (G), U8.32 (OUT33)
/SEG4_A: DS4.7 (A), U8.10 (OUT12)
/SEG4_B: DS4.6 (B), U8.1 (OUT3)
/SEG4_C: DS4.4 (C), U8.5 (OUT7)
/SEG4_D: DS4.2 (D), U8.7 (OUT9)
/SEG4_DP: DS4.5 (DP), U8.3 (OUT5)
/SEG4_E: DS4.1 (E), U8.9 (OUT11)
/SEG4_F: DS4.9 (F), U8.8 (OUT10)
/SEG4_G: DS4.10 (G), U8.6 (OUT8)
/SWCLK: TP7.1 (1_1), U1.37 (PA14)
/SWDIO: TP8.1 (1_1), U1.34 (PA13)
/TX_LPF_MID: C29.1, L2.2, L3.1
/TX_RF: C30.1, L3.2, U5.3 (RF2)
/TX_RF_ATT: C28.1, L2.1, U7.14 (RF2)
/U5_VDD: R16.2, U5.6 (VDD)
/USB_DM: J1.A7 (D-), J1.B7 (D-), U1.32 (PA11), U6.3 (I/O2), U6.4 (I/O2)
/USB_DP: J1.A6 (D+), J1.B6 (D+), U1.33 (PA12), U6.1 (I/O1), U6.6 (I/O1)
/VCAP: C9.1, U1.22 (VCAP)
GND: C1.2, C2.2, C3.2, C4.2, C5.2, C6.2, C7.2, C8.2, C9.2, C10.2, C11.2, C12.2, C13.2, C14.2, C15.2, C16.2, C17.2, C18.2, C19.2, C20.2, C21.2, C22.2, C23.2, C24.2, C25.2, C27.2, C28.2, C29.2, C30.2, C31.2, C32.2, C33.2, C35.2, C36.2, C37.2, C38.2, C42.2, C43.2, C44.2, D3.2 (GND), D4.2 (GND), D5.2 (A2), J1.A1 (GND), J1.A12 (GND), J1.B1 (GND), J1.B12 (GND), J1.SH (SHIELD), J2.2 (Ext), L1.2, R1.2, R2.2, R3.2, R9.2, R10.2, R11.2, R12.2, R13.2, R14.2, R15.2, R18.2, R19.2, R28.2, R29.2, SW1.3 (Throw_(RX)), SW1.4 (Tab), SW4.3 (C), SW4.5 (Frame), SW4.6 (Frame), SW4.7 (Frame), SW4.8 (Frame), SW4.9 (Frame), SW4.10 (Frame), TP3.1 (1_1), U1.8 (VSSA), U1.23 (VSS), U1.35 (VSS), U1.47 (VSS), U1.49 (VSS), U2.5 (FSK_D2), U2.18 (TrCtl), U2.23 (GND), U2.31 (GND), U2.35 (GND), U2.37 (DAP), U3.2 (GND), U4.3 (RFGND), U4.4 (LPI), U4.6 (SENB), U4.12 (GND), U4.13 (ROUT), U4.14 (LOUT), U4.21 (EP), U5.2 (GND), U6.2 (GND), U7.1 (C0.25), U7.3 (P/S), U7.4 (GND), U7.6 (GND), U7.7 (GND), U7.8 (GND), U7.9 (GND), U7.10 (GND), U7.11 (GND), U7.12 (GND), U7.13 (GND), U7.15 (GND), U7.17 (CLK), U7.18 (SI), U7.25 (EP), U8.17 (GND), U8.37 (AD), U8.39 (GND), U8.45 (EP), Y2.2 (GND)
RX_VDD: C32.1, C33.1, FB3.2, U4.10 (VD), U4.11 (VA)
VBUS: C1.1, C42.1, C43.1, C44.1, D1.2 (A), DS1.3 (CA), DS1.8 (CA), DS2.3 (CA), DS2.8 (CA), DS3.3 (CA), DS3.8 (CA), DS4.3 (CA), DS4.8 (CA), J1.A4 (VBUS), J1.A9 (VBUS), J1.B4 (VBUS), J1.B9 (VBUS), TP1.1 (1_1), U3.1 (VIN), U3.3 (EN), U6.5 (VBUS), U8.38 (VCC)
VDDA: C7.1, C8.1, FB2.2, U1.9 (VDDA)

Notes on the sheet:
MOUNTING HOLES: M2, 2.2 mm unplated. Board positions from the top-left corner: H1 (13, 7), H2 (33, 7), H3 (41, 57), H4 (8, 66) mm
LAYOUT NOTES 1. Decoupling: put each bypass capacitor right at the supply pin it serves, with its ground pad straight into the ground fill [BAC p3]. 2. U2 (LMX2571): keep the I2S/FSK clock and every other switching line away from the loop filter (C24, R5, C25) and from OSCin, pin 34 (rule R8) [LMX2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

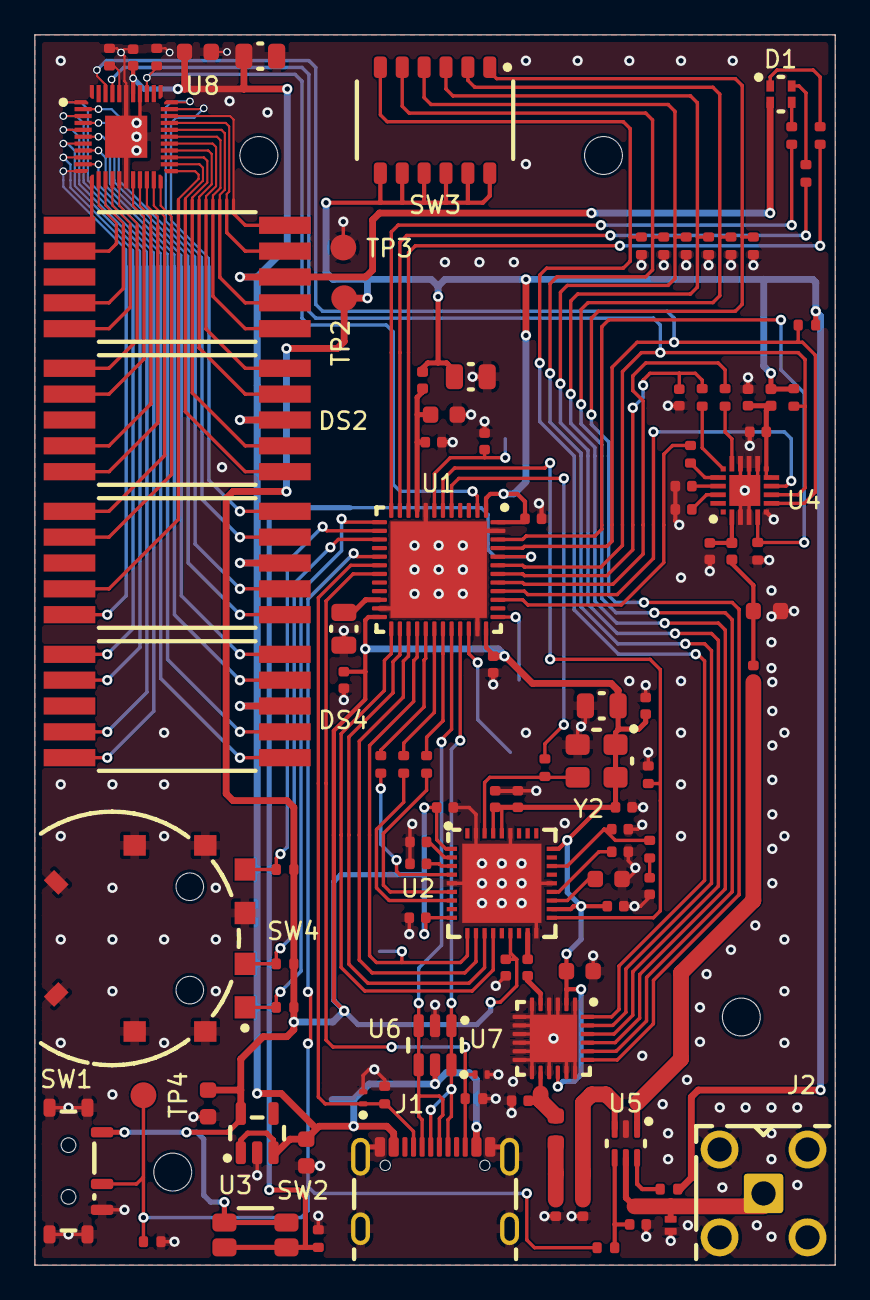
[picture p15: board IphoneFM.kicad_pcb from above]

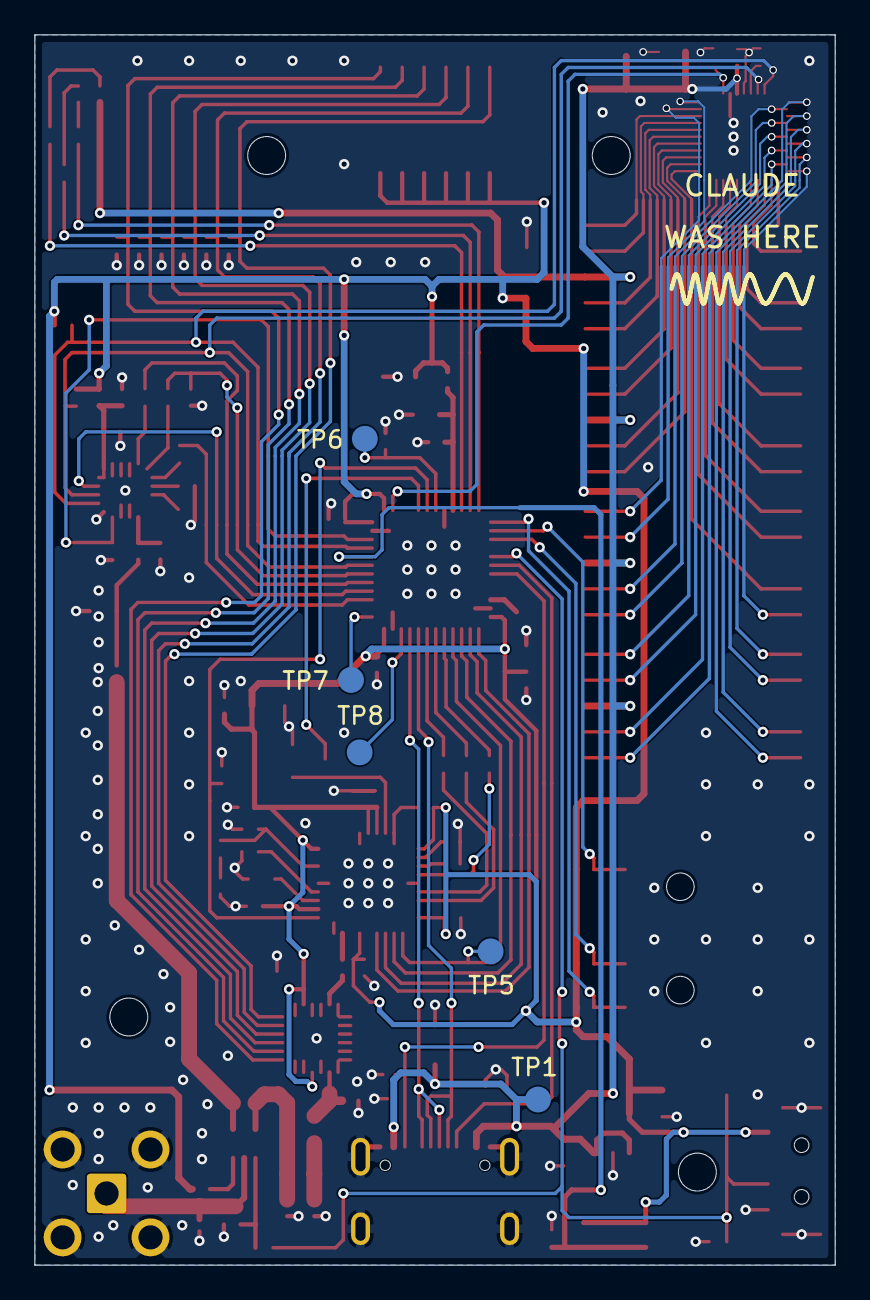
[picture p16: board IphoneFM.kicad_pcb from below]

Board: 2 copper layers, 46.5 x 71.4 mm, 114 parts (5 on the bottom side), 106 nets.
