louisflakes/IphoneFM/tools/pcb_setup.py

"""Phase 3 board setup on kicad/rev-a/IphoneFM.kicad_pcb, from kicad/rev-a/fab-rules.md. Rewrites its own sections on
every run, so it can be re-run after any change to the rules.
- Step 3.1: the layer stack-up, JLC's JLC0216A from their impedance calculator (fab-rules.md, 50 ohm section): 0.030 mm
  copper, 1.43 mm FR-4 core, 0.030 mm copper; core Dk 4.6 and solder mask Dk 3.8, 0.6 mil (0.015 mm) over copper, from
  JLC's impedance stack-up page (jlcpcb.com/impedance, read 2026-10-23). The sum, about 1.52 mm, is inside JLC's
  +-10% on the 1.6 mm board we order. The mask is named "Liquid Ink" (JLC's liquid photoimageable mask): KiCad drops a
  mask's Dk on save unless a material is named, and writes a 0 loss tangent beside it. No surface finish: that is chosen with the order. And the title block, the same
  as the schematic's.
- Step 3.2: the design rules from fab-rules.md's "Our design rules": Board Setup's constraints and defaults in
  IphoneFM.kicad_pro, the 0.10 mm solder-mask web in the board's setup, and the two rules Board Setup has no field
  for (0.25 mm ring on plated holes, 0.3 mm courtyard gap) in IphoneFM.kicad_dru.
- Step 3.4: the 46.45 x 71.40 mm outline on Edge.Cuts at layout.html's envelope coordinates, with the grid and drill
  origins on its top-left corner.
- Step 3.6: keep-outs. Copper 0.5 mm from the edge is the step 3.2 rule (min_copper_edge_clearance). For the magnet ring
  (placement-rules.md M8), two named rule areas, the ring's outer circle and its open centre, and a rule in
  IphoneFM.kicad_dru that flags any plated through-hole pad (a lead that comes out of the bottom) touching the band
  between them. Unplated holes and SMD parts over the ring are allowed.
Close KiCad (or don't save from it) while this runs; reopen the project to see the result.
Usage (from the repository root): python tools/pcb_setup.py"""
import re

PCB = "kicad/rev-a/IphoneFM.kicad_pcb"
SCH = "kicad/rev-a/IphoneFM.kicad_sch"

STACKUP = """\t\t(stackup
\t\t\t(layer "F.SilkS"
\t\t\t\t(type "Top Silk Screen")
\t\t\t)
\t\t\t(layer "F.Paste"
\t\t\t\t(type "Top Solder Paste")
\t\t\t)
\t\t\t(layer "F.Mask"
\t\t\t\t(type "Top Solder Mask")
\t\t\t\t(thickness 0.015)
\t\t\t\t(material "Liquid Ink")
\t\t\t\t(epsilon_r 3.8)
\t\t\t\t(loss_tangent 0)
\t\t\t)
\t\t\t(layer "F.Cu"
\t\t\t\t(type "copper")
\t\t\t\t(thickness 0.03)
\t\t\t)
\t\t\t(layer "dielectric 1"
\t\t\t\t(type "core")
\t\t\t\t(thickness 1.43)
\t\t\t\t(material "FR4")
\t\t\t\t(epsilon_r 4.6)
\t\t\t\t(loss_tangent 0.02)
\t\t\t)
\t\t\t(layer "B.Cu"
\t\t\t\t(type "copper")
\t\t\t\t(thickness 0.03)
\t\t\t)
\t\t\t(layer "B.Mask"
\t\t\t\t(type "Bottom Solder Mask")
\t\t\t\t(thickness 0.015)
\t\t\t\t(material "Liquid Ink")
\t\t\t\t(epsilon_r 3.8)
\t\t\t\t(loss_tangent 0)
\t\t\t)
\t\t\t(layer "B.Paste"
\t\t\t\t(type "Bottom Solder Paste")
\t\t\t)
\t\t\t(layer "B.SilkS"
\t\t\t\t(type "Bottom Silk Screen")
\t\t\t)
\t\t\t(copper_finish "None")
\t\t\t(dielectric_constraints no)
\t\t)
"""


PRO = "kicad/rev-a/IphoneFM.kicad_pro"
DRU = "kicad/rev-a/IphoneFM.kicad_dru"

# Step 3.2: fab-rules.md, "Our design rules (step 0.5)"
RULES = {
    "min_clearance": 0.20,             # copper to copper
    "min_track_width": 0.20,           # signals
    "min_via_diameter": 0.60,          # via pad
    "min_through_hole_diameter": 0.30, # smallest drill (vias)
    "min_via_annular_width": 0.15,     # 0.60 pad on a 0.30 drill; plated pads get 0.25 in IphoneFM.kicad_dru
    "min_hole_to_hole": 0.50,
    "min_hole_clearance": 0.30,        # hole to copper
    "min_copper_edge_clearance": 0.50,
    "min_silk_clearance": 0.20,        # silkscreen to pad
    "min_text_height": 1.0,
    "min_text_thickness": 0.15,
    "solder_mask_to_copper_clearance": 0.0,
}
DEFAULTS = {"silk_line_width": 0.25, "silk_text_size_h": 1.0, "silk_text_size_v": 1.0, "silk_text_thickness": 0.15}
CUSTOM = """(version 1)
# Step 3.2 rules KiCad's Board Setup has no field for (kicad/rev-a/fab-rules.md)
(rule "Plated hole annular ring 0.25 mm"
\t(condition "A.Type == 'Pad' && A.Pad_Type == 'Through-hole'")
\t(constraint annular_width (min 0.25mm)))
(rule "Courtyard gap 0.3 mm"
\t(constraint courtyard_clearance (min 0.3mm)))
# Step 4.3 (the user's choice): the Clock class's wider gap is for its tracks. Pins inside a part keep the normal 0.2 mm
# (U1, U2 and U4's clock pins are 0.25 mm apart); a clock track keeps 0.4 mm from other nets' tracks and vias.
(rule "Clock nets: 0.2 mm, as Default"
\t(condition "A.NetClass == 'Clock'")
\t(constraint clearance (min 0.2mm)))
# Phase 5: not within the courtyards of the parts the clock lines start and end at, where escapes from 0.5 mm-pitch pins
# run 0.3 mm apart for their first millimetre
(rule "Clock tracks 0.4 mm from other tracks and vias"
\t(condition "A.NetClass == 'Clock' && A.Type == 'Track' && (B.Type == 'Track' || B.Type == 'Via') && A.Net != B.Net && !A.intersectsCourtyard('U1') && !A.intersectsCourtyard('U2') && !A.intersectsCourtyard('U4') && !A.intersectsCourtyard('Y2') && !A.intersectsCourtyard('R4') && !A.intersectsCourtyard('R6') && !A.intersectsCourtyard('R24')")
\t(constraint clearance (min 0.4mm)))
# Step 3.6: no through-hole leads over the MagSafe magnet ring (placement-rules.md M8)
(rule "No through-hole leads over the MagSafe ring"
\t(condition "A.Type == 'Pad' && A.Pad_Type == 'Through-hole' && A.intersectsArea('MagSafe ring') && !A.enclosedByArea('MagSafe ring opening')")
\t(constraint disallow pad))
"""


def design_rules():
    import json
    pro = json.load(open(PRO, encoding="utf-8"))
    ds = pro["board"]["design_settings"]
    ds["rules"].update(RULES)
    ds["defaults"].update(DEFAULTS)
    ds["track_widths"] = [0.0, 0.20, 0.40, 0.92]  # first entry is KiCad's "use net class" slot
    ds["via_dimensions"] = [{"diameter": 0.0, "drill": 0.0}, {"diameter": 0.60, "drill": 0.30}]
    for c in pro["net_settings"]["classes"]:  # step 4.3: Clock's 0.4 mm lives in IphoneFM.kicad_dru, for its tracks only
        if c["name"] == "Clock":
            c["clearance"] = 0.2
    open(PRO, "w", encoding="utf-8", newline="\n").write(json.dumps(pro, indent=2) + "\n")
    open(DRU, "w", encoding="utf-8", newline="\n").write(CUSTOM)


# Step 3.4: the board outline is layout.html's envelope, placed at the same coordinates (phone-back mm, x from the camera-side
# long edge, y down from the top edge), so a position on the board reads the same as on the sketch. The grid and drill
# origins sit on the board's top-left corner, so positions relative to them are the board-corner offsets used for the
# mounting holes (step 3.5).
ENVELOPE = (12.70, 59.56, 59.15, 130.96)  # layout.html ENVELOPE: 46.45 x 71.40 mm, square corners
OUTLINE_TAG = "IphoneFM board outline (layout.html ENVELOPE)"


def outline(text):
    x0, y0, x1, y1 = ENVELOPE
    text = re.sub(r'\t\(gr_rect\n(?:(?!\n\t\)\n).)*?\(layer "Edge\.Cuts"\).*?\n\t\)\n', "", text, flags=re.S)
    rect = (f'\t(gr_rect\n\t\t(start {x0:g} {y0:g})\n\t\t(end {x1:g} {y1:g})\n\t\t(stroke\n\t\t\t(width 0.05)\n\t\t\t(type solid)\n'
            f'\t\t)\n\t\t(fill no)\n\t\t(layer "Edge.Cuts")\n\t)\n')
    text = text.replace("\t(embedded_fonts no)\n)", rect + "\t(embedded_fonts no)\n)", 1)
    for key in ("aux_axis_origin", "grid_origin"):
        text = re.sub(rf"\t\t\({key} [-\d.]+ [-\d.]+\)\n", "", text)
        text = text.replace("\t\t(pcbplotparams\n", f"\t\t({key} {x0:g} {y0:g})\n\t\t(pcbplotparams\n", 1)
    return text


# Step 3.6: the MagSafe magnet ring under the board (local/apple/phone-outline.js): centre and diameters in phone-back mm
RING_C, RING_OD, RING_ID = (35.92, 77.74), 54.10, 46.00


def ring_areas(text):
    """Two rule areas on both copper layers that restrict nothing themselves; IphoneFM.kicad_dru's ring rule uses them."""
    import math
    import uuid
    text = re.sub(r'\t\(zone\n(?:(?!\n\t\)\n).)*?\(name "MagSafe ring[^"]*"\).*?\n\t\)\n', "", text, flags=re.S)
    out = ""
    for name, d in (("MagSafe ring", RING_OD), ("MagSafe ring opening", RING_ID)):
        pts = " ".join(f"(xy {RING_C[0] + d / 2 * math.cos(math.radians(a)):.4f} {RING_C[1] + d / 2 * math.sin(math.radians(a)):.4f})"
                       for a in range(0, 360, 5))
        out += (f'\t(zone\n\t\t(net 0)\n\t\t(net_name "")\n\t\t(locked yes)\n\t\t(layers "F.Cu" "B.Cu")\n'
                f'\t\t(uuid "{uuid.uuid5(uuid.NAMESPACE_URL, "IphoneFM/" + name)}")\n\t\t(name "{name}")\n\t\t(hatch edge 0.5)\n'
                f'\t\t(connect_pads\n\t\t\t(clearance 0)\n\t\t)\n\t\t(min_thickness 0.25)\n'
                f'\t\t(keepout\n\t\t\t(tracks allowed)\n\t\t\t(vias allowed)\n\t\t\t(pads allowed)\n\t\t\t(copperpour allowed)\n'
                f'\t\t\t(footprints allowed)\n\t\t)\n\t\t(placement\n\t\t\t(enabled no)\n\t\t\t(sheetname "")\n\t\t)\n'
                f'\t\t(fill\n\t\t\t(thermal_gap 0.5)\n\t\t\t(thermal_bridge_width 0.5)\n\t\t)\n'
                f'\t\t(polygon\n\t\t\t(pts\n\t\t\t\t{pts}\n\t\t\t)\n\t\t)\n\t)\n')
    return text.replace("\t(embedded_fonts no)\n)", out + "\t(embedded_fonts no)\n)", 1)


def main():
    design_rules()
    text = open(PCB, encoding="utf-8").read()
    # mask: opened 1:1 (KiCad adds nothing), 0.10 mm minimum web; webs inside a footprint may be left out, as on U4 (step 2.8)
    text = re.sub(r"\t\t\(solder_mask_min_width [\d.]+\)\n", "", text)
    text = text.replace("\t\t(pad_to_mask_clearance 0)\n", "\t\t(pad_to_mask_clearance 0)\n\t\t(solder_mask_min_width 0.1)\n", 1)
    text = text.replace("(allow_soldermask_bridges_in_footprints no)", "(allow_soldermask_bridges_in_footprints yes)")
    # step 3.1: stack-up, first inside (setup)
    text = re.sub(r"\t\t\(stackup\n.*?\n\t\t\)\n", "", text, flags=re.S)
    text = text.replace("\t(setup\n", "\t(setup\n" + STACKUP, 1)
    total = sum(float(t) for t in re.findall(r"\(thickness ([\d.]+)\)", STACKUP))  # KiCad's board thickness is the stack's sum
    text = re.sub(r"(\t\(general\n\t\t\(thickness )[\d.]+\)", lambda m: f"{m.group(1)}{total:g})", text, count=1)
    # title block, copied from the schematic
    tb = re.search(r"\t\(title_block\n.*?\n\t\)\n", open(SCH, encoding="utf-8").read(), re.S).group(0)
    text = re.sub(r"\t\(title_block\n.*?\n\t\)\n", "", text, flags=re.S)
    text = re.sub(r'(\t\(paper "[^"]*"\)\n)', lambda m: m.group(1) + tb, text, count=1)
    text = outline(text)
    text = ring_areas(text)
    open(PCB, "w", encoding="utf-8", newline="\n").write(text)
    print(PCB)


if __name__ == "__main__":
    main()
