louisflakes/IphoneFM/(commit log)

2026-10-19 Formalize design: Plan C active, Plans A and B archived
    - design/plan-c/wiring.html: active wiring diagram and netlist (STM32U535)
    - design/archive/: Plans A (STM32F072) and B (SAMD51), no longer developed
    - docs/decisions.md: design decisions with datasheet sources
    - tools/: DigiKey/Mouser stock scripts and diagram screenshot script
    - README: project summary, status, parts, open items, layout
    Claude-Session: https://claude.ai/code/session_01Fw5wrQZB9faNWYLu8a8ps9
2026-10-19 Plan C: crystals and LV2285 chain parts
    - U1 32.768 kHz crystal (ABS07, CL 7 pF) with 5.6 pF load caps
    - LV2285: fix pin 7 (drives SVC710 varactor for FM modulation, not a test point)
    - LV2285: drive 76 kHz oscillator from U1 TIM16 (PB8); no 76 kHz crystal is buyable
    - Part numbers for every LV2285 local part (design/plan-c/bom.md)
    - Decision log entries; dk_pn.py and jlc.py lookup tools
    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
2026-10-19 Plan C: Si4704 chain parts; I2C pull-ups to 6.8k
    - C1 22 nF between DBYP and VA (was drawn to GND), C4 100 nF, C2 1 nF
    - Digital audio series resistors R1-R3 and C9 from the SSOP reference design
    - I2C pull-ups 3.3k -> 6.8k: Si4704 VOL is only specified at 500 uA sink
    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
2026-10-19 Plan C: U3 regulator parts; accept VCAP MLCC
    - AP2112K-3.3 CIN/COUT 1 uF X7R per its application circuit
    - Start-up and rail capacitance checked against foldback current limit
    - VCAP: voltage and tolerance confirmed from Murata sheet; ESR accepted for X7R MLCC
    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
2026-10-19 Plan C: J1 USB-C chain; flag bridge adapter CC wiring
    - Rd 5.1k 1% on CC1/CC2 against Type-C R2.5 Table 4-28; SBU open per p150
    - CC ADC settings and voltage bands for firmware (Table 4-36, DS14217 Table 104)
    - Rd/Rd prevents attach (p186): fit CC2 Rd only after checking the Adafruit 6367
    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
2026-10-19 README: renumber open items, update chain progress
    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
2026-10-19 Plan C: U5 RF switch chain; CC2 Rd fitted
    - PE42421 VDD and CTRL get 1k series resistors, as on the pSemi eval board
    - RF_MODE 100k pull-down checked against CTRL thresholds and PB0 leakage
    - Bridge is a standard C-to-C cable (one CC wire), so both Rd stay fitted
    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
2026-10-19 Plan C: SW1 slider chain checks
    - Rating, contact resistance, non-shorting confirmed against the Same Sky datasheet
    - Frame tabs to GND; pole B unconnected; -20..70 C range and 1.6 mm PCB noted
    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
2026-10-19 Note 1.6 mm board thickness from SW1 drawing
    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
2026-10-19 Plan C: buttons and LED chains; all chains have part numbers
    - TS02: LCR drawing confirmed; currents inside its 0.01-50 mA rating
    - LED: abs max, derating (Fig 10) to 70 C, resistor power, open-drain to avoid reverse bias
    - 390 ohm -> Panasonic ERJ-2RKF3900X (Yageo out of stock)
    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
2026-10-19 Plan C: ESD protection and TX low-pass filter
    - USBLC6-2SC6 (D+/D-/VBUS), TPD1E05U06 x2 (CC), TPD1E0B04 bidirectional (antenna)
    - 5th-order Chebyshev LPF after the TX DC block; computed response recorded
    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
2026-10-19 Add KiCad MCP server config and KiCad 10 setup script
    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
2026-10-20 Plan C: passive package and land-pattern table with sources
    Add design/plan-c/packages.md: body size and recommended reflow land
    pattern for every passive and Y2, each read from the maker's document.
    Add the ten source PDFs to docs/datasheets/plan-c and index them.
    Fix wiring.html: VCAP note matches bom.md; SW2/SW3 cite TS02 p3.
2026-10-20 Add cited PCB design workflow and rules doc; ignore Books/
    docs/pcb-design-workflow.md: schematic capture through fab/assembly
    outputs, each rule cited to the reference books, with 8 conflicts
    between sources and the remaining gaps listed. Books/ holds
    copyrighted references and stays local.
2026-10-20 Add RF layout app notes (AN383, AN4169, ADI) to workflow; FMI front end
    - Save Skyworks AN383 and ST AN4169 to docs/datasheets/plan-c with index rows
    - Workflow doc: RF rules cited to AN383, AN4169 and ADI; C1 settled for RF;
    new conflict C9 (AN4169 favours 3-4 layers; 2-layer 1.6 mm kept, lines
    electrically short at 108 MHz)
    - reference-designs: two open 4-layer KiCad FM layouts and the usbfm FMI chain
    - README open item 7: 50 ohm antenna needs only the 1 nF into FMI
2026-10-20 Plan C: U4 emissions filter and pin fixes, test pads, layout sketch
    - U4: LPI to GND, GPO1/GPO2 float with 33 pF, AN383 FMI filter (FB1, C14, C5 pad)
    - Test pads TP1-TP5; phone cable is now a short flexible USB-C cable
    - layout.html: board envelope and a true-size tray of the 13 major parts,
    cited to their datasheets; the phone outline loads from git-ignored local/
    - Workflow doc: FMI matching line matches README item 7
2026-10-20 Plan C: placement concepts, side-push buttons, SMA J2, FMI match
    - layout.html: true-size parts tray, layouts A and C (controls on one edge,
    J2 low on the other), automatic checks incl. routing room (M11), and the
    ANT500 drawn on J2 collapsed and extended
    - placement-rules.md: placement checklist with sources
    - SW2/SW3 -> Panasonic EVQ-P7J01P side-push SMD buttons (datasheet added)
    - J2 -> TE Linx CONSMA002-G SMA jack for the GSG ANT500 antenna (drawing
    added; same footprint); decisions log keeps the 15.203 note
    - U4 FMI: L1 150 nH shunt match (AN383 whip circuit), centred for the
    collapsed antenna; C5 pad and 0-ohm fallbacks removed: every passive is
    populated with a best-guess va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
2026-10-21 Analog FM rendition: block plan, sourcing check, verified part picks
    - design/analog-fm/sourcing.md: every key part for the USB-C -> MCU DAC ->
    discrete FM TX board, checked against its saved datasheet, with JLC stock
    and a JLC assembly route (library stock or global sourcing); rules for
    candidates vs checked parts, deep stock and package size
    - Frequency hold: ADF4002 PLL with a 20 MHz reference; MMBTH10 oscillator
    and buffer, 1SV281 varactor; Si4705-D60-GM replaces the reel-only Si4704
    - Swaps for JLC: HRO TYPE-C-31-M-12, BWSMA-KWE-Z001 SMA, MSK12C02 slider,
    XL-1615RGBC-RF LED, RClamp0521P antenna ESD (0402), Murata LQW18AN inductors
    - Controls: three Alps RK10J thumbwheels for t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
2026-10-21 Analog FM BOM: chain 1 (USB-C) and chain 2 (3.3 V regulator)
    - design/analog-fm/bom.md: chain order for the passives pass; J1 wiring
    checked against three published designs that use the exact HRO
    TYPE-C-31-M-12 (LinHT, echoplayer, Beepy): no gaps
    - Regulator and MCU bulk caps move to deep-stock Samsung parts with the same
    spec (CL10B105KO8NNNC 1 uF X7R 0603, CL21A106KOQNNNE 10 uF X5R 0805)
    - Samsung MLCC catalog saved for the part-number decode
2026-10-21 Analog FM BOM: chain 3 (MCU support) and chain 4 (20 MHz reference)
    - VDDA fed through a 600 ohm ferrite (BLM15AG601SN1D), closing
    reference-check gap U1-1
    - U1 clocked from the 20 MHz oscillator in HSE bypass (DS14217 p184-185,
    UM3062 p27); USB stays on HSI48 + CRS
    - 32.768 kHz crystal removed: U4 RCLK now 20 MHz from U1 MCO (PA8), divided
    by 610 in the Si4705 (AN332 p37-38); +/-20 ppm vs -92 ppm before
    - Y2: OE tied high, 100 nF + 10 uF, 33 ohm to PH0, 10 nF AC coupling to
    ADF4002 REFIN (datasheet Fig. 10/21, HELIOS reference board)
    - 100 nF on the board standardised on Samsung CL05B104KO5NNNC (JLC basic)
2026-10-21 Analog FM BOM: chain 5 (oscillator, varicap, buffer, lock gate)
    - Common-base Colpitts on MMBTH10 following the pira.cz 5 W PLL FM
    transmitter (values scaled to 3.3 V); tune and audio summed onto one
    varicap as in pira, Gamma Electronics and Broadcast Warehouse designs
    - Varicap 1SV281 -> 1SV322 (ratio >= 4.0): 120 nH tank spans ~79-115 MHz
    worst case over 1-4 V; 1SV281 cannot cover 88-108 on guaranteed values.
    1SV322 is NRND; global sourcing from DigiKey (6,000)
    - PLL sample 220 ohm + 15 pF from the emitter; buffer with collector-
    feedback bias, 1 nF DC block to the PE43711 (0 VDC RF pins); MMBT3904
    lock gate pulled on at power-up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
2026-10-21 Analog FM BOM: chain 6 finding - loop filter needs coarse/fine tuning
    The ADF4002's minimum charge-pump current (0.294 mA) against a ~13 MHz/V LC
    oscillator needs ~0.1-1.5 mF for a sub-audio loop. Recorded options; a
    DAC-ch2 coarse path plus a divided PLL fine path brings it to ~1 uF / 13 uF.
2026-10-21 Analog FM: modulation/carrier-hold strategy brief (5 options)
    Flat 10 Hz-25 kHz rules out an analog charge-pump loop with practical
    parts. Compared software PLL (ADF4002 as divider), two-point modulation,
    direct digital FM through a wide-loop LMX2571 (FSK I2S), and lock-and-hold.
    LMX2571 datasheet and TI SNAA309 saved.
2026-10-21 Modulation brief: LMX2571 internal-VCO (D2) deep dive
    Features mapped to the design (auto-mute until lock, 20 dB output power
    control, integrated LDOs and loop poles, MULT, readback), frequency plan
    (/56 and /48), deviation headroom for all 100 US channels with fPD 40/100
    MHz, first-pass 250-400 kHz loop filter (~100 pF / 1.4 nF / 1.1-1.7 k),
    ~912 kSa/s stream, and the board changes.
2026-10-21 Analog FM: adopt D2 (LMX2571 internal VCO); BOM chain 5 for the LMX2571
    - sourcing.md: LMX2571NJKR in, ADF4002 / MMBTH10 / 1SV322 / lock gate out
    (kept struck through)
    - bom.md chain 5: every LMX2571 pin per SNAS654A (p3, Fig. 62, p53-54);
    loop filter 100 pF / 1.1 k / 1.5 nF gives 300-405 kHz at 61-62 deg PM
    over 40-75 MHz/V and both reference settings; 33 ohm on the I2S lines;
    CE pull-down; VregVCO 2.2 uF
    - Chain 4: Y2 drives OSCin directly (Table 37); chain 3 notes SAI-A / SPI2
    - Chain list renumbered; DAC audio filter chain dropped
2026-10-21 Analog FM BOM: chain 6 (PE43711 + DIP) and chain 7 (FL1, RF switch, SMA, ESD)
    - PE43711 direct parallel: P/S low, LE high, serial pins and C0.25 to GND,
    10k pull-downs, VDD 1 uF (as bgelb/gpsrx); power range ~+1.5 to -51 dBm
    - FL1 caps moved to deep-stock Samsung 33 pF / Yageo 56 pF C0G; Murata 100 nH
    - DC block after FL1 dropped (both ends 0 VDC); 1 nF on U5 CTRL added
    (reference-check gap); harmonic estimate after FL1 <= -53 dBc
2026-10-21 Analog FM BOM: chains 8-10 (Si4705 QFN, controls, budget); all chains done
    - Si4705 QFN per datasheet p16/Table 12: VA/VD ferrite, ROUT/LOUT to GND
    (reference-check gaps 1 and 3 closed); RCLK now 32,787 Hz from a U1
    timer instead of 20 MHz MCO, keeping the 100.0 MHz harmonic away
    - Controls: RK10J wipers to ADC with 100 nF; LED resistors re-checked for
    the XINGLIGHT part; 390 ohm moved to deep-stock Yageo
    - Budget: ~96 mA TX / ~62 mA RX on 3V3, ~35 mA before enumeration,
    ~1.6-1.8 ms rail ramp; test pads TP1-TP5
2026-10-21 Analog FM: wiring diagram and netlist (D2); U1 pin map
    design/analog-fm/wiring.html recreates the Plan C wiring page for the
    LMX2571 design: every chip, net and local part, with datasheet sources.
    bom.md: U1 pin map checked against DS14217 Tables 26-28 and the ROM
    bootloader pins (AN2606 Table 165). LMX2571 pin 15 is a second VccIO
    pin and was missing; it now goes to 3V3 with its own 100 nF. Stale
    MCO and ADF4002 notes in chains 2 and 4 corrected.
2026-10-21 Analog FM: true-size parts tray, placement rules, layouts 1 and 2
    design/analog-fm/layout.html models every new part from its drawing
    (LMX2571, PE43711, Si4705 QFN, HRO USB-C, BAT SMA, MSK12C02, TDP DIP,
    RK10J wheels, XL-1615 LED, 20 MHz XO) on the unchanged envelope, with
    two placements: wheels down the side, or across the top. Antenna
    placement kept from Plan C. placement-rules.md carries over the Plan C
    rules and feedback. sourcing.md: J2 is 9.5 mm tall, not 6.
2026-10-21 Analog FM layout 1 revised: wheels out and lower, DIP on the top edge, LED top right
2026-10-21 Analog FM: designator for every part (netlist.json) and tools/netcheck.py
    99 parts, 45 part numbers, each with designator, part number, JLC code,
    package and the pin it sits next to. Passives numbered by chain; the
    datasheet's own names (LMX2571 loop filter, Si4705 C1/C2/R1-R3, AN383
    C14) are kept as ds_name, which ends the C1/R2/C2 clash. bom.md chains
    open with a generated designator line that netcheck.py keeps in sync;
    the wiring page shows board designators on every passive and now has
    the BOM's RC0402FR-07390RL for the LED.
2026-10-21 Analog FM: every pin mapped to a net in netlist.json; pin-coverage checks
    384 pins across 102 parts and 72 described nets. netcheck.py now checks
    pin coverage against each part's datasheet pin count, nets that join
    only one part, shorted passives, supply/ground/NC pins, that each
    local_to part shares a net with its pin, and 147 pins against the
    wiring page. Found and fixed: the SWD pads (TP6-TP8) were on the wiring
    page but missing from the parts list and BOM.
2026-10-21 tools/kicadcheck.py: check KiCad exports against netlist.json and layout 1
    Reads KiCad's schematic netlist, BOM and board file. Compares which
    pins are joined (opens, shorts, missing pins, NC pins), JLC codes, part
    numbers, passive sizes, sides, outline, sketch positions and each local
    part's distance to its pin. kicadcheck_test.py proves it: synthetic
    files must pass, nine deliberate faults must each fail, and KiCad's
    StickHub demo netlist and board must agree. Pad positions match pcbnew
    exactly on all 266 demo pads. verification.md explains the whole chain.
2026-10-21 Placement rule R8: keep the I2S clock off the LMX2571 loop filter and OSCin (TI p55)
2026-10-22 Rev A: rename analog-fm to design/rev-a, archive Plan C, add KiCad build procedure
    design/analog-fm -> design/rev-a; design/plan-c -> design/archive/plan-c.
    Layout 1 is now the Rev A placement (layout 2 dropped; it stays in
    history). Pages retitled IphoneFM Rev A Wiring / Layout. README rewritten
    for Rev A. kicad/rev-a/ holds the KiCad project. kicad-build-procedure.md
    breaks the book-cited workflow into single reviewed steps. Every link,
    script path and check updated; netcheck and kicadcheck_test pass.
2026-10-22 Rev A KiCad project created (steps 0.1-0.2): IphoneFM, title block set
2026-10-22 Step 0.3: JLC 2-layer PCB capabilities recorded in fab-rules.md; phase names match the original order
2026-10-22 Step 0.4: JLC assembly rules in fab-rules.md; rails on top and bottom edges only
2026-10-22 Steps 0.6-0.7: 50 ohm line 0.92 mm / 0.20 mm gap (JLC calculator, JLC0216A); fab-rules.md reviewed. Phase 0 complete
2026-10-22 Step 1.4: U1 STM32U535CEUx placed; all 49 pins match netlist.json
2026-10-22 Step 1.5: U2 LMX2571 placed from a project symbol built from SNAS654A p3-4 (tools/kicad_symbol.py)
2026-10-22 Step 1.6: U3 AP2112K-3.3 placed (KiCad library symbol, 5/5 pins match)
2026-10-22 Step 1.9: U6 USBLC6-2SC6 placed (KiCad library symbol, 6/6 pins match)
2026-10-22 Step 1.12: J1 USB-C placed (KiCad USB_C_Receptacle_USB2.0_16P)
2026-10-22 Step 1.13: J2 SMA placed (KiCad Conn_Coaxial); netlist.json J2 follows the 2-pin coaxial convention
2026-10-22 Step 1.15: RV1-RV3 placed from a project RK10J11R0A0H symbol (7 pins incl. dummy and mounting lands)
2026-10-22 Step 1.16: D1 (LED_RAGB), D3-D4 (TPD1E05U06DPY), D5 (D_TVS) placed
2026-10-22 Step 1.17: all 74 passives placed beside their pins (tools/sch_place.py)
    Also fixes the symbol-replace bug in kicad_symbol.py that left stale copies of
    OT322520MJBA4SL and RK10J11R0A0H in the library; the sheet now carries the
    rebuilt wheel symbol (lands on the left) and matches the library.
2026-10-22 Step 1.18 ticked; step 1.19: power symbols on every VBUS, 3V3, VDDA, RX_VDD and GND pin (tools/sch_power.py)
    Passives are turned so ground sits at the bottom and supplies on top, and the
    placer now leaves room for the power symbols.
2026-10-22 Step 1.19 ticked; step 1.20: chain 1 wired (J1, R1, R2, D3, D4, U6) with tools/sch_wire.py and sch_layout.py
2026-10-22 Step 1.21: chain 2 wired (U3 with C1 on VBUS in, C2 on 3V3 out; one power symbol per rail there)
2026-10-22 Step 1.21 ticked; step 1.22: chain 3 wired (U1 3V3 bus with C3-C6, FB2 to VDDA with C7-C8, VCAP, NRST, BOOT0)
2026-10-22 Step 1.22: R6-R8 wired to U1 (series passives placed at a pin are wired with that pin's chain)
2026-10-22 Step 1.22: U1's PA2-PA5 shunt caps wired as a staggered ladder to one ground bar; R6-R8 fixed in place
    C36, C39-C41 use KiCad's compact Device:C_Small symbol so the stacked plates stay
    apart. The router now avoids crossings much more strongly and draws wired rails last.
2026-10-22 Record how to wire around a dense chip (workflow doc section 1, build procedure)
2026-10-22 Step 1.22 ticked; step 1.23: chain 4 wired (Y2 on a 3V3 line with C11, C12; R4 off OUT)
2026-10-22 Step 1.23 ticked; step 1.24: chain 5 wired (U2 supply bus and caps, loop filter, bypass ladder, C26 to U7 RF1, R9)
    The router now wires each net within a zone of the sheet and leaves links between
    zones to the step 1.30 labels. U7 moves right to make room.
2026-10-22 Step 1.24 ticked; step 1.25: chain 6 wired (U7 control lines in a ribbon past R10-R15 into SW3; C27 on VDD)
    Tools: symbols can be mirrored; nets can follow a given path (checked to reach every
    pin and touch nothing else); text can sit centred under a part. The ribbon pattern
    is added to the workflow doc.
2026-10-22 Step 1.25 ticked; step 1.26: chain 7 wired (FL1 on one line from U7 RF2 into U5, U5 RFC to J2 with D5, R16, R17/C31, SW1 with R18)
2026-10-22 Step 1.26 ticked; step 1.27: chain 8 wired (U4 I2C pull-ups, RSTB and I2S ribbon to R19, R22-R24, GPO caps, RX_VDD line, FMI to the front end)
    U4's project symbol regroups its left-side pins (I2C, reset, clock, I2S, GPO) so each
    group can be drawn without crossings; pin numbers and connections are unchanged.
2026-10-22 Step 1.27 ticked; step 1.28: chain 9 wired (LED resistors R25-R27 into D1; wheels side by side; text tidied)
2026-10-22 Step 1.28 ticked; step 1.29: test pads TP1-TP8 placed and wired (tools/sch_testpads.py)
    Signal pads sit on the end of the line they test; power pads in the controls zone.
    R7/R8 step down further right, leaving U1 PA11-PA15 clear.
2026-10-22 Step 1.29 ticked; step 1.30: every net labelled with its netlist.json name (tools/sch_labels.py)
    100 labels name all 72 nets and join the groups that run between zones; kicadcheck
    --net now passes with no opens or shorts. Test pads are part of the checked reference.
    A few parts moved to give short runs room for their names.
2026-10-22 Step 1.30 ticked; step 1.31: PWR_FLAG on VBUS, GND, VDDA, RX_VDD and U5_VDD (tools/sch_flags.py)
2026-10-22 Step 1.32 ticked; step 1.33: net classes Power, RF and Clock assigned by net name (fab-rules.md values)
2026-10-22 Step 1.33 ticked; step 1.34: layout notes on the sheet (tools/sch_notes.py)
    AN383 p17 lists the GPO shunt caps with the FMI shunts as pads that take no heat
    relief; step 6.3 and the workflow doc now name them too.
2026-10-22 Step 1.35: ERC at zero; the two deliberate U4 LOUT/ROUT errors reviewed with the user and recorded as exclusions
    Every pin now carries a fixed ID (tools/sch_pinids.py) so the exclusions survive a reload.
    The review is written up in verification.md and under step 1.35.
2026-10-22 Step 1.35 ticked; step 1.36 run: kicadcheck --net passes all 11 checks
2026-10-22 Step 1.36 ticked; step 1.37 run: kicadcheck --bom passes all 6 checks
2026-10-22 Step 1.38 ticked: Phase 1 (schematic) signed off by the user
2026-10-22 Step 2.1: footprint source chosen for every part (kicad/rev-a/footprints.md)
2026-10-22 footprints.md: 33 capacitors in 0402
2026-10-22 Step 2.2 (J1): footprint updated to HRO's 2020 recommended layout in a project library
    KiCad's HRO TYPE-C-31-M-12 footprint follows HRO's 2015 drawing (archived copy kept);
    tools/fp_j1_hro2020.py copies it and sets the pads and holes to the 2020 drawing.
2026-10-23 Step 2.2 (U1): KiCad's IPC footprint passes; footprint-checking rule recorded
2026-10-23 Step 2.2 (U2): project footprint built to TI's NJK0036A land pattern
2026-10-23 Step 2.2 (U2): footprint approved by the user
2026-10-23 Step 2.2 (U3): KiCad's SOT-23-5 passes against Diodes' SOT25 pad layout
2026-10-23 Step 2.2 (U3): footprint approved by the user
2026-10-23 Step 2.2 (U4): KiCad's SiliconLabs QFN-20 kept, the user's decision
2026-10-23 Step 2.2 (U5): KiCad's SOT-363 checked against pSemi's land pattern
2026-10-23 Step 2.2 (U5): footprint approved by the user
2026-10-23 Step 2.2 (U6): ST's current USBLC6-2 datasheet (DS4260 Rev 7) replaces the 2005 mirror copy; KiCad's SOT-23-6 checked
2026-10-23 Step 2.2 (U6): footprint approved by the user
2026-10-23 Step 2.2 (U7): KiCad's QFN-24 4x4 EP2.75 chosen to match pSemi's land pattern
2026-10-23 Step 2.2 (U7): footprint approved by the user
2026-10-23 Step 2.2 (Y2): KiCad's SiTime 3.2x2.5 oscillator footprint is the closest to YXC's pattern
2026-10-23 Step 2.2 (Y2): footprint approved by the user
2026-10-23 Step 2.2 (D1): project footprint built to Xinglight's XL-1615RGBC-RF soldering pattern
2026-10-23 Step 2.2 (D1): footprint approved by the user
2026-10-23 Step 2.2 (D3, D4): KiCad's Texas DPY0002A matches TI's board layout
2026-10-23 Step 2.2 (D3, D4): footprint approved by the user
2026-10-23 Step 2.2 (D5): Semtech's RClamp0521PA Rev 4.0 replaces the 2010 LCSC copy; KiCad's SOD-882 checked
2026-10-23 Step 2.2 (D5): footprint approved by the user
2026-10-23 Step 2.2 (J2): KiCad's BWSMA-KWE-Z001 matches BAT Wireless's PCB layout
2026-10-23 Step 2.2 (J2): footprint approved by the user
2026-10-23 Step 2.2 (SW1): KiCad's MSK12C02 matches Shou Han's mounting drawing
2026-10-23 Step 2.2 (SW1): footprint approved by the user
2026-10-23 Step 2.2 (SW2): EVQ-P7J uses the P7A drawing; KiCad's SW_SPST_EVQP7A matches Panasonic's land pattern
2026-10-23 Step 2.2 (SW2): footprint approved by the user
2026-10-23 Step 2.2 (SW3): KiCad's KingTek 6-way DIP pads match C&K's TDP land pattern; outline differs
2026-10-23 Step 2.2 (SW3): project footprint with KingTek's pads and C&K TDP06's real body and lever side
2026-10-23 Step 2.2 (SW3): footprint approved by the user
2026-10-23 Step 2.2 (RV1-RV3): project footprint built to Alps' RK10J reflow-type PC board drawing
2026-10-23 Step 2.2 (RV1-RV3): footprint approved by the user
2026-10-23 Step 2.2 (TP1-TP8): KiCad's 1.5 mm test pad checked
2026-10-23 Step 2.2 (TP1-TP8): footprint approved by the user
2026-10-23 Step 2.2 (passives): KiCad's IPC 0402/0603/0805 pads checked against Yageo, Panasonic and Murata lands
2026-10-23 Step 2.2 ticked: every footprint checked and approved by the user
2026-10-23 Step 2.3: pin-to-pad check on all 102 symbols; SW1's tabs numbered 4 in a project footprint copy
2026-10-23 Step 2.4: silkscreen check tool; footprint map shared with the pin-to-pad check
2026-10-23 Step 2.4: every footprint copied into IphoneFM.pretty with 0.25 mm silkscreen trimmed 0.20 mm clear of pads
2026-10-23 Step 2.4: pin-1 marks drawn as round dots; SW3's lever line placed for 0.25 mm ink
2026-10-23 Step 2.5: paste check on every footprint; D5's paste made 1:1 with its pads
2026-10-23 Step 2.6: IphoneFM footprints assigned to all 102 symbols
2026-10-23 Step 2.7: ERC 0 errors, kicadcheck --net 11 of 11 on the schematic with footprints assigned
2026-10-23 Step 2.8: U4 side pads 0.28 mm and mask 0.06 mm clear, meeting Skyworks and JLC
2026-10-23 footprints.md: U4 change awaiting the user's check
2026-10-23 Step 2.8 ticked: Phase 2 (footprints) signed off by the user
2026-10-23 Phase 3 scoped; mounting holes H1-H4 agreed with the user
2026-10-23 Step 3.1: board stack-up (JLC0216A) and title block
2026-10-23 Step 3.2: design rules from fab-rules.md in Board Setup and IphoneFM.kicad_dru
2026-10-23 Step 3.2: J1 shell pads widened to a 0.25 mm ring; step ticked
2026-10-23 Step 3.3: net classes checked against fab-rules.md and KiCad's own netlist
2026-10-23 Step 3.4: board outline at the sketch's coordinates, origins on its top-left corner
2026-10-23 Step 3.5: mounting holes H1-H4 in netlist.json, on the schematic, with an M2 footprint
2026-10-23 fp_silk_trim: D1's pin-1 dot no longer repeats on reruns; cut ends keep 0.003 mm spare so a rerun changes nothing
2026-10-23 Step 3.6: MagSafe ring rule areas and a rule against through-hole leads over the ring; edge rule confirmed
2026-10-23 Step 3.7: no fiducials on the board; they go on rails if JLC needs rails
2026-10-23 Step 3.7 note corrected: rails are planned (2.5 mm part-to-edge rule), fiducials go on them
2026-10-23 Step 3.8: empty board read back and checked for the user's review
2026-10-23 Rails on all four edges, in a panel we draw in Phase 8 (the user's point at the 3.8 review: the wheels need a left rail)
2026-10-23 Step 3.8 ticked: the user approved the empty board
2026-10-23 Step 4.1: parts brought across from the schematic (106 footprints), rules restored after KiCad's stale save, mask material named so KiCad keeps its Dk
2026-10-23 Step 4.2: tools/pcb_group.py groups the parts by IC beside the board, live through KiCad's API
2026-10-23 Step 4.2: board saved with the parts grouped beside it; ticked, approved by the user
2026-10-23 Step 4.3: J1 placed and locked at HRO's board-edge line (y 127.77); sketch corrected from flush to 0.4 mm overhang
2026-10-23 Clock clearance 0.4 mm for tracks only; pins keep 0.2 mm (the user's choice at step 4.3)
2026-10-23 Step 4.3: board saved with J1 placed and locked; ticked, approved by the user
2026-10-23 Step 4.4: J2 placed and locked at (54.99, 126.80), barrel out of the right edge; sketch lands corrected to 2.2 mm
2026-10-23 Step 4.4: board saved with J2 placed and locked; ticked, approved by the user
2026-10-23 Step 4.5: wheels placed and locked 5.1 mm in from the left edge so the rim-side peg slot stays on the board; 1.9 mm of wheel past the edge
2026-10-23 Step 4.5: board saved with the wheels placed and locked; ticked, approved by the user
2026-10-23 Step 4.6: board saved with the switches placed and locked; ticked, approved by the user
2026-10-23 Step 4.7: board saved with D1 placed and locked; ticked, approved by the user
2026-10-23 Step 4.8: U2 with its 16 local parts and Y2 with its 3, placed at their pins live (tools/pcb_local.py)
2026-10-23 Step 4.8: board saved with U2 and Y2 placed; ticked, approved by the user
2026-10-23 Step 4.9: U7, the TX filter and U5 placed with no RF crossings (the user's choice); U4's spot moves above U5
2026-10-24 Steps 4.10-4.13: U4, U1, U3/U6/USB parts and the remaining passives placed; U2 and Y2 moved to open the digital corridor; holes locked
2026-10-24 Steps 4.14-4.17: rotations checked, test pads placed, fit checked, kicadcheck --pcb passes; C28 anchored to the filter in netlist.json
2026-10-24 Phase 4: 3D model links restored with Update Footprints from Library (dropped by the API's turn/lock updates); nothing moved
2026-10-24 Step 5.1: ground fan-out, 102 vias and 106 stubs, locked (tools/pcb_fanout.py)
2026-10-24 Steps 5.4-5.6: RF lines laid by hand and locked (tools/pcb_route_rf.py)
2026-10-24 Step 5.7 (part): U2's loop filter routed; routing tools pcb_astar.py and pcb_freeroute.py
2026-10-24 Phase 5: nudges for routing room around U1 (Y2 up 2.5 mm, TP5 beside U1, SWD pads down 3 mm); fan-out redone
2026-10-24 Phase 5, U1 attempt 2 (partial): Y2 beside the wheels, U2's top-left caps up 0.9 mm, U7 2 mm right with its RF segments re-laid; U1's and U2's local links, FSK lines with planned entry vias at U2; cl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
2026-10-24 Phase 5: U1 MICROWIRE pins reordered (28 MUX, 27 CLK, 26 DATA, 25 LE, driven by GPIO) so the four lines reach U2 with no crossing; C5 and R6-R8 moved for routing room; parts provenance list; R6-R8 pl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
2026-10-25 Phase 5: floorplan study round 1 (tools/pcb_floorplan.py): today's layout and three candidates scored by a congestion-aware estimate of the routing
2026-10-25 Phase 5: board re-placed to floorplan B3 (U1 turned to face U2/J1 and U4/D1; U2, Y2 and U7 below U1; U4 with its input parts at the top right); routing cleared for a fresh start
2026-10-25 U1 pins reassigned for the turned U1 of floorplan B3: receiver lines (PB6 FS, PB8 SCL, PB9 RCLK, PB4 RST) and U2 CE (PH1) on the U4/U2 sides, LEDs on PA0-PA2 (TIM2), wheels on PA3-PA5, RF_MODE PA7, C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
2026-10-25 Phase 5 prep for B3: RF keep-out zones, RF lines planned (pcb_route_rf.py place/lay) with 12 part nudges, routing-quality checker (pcb_quality.py), lane plan for review
2026-10-25 Phase 5 prep: RX_RST to PB9 and RX_RCLK to PB4 (TIM3_CH1), U4 corner planned (pcb_route_u4.py) with U4's group 2.5 mm lower, U2 east caps re-stacked for CE, Y2/R4/C11/C12/R9/C5/C18/C19/TP7 and U3 gro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
2026-10-25 Phase 5 WIP: pcb_plan.py fan geometry, U1 escape plan (west and south, in progress), checker refinements; U1's west capacitors re-seated
2026-10-25 Phase 5 prep: U1 escape at its new position, U2 plan (pcb_route_u2.py), U6 channels swapped
    U1 sits at (36.135, 90.595) with its escape planned on all four sides; the U2 plan covers U2's
    pins and parts (FSK with the clock hop, MICROWIRE, the PLL capacitor column, CE, REF20, 3V3
    feeds), the USB pair under U2 up north of U6 (0.7 mm lower) and the two bottom 3V3 links in the
    RF zone the user allowed (RF_BOTTOM_ALLOW). Checker: local pins now count branches; 0 findings
    over the U1, U4, RF and U2 plans. U6's ESD channels swapped in the schematic and netlist.
2026-10-25 Phase 5 prep: J1 corner and west strip plan (pcb_route_j1.py), open-connection lister, U1/U2 gap fixes
2026-10-26 Phase 5 WIP: RST moved to the top layer beside the receiver bundle; attenuator bus plan started (pcb_route_att.py), R10-R15 1.7 mm east
2026-10-26 Phase 5 prep: attenuator bus (pcb_route_att.py) and north band/east edge (pcb_route_north.py) planned; every net now planned
    The attenuator lines cross under the receiver bundle in one hop (RST moved to the top layer to open the bottom
    north of it); R10-R15 1.7 mm east to clear H2. D1's resistors re-placed so VBUS, B, G, R arrive in lane order;
    3V3 trunk on the bottom from FB2/C3 to SW3's row, U4, R20 and down the east edge to R16. Checker 0 findings over
    all seven plans; DRC: only J1's known hole clearances and silkscreen.
2026-10-26 Phase 5 prep: ground vias (pcb_route_gnd.py, step 5.1): exposed-pad arrays, a via per ground pad by nearest clear site; all eight plans checked, 0 findings
2026-10-26 Phase 5 routed (5.1-5.12): eight plans laid and locked, 825 tracks and 180 vias
    Clock class: U1's RCLK/SCK and LMX_CLK/FSK_CLK step out to 0.6 mm right after their exits; the DRC exemption is
    now "Clock escape" rule areas (courtyard + 1.5 mm) round U1, U2 and U4. Checker gains via/hole and clock rules.
    pcb_quality 0 findings on the board, 0 open nets; DRC only J1's known hole clearances, ground vias awaiting the
    pours, and silkscreen. Net-length review: no accidental detours. Review pictures in design/rev-a/review/.
2026-10-26 Phase 6 pours (6.1-6.5): ground on both layers, 123 stitching vias, solid ground at the FMI and GPO parts
    Zones on the outline with 0.2 mm clearance and island removal; pcb_stitch.py grid (3 mm, 1.5 mm in the RF zones);
    solid connections at C35, L1, C37, C38 and five starved pads; copper 71% top, 87% bottom. DRC: only J1's known hole
    clearances and silkscreen. pcb_view.py gains --pours.
2026-10-26 Phase 6 approved (6.6); U2 plan: 3V3 under U6 moved to y 117.0 so the pour joins U6's ground; DRC wrapper shows unconnected items again
2026-10-26 Phase 7 (7.1-7.5): silkscreen references placed and edge outlines trimmed, footprints back on the library grid, J1 NPTH rule; parity, netcheck and kicadcheck pass
2026-10-26 Phase 7 complete: J1's locating holes allowed JLC's 0.20 mm (the user's choice); DRC 0 errors
2026-10-26 Silkscreen labels on the major parts only; the board's tag (CLAUDE WAS HERE over an FM wave); DRC 0 errors
2026-10-26 Phase 8 (8.1-8.3): railed JLC panel (KiKit), Gerbers and drill files, BOM, placement file, assembly drawing
2026-10-26 Phase 8.4: Gerbers read back with gerbonara; SW3's stray pin-1 dot removed; exports scripted (pcb_export.sh)
2026-10-26 Phase 8.5 (part): Gerbers accepted by JLC's quote page; bare-board quote recorded
2026-10-26 Phase 8.3/8.5: JLC placement corrections (rotations and origin shifts fitted to JLC's footprints), verified in JLC's preview; assembly quote recorded
2026-10-26 JLC Basic-library parts for 14 passive types (same values and sizes, equal or higher ratings; datasheets saved); netlist, schematic, board, notes and wiring page updated
2026-10-26 Record the 2- and 5-board quotes after the Basic-library swaps
2026-10-26 Rev A first run: 2 assembled boards (the user's choice)
2026-10-26 Design review for an outside engineer: 4-page PDF (overview, key numbers, main parts, fab, firmware plan, each chain on the schematic with datasheet references, review points) and its package builder
2026-10-26 review/rev-a: the design review PDF with its schematic, JLC files, assembly drawing and board pictures, and a README linking the KiCad project and cited datasheets
2026-11-06 Rev B: front-panel candidate sheet (tuning encoder, station display, power DIP), JLC-stocked parts
2026-11-06 Rev B front panel chosen and datasheet-checked: SIQ-02FVS3 thumbwheel encoder, 4 x GS3011AW-B white digits on an IS31FL3236A driver, DHN-06-V DIP switch
2026-11-06 Rev B: to-scale front-face sketch (wheel, digits, DIP on the Rev A board outline) and an in-case impression
2026-11-06 Rev B front face: new parts in Rev A's left column (digits turned where RV1/RV2 were, wheel at RV3, DIP at SW3), rest of the board kept
2026-11-06 Rev B build procedure: Rev A's order (netlist first, then schematic, footprints, layout) for the front-panel changes
2026-11-06 Rev B B0.1: design and KiCad sources copied from Rev A into design/rev-b and kicad/rev-b, title blocks Rev B; netcheck/kicadcheck take IPHONEFM_REV
2026-11-06 Rev B Phase B1: front panel in netlist.json and the pages
    SW4 Mitsumi SIQ-02FVS3 push-wheel encoder on U1 PA3-PA5 (was the wheel ADC pins) with 10 kOhm pull-ups;
    DS1-DS4 GS3011AW-B white digits driven by U8 IS31FL3236A (VBUS, I2C 0x3C on U1's bus, R_EXT 10 kOhm = 7.6 mA
    per segment, SDB from PC13 with a 100 kOhm pull-down so it is off before USB set-up); SW3 now Diptronics
    DHN-06-V. RV1-RV3 and C39-C41 removed. bom.md chains 6/9/10 and the U1 pin map, sourcing, provenance and
    the wiring page updated; netcheck 19/19 on Rev B and Rev A.
2026-11-06 Rev B: B1 approved; schematic tools take IPHONEFM_REV (rollback point before Phase B2)
2026-11-06 Rev B Phase B2: the front panel on the schematic
    Symbols from the makers' documents: U8 IS31FL3236A (QFN-44, Lumissil Rev. I and its evaluation board, both
    saved), DS1-DS4 GS3011AW-B (KiCad's KCSA02-105, same ten pins as Guangcai p3, LED pins passive), SW4 SIQ-02FVS3
    (terminals 1-4, frame tabs 5-10). RV1-RV3, C39-C41 and their wires removed; new Display zone under U1 with U8's
    outputs wired straight across to the digits; encoder pull-ups on their rows. Wired, labelled and flagged with the
    Rev A tools (now revision-aware); ERC 0 errors, kicadcheck net/BOM 17/17; Rev A sheet unchanged (11/11).
2026-11-06 Rev B Phase B3: footprints for the front panel
    U8, DS1-DS4 and SW4 are built from the makers' own land patterns (tools/fp_rev_b.py):
    Lumissil QFN-44 5x5 0.4 mm with the centre pad joined to pins 17 and 39, Guangcai GS3011
    soldering pads, Mitsumi SIQ-02FVS3 land dimensions. SW3 (Diptronics DHN-06-V) keeps KiCad's
    Omron A6H-6101 pads, which are Diptronics' layout exactly. To-scale overlays in
    design/rev-b/footprint-overlays.png. Footprints assigned; ERC 0 errors, kicadcheck 17/17,
    pin-to-pad 114/114, silk and paste checks pass. Also removes the wheels' unused library
    symbol that B2.1 meant to remove.
2026-11-06 Rev B Phase B4 (part): new parts on the board, SW3, SW4, DS1-DS4 and R30-R32 placed, Rev A copper under them taken up; U8's spot to choose
2026-11-06 Rev B Phase B4: U8 above the display with its parts, C44, TP2 moved; checks pass
    U8 at spot B (the user's choice), control pins toward the top edge, R28/C43/R29
    straight out from their pins, C42 and C44 along the top edge above H1. TP2 out
    from under DS1, the 3V3 run to SW3 kept whole. DRC parity 0, kicadcheck --pcb
    all pass; U8 pin 37's starved thermal and the unrouted nets are for B5.
2026-11-07 Rev B Phase B5: front panel routed; checks pass
    U8's 32 outputs reach DS1-DS4 on two buses, with 0.127 mm tracks and
    gaps and 0.4/0.2 mm vias inside the "U8 fan-out" rule areas (the user's
    approval). The outputs are mapped to segments in board order (labels on
    the sheet), and each digit's anode is fed at pin 8 (pins 3 and 8 are one
    node). VBUS, 3V3, the I2C/SDB lines, the encoder lines and RF_MODE are
    routed, U8's ground and the north band's ground are joined to the rest.
    DRC: 0 errors, 0 unconnected, 0 parity differences; pcb_quality 0 findings.
2026-11-07 Rev B B5.2: schematic-display.png re-rendered with the segment labels
2026-11-07 Rev B Phase B6 (part): stitching grid relaid in the left column, silkscreen cut back from the edge
2026-11-07 Rev B Phases B6-B8: pours stitched, silkscreen, checks pass, panel and JLC files
2026-11-11 Rev C: U8 fan-out re-planned for JLC's standard 0.3 mm vias; checks pass
2026-11-11 Rev C: panel rule and project files regenerated with the 0.45/0.3 mm fan-out via rule
